davidv1992/Trans1/(list of files, drawings)

Other design files:
logic_sim/processor.circ
