davidv1992/Trans1/designs/adder/sel/sel.kicad_pcb

## KiCad design designs/adder/sel/sel.kicad_pcb (2025-08-03)

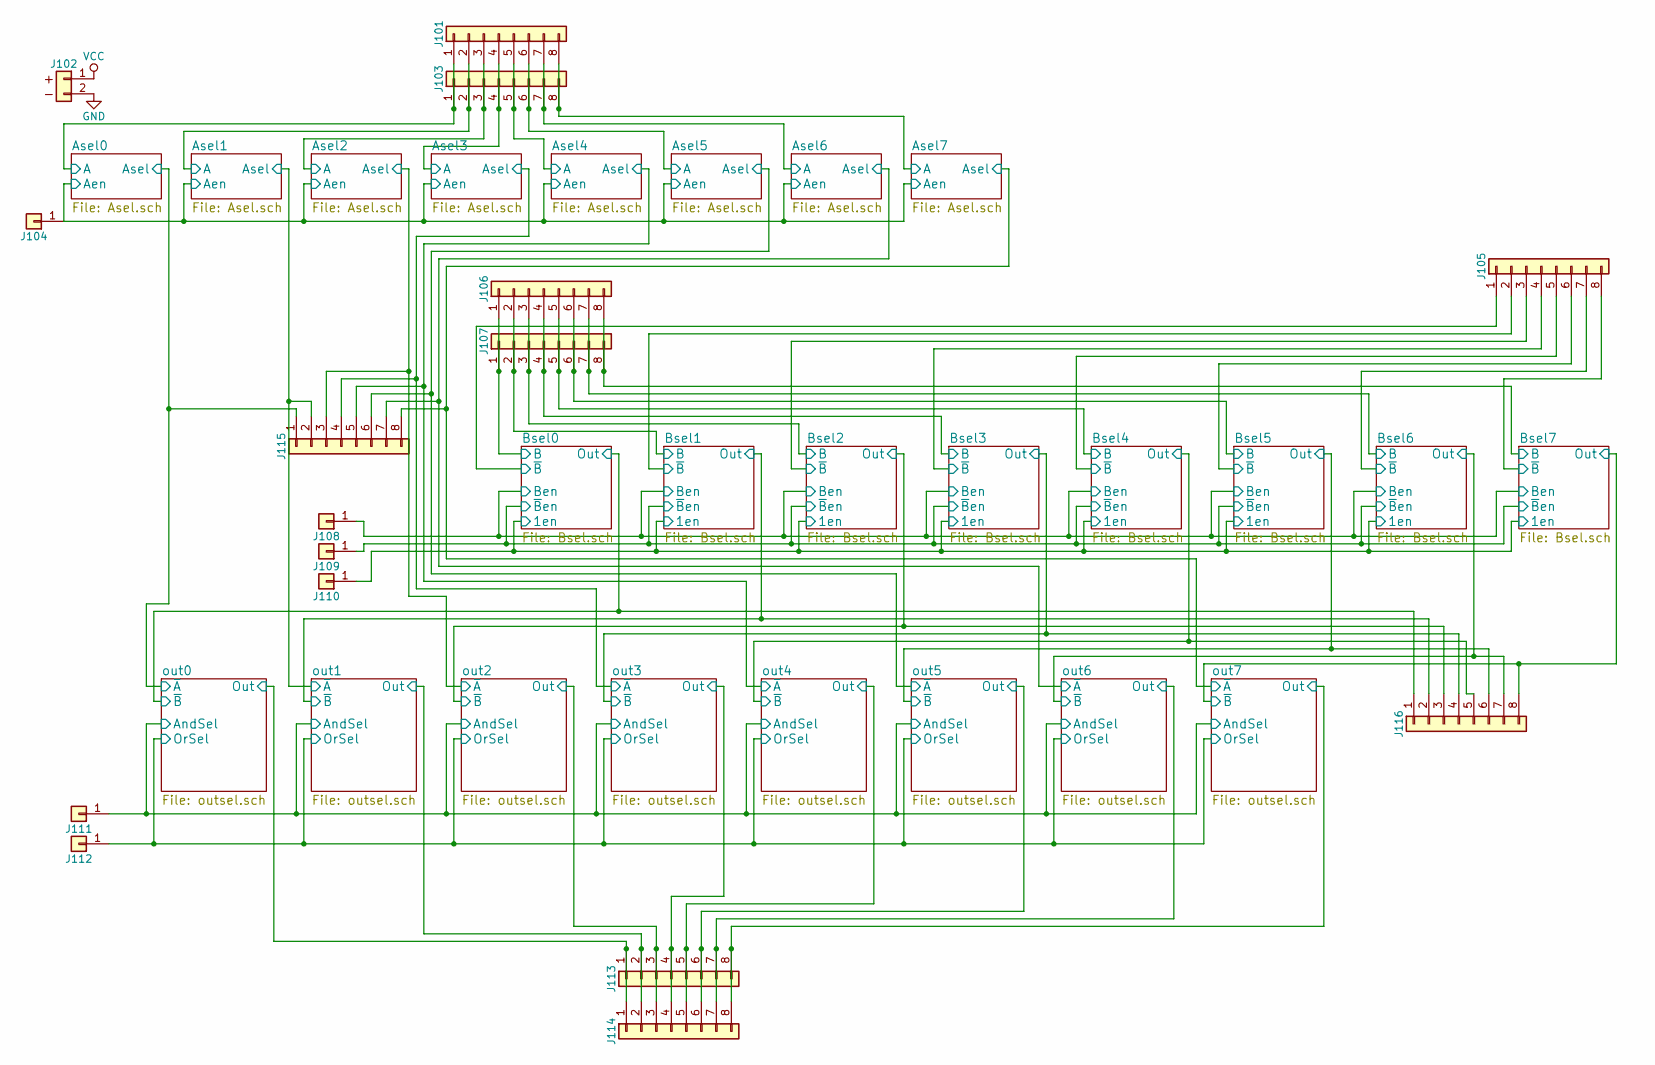
[picture p10: schematic sel.sch]

Parts:
J101, J103, J105, J106, J107, J113, J114, J115, J116: Conn_01x08; PH_1x8
J102: Conn_01x02_Power; PH_1x2
J104, J108, J109, J110, J111, J112: Conn_01x01; PH_1x1

Connections:
/Asel0/A: J101.1, J103.1; also elsewhere on the board
/Asel0/Aen: J104.1; also elsewhere on the board
/Asel0/Asel: J115.1; also elsewhere on the board
/Asel1/A: J101.2, J103.2; also elsewhere on the board
/Asel1/Asel: J115.2; also elsewhere on the board
/Asel2/A: J101.3, J103.3; also elsewhere on the board
/Asel2/Asel: J115.3; also elsewhere on the board
/Asel3/A: J101.4, J103.4; also elsewhere on the board
/Asel3/Asel: J115.4; also elsewhere on the board
/Asel4/A: J101.5, J103.5; also elsewhere on the board
/Asel4/Asel: J115.5; also elsewhere on the board
/Asel5/A: J101.6, J103.6; also elsewhere on the board
/Asel5/Asel: J115.6; also elsewhere on the board
/Asel6/A: J101.7, J103.7; also elsewhere on the board
/Asel6/Asel: J115.7; also elsewhere on the board
/Asel7/A: J101.8, J103.8; also elsewhere on the board
/Asel7/Asel: J115.8; also elsewhere on the board
/Bsel0/1en: J110.1; also elsewhere on the board
/Bsel0/B: J106.1, J107.1; also elsewhere on the board
/Bsel0/Ben: J108.1; also elsewhere on the board
/Bsel0/Out: J116.1; also elsewhere on the board
/Bsel0/~B~: J105.1; also elsewhere on the board
/Bsel0/~B~en: J109.1; also elsewhere on the board
/Bsel1/B: J106.2, J107.2; also elsewhere on the board
/Bsel1/Out: J116.2; also elsewhere on the board
/Bsel1/~B~: J105.2; also elsewhere on the board
/Bsel2/B: J106.3, J107.3; also elsewhere on the board
/Bsel2/Out: J116.3; also elsewhere on the board
/Bsel2/~B~: J105.3; also elsewhere on the board
/Bsel3/B: J106.4, J107.4; also elsewhere on the board
/Bsel3/Out: J116.4; also elsewhere on the board
/Bsel3/~B~: J105.4; also elsewhere on the board
/Bsel4/B: J106.5, J107.5; also elsewhere on the board
/Bsel4/Out: J116.5; also elsewhere on the board
/Bsel4/~B~: J105.5; also elsewhere on the board
/Bsel5/B: J106.6, J107.6; also elsewhere on the board
/Bsel5/Out: J116.6; also elsewhere on the board
/Bsel5/~B~: J105.6; also elsewhere on the board
/Bsel6/B: J106.7, J107.7; also elsewhere on the board
/Bsel6/Out: J116.7; also elsewhere on the board
/Bsel6/~B~: J105.7; also elsewhere on the board
/Bsel7/B: J106.8, J107.8; also elsewhere on the board
/Bsel7/Out: J116.8; also elsewhere on the board
/Bsel7/~B~: J105.8; also elsewhere on the board
/out0/AndSel: J111.1; also elsewhere on the board
/out0/OrSel: J112.1; also elsewhere on the board
/out0/Out: J113.1, J114.1; also elsewhere on the board
/out1/Out: J113.2, J114.2; also elsewhere on the board
/out2/Out: J113.3, J114.3; also elsewhere on the board
/out3/Out: J113.4, J114.4; also elsewhere on the board
/out4/Out: J113.5, J114.5; also elsewhere on the board
/out5/Out: J113.6, J114.6; also elsewhere on the board
/out6/Out: J113.7, J114.7; also elsewhere on the board
/out7/Out: J113.8, J114.8; also elsewhere on the board
GND: J102.2; also elsewhere on the board
VCC: J102.1; also elsewhere on the board

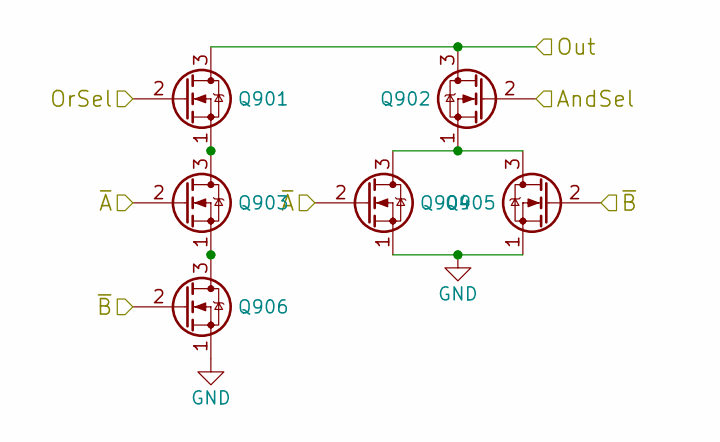
[picture p11: schematic outsel.sch]

Parts:
Q201, Q202, Q203, Q204, Q205, Q206: 2N7000; TO-92-FET

Connections:
/Asel0/Asel: Q203.2 (G), Q204.2 (G); also elsewhere on the board
/Bsel0/Out: Q205.2 (G), Q206.2 (G); also elsewhere on the board
/out0/AndSel: Q202.2 (G); also elsewhere on the board
/out0/OrSel: Q201.2 (G); also elsewhere on the board
/out0/Out: Q201.3 (D), Q202.3 (D); also elsewhere on the board
GND: Q204.1 (S), Q205.1 (S), Q206.1 (S); also elsewhere on the board
unnamed: Q201.1 (S), Q203.3 (D)
unnamed: Q202.1 (S), Q204.3 (D), Q205.3 (D)
unnamed: Q203.1 (S), Q206.3 (D)

Parts of its further copies:
Q301, Q302, Q303, Q304, Q305, Q306, Q401, Q402, Q403, Q404, Q405, Q406, Q501, Q502, Q503, Q504, Q505, Q506, Q601, Q602, Q603, Q604, Q605, Q606, Q701, Q702, Q703, Q704, Q705, Q706, Q801, Q802, Q803, Q804, Q805, Q806, Q901, Q902, Q903, Q904, Q905, Q906: 2N7000; TO-92-FET

Connections of its further copies:
/Asel1/Asel: Q903.2 (G), Q904.2 (G); also elsewhere on the board
/Asel2/Asel: Q303.2 (G), Q304.2 (G); also elsewhere on the board
/Asel3/Asel: Q403.2 (G), Q404.2 (G); also elsewhere on the board
/Asel4/Asel: Q503.2 (G), Q504.2 (G); also elsewhere on the board
/Asel5/Asel: Q603.2 (G), Q604.2 (G); also elsewhere on the board
/Asel6/Asel: Q703.2 (G), Q704.2 (G); also elsewhere on the board
/Asel7/Asel: Q803.2 (G), Q804.2 (G); also elsewhere on the board
/Bsel1/Out: Q905.2 (G), Q906.2 (G); also elsewhere on the board
/Bsel2/Out: Q305.2 (G), Q306.2 (G); also elsewhere on the board
/Bsel3/Out: Q405.2 (G), Q406.2 (G); also elsewhere on the board
/Bsel4/Out: Q505.2 (G), Q506.2 (G); also elsewhere on the board
/Bsel5/Out: Q605.2 (G), Q606.2 (G); also elsewhere on the board
/Bsel6/Out: Q705.2 (G), Q706.2 (G); also elsewhere on the board
/Bsel7/Out: Q805.2 (G), Q806.2 (G); also elsewhere on the board
/out0/AndSel: Q302.2 (G), Q402.2 (G), Q502.2 (G), Q602.2 (G), Q702.2 (G), Q802.2 (G), Q902.2 (G); also elsewhere on the board
/out0/OrSel: Q301.2 (G), Q401.2 (G), Q501.2 (G), Q601.2 (G), Q701.2 (G), Q801.2 (G), Q901.2 (G); also elsewhere on the board
/out1/Out: Q901.3 (D), Q902.3 (D); also elsewhere on the board
/out2/Out: Q301.3 (D), Q302.3 (D); also elsewhere on the board
/out3/Out: Q401.3 (D), Q402.3 (D); also elsewhere on the board
/out4/Out: Q501.3 (D), Q502.3 (D); also elsewhere on the board
/out5/Out: Q601.3 (D), Q602.3 (D); also elsewhere on the board
/out6/Out: Q701.3 (D), Q702.3 (D); also elsewhere on the board
/out7/Out: Q801.3 (D), Q802.3 (D); also elsewhere on the board
GND: Q304.1 (S), Q305.1 (S), Q306.1 (S), Q404.1 (S), Q405.1 (S), Q406.1 (S), Q504.1 (S), Q505.1 (S), Q506.1 (S), Q604.1 (S), Q605.1 (S), Q606.1 (S), Q704.1 (S), Q705.1 (S), Q706.1 (S), Q804.1 (S), Q805.1 (S), Q806.1 (S), Q904.1 (S), Q905.1 (S), Q906.1 (S); also elsewhere on the board
unnamed: Q301.1 (S), Q303.3 (D)
unnamed: Q302.1 (S), Q304.3 (D), Q305.3 (D)
unnamed: Q303.1 (S), Q306.3 (D)
unnamed: Q401.1 (S), Q403.3 (D)
unnamed: Q402.1 (S), Q404.3 (D), Q405.3 (D)
unnamed: Q403.1 (S), Q406.3 (D)
unnamed: Q501.1 (S), Q503.3 (D)
unnamed: Q502.1 (S), Q504.3 (D), Q505.3 (D)
unnamed: Q503.1 (S), Q506.3 (D)
unnamed: Q601.1 (S), Q603.3 (D)
unnamed: Q602.1 (S), Q604.3 (D), Q605.3 (D)
unnamed: Q603.1 (S), Q606.3 (D)
unnamed: Q701.1 (S), Q703.3 (D)
unnamed: Q702.1 (S), Q704.3 (D), Q705.3 (D)
unnamed: Q703.1 (S), Q706.3 (D)
unnamed: Q801.1 (S), Q803.3 (D)
unnamed: Q802.1 (S), Q804.3 (D), Q805.3 (D)
unnamed: Q803.1 (S), Q806.3 (D)
unnamed: Q901.1 (S), Q903.3 (D)
unnamed: Q902.1 (S), Q904.3 (D), Q905.3 (D)
unnamed: Q903.1 (S), Q906.3 (D)

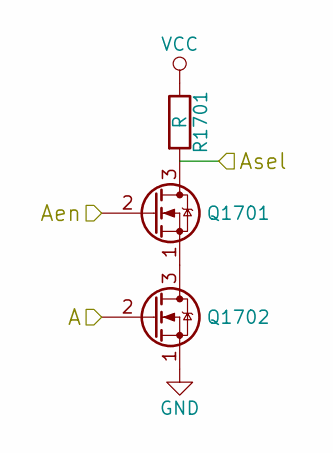
[picture p12: schematic Asel.sch]

Parts:
Q1001, Q1002: 2N7000; TO-92-FET
R1001: R; R_small

Connections:
/Asel0/A: Q1002.2 (G); also elsewhere on the board
/Asel0/Aen: Q1001.2 (G); also elsewhere on the board
/Asel0/Asel: Q1001.3 (D), R1001.2; also elsewhere on the board
GND: Q1002.1 (S); also elsewhere on the board
unnamed: Q1001.1 (S), Q1002.3 (D)
VCC: R1001.1; also elsewhere on the board

Parts of its further copies:
Q1101, Q1102, Q1201, Q1202, Q1301, Q1302, Q1401, Q1402, Q1501, Q1502, Q1601, Q1602, Q1701, Q1702: 2N7000; TO-92-FET
R1101, R1201, R1301, R1401, R1501, R1601, R1701: R; R_small

Connections of its further copies:
/Asel0/Aen: Q1101.2 (G), Q1201.2 (G), Q1301.2 (G), Q1401.2 (G), Q1501.2 (G), Q1601.2 (G), Q1701.2 (G); also elsewhere on the board
/Asel1/A: Q1102.2 (G); also elsewhere on the board
/Asel1/Asel: Q1101.3 (D), R1101.2; also elsewhere on the board
/Asel2/A: Q1202.2 (G); also elsewhere on the board
/Asel2/Asel: Q1201.3 (D), R1201.2; also elsewhere on the board
/Asel3/A: Q1302.2 (G); also elsewhere on the board
/Asel3/Asel: Q1301.3 (D), R1301.2; also elsewhere on the board
/Asel4/A: Q1402.2 (G); also elsewhere on the board
/Asel4/Asel: Q1401.3 (D), R1401.2; also elsewhere on the board
/Asel5/A: Q1502.2 (G); also elsewhere on the board
/Asel5/Asel: Q1501.3 (D), R1501.2; also elsewhere on the board
/Asel6/A: Q1602.2 (G); also elsewhere on the board
/Asel6/Asel: Q1601.3 (D), R1601.2; also elsewhere on the board
/Asel7/A: Q1702.2 (G); also elsewhere on the board
/Asel7/Asel: Q1701.3 (D), R1701.2; also elsewhere on the board
GND: Q1102.1 (S), Q1202.1 (S), Q1302.1 (S), Q1402.1 (S), Q1502.1 (S), Q1602.1 (S), Q1702.1 (S); also elsewhere on the board
unnamed: Q1101.1 (S), Q1102.3 (D)
unnamed: Q1201.1 (S), Q1202.3 (D)
unnamed: Q1301.1 (S), Q1302.3 (D)
unnamed: Q1401.1 (S), Q1402.3 (D)
unnamed: Q1501.1 (S), Q1502.3 (D)
unnamed: Q1601.1 (S), Q1602.3 (D)
unnamed: Q1701.1 (S), Q1702.3 (D)
VCC: R1101.1, R1201.1, R1301.1, R1401.1, R1501.1, R1601.1, R1701.1; also elsewhere on the board

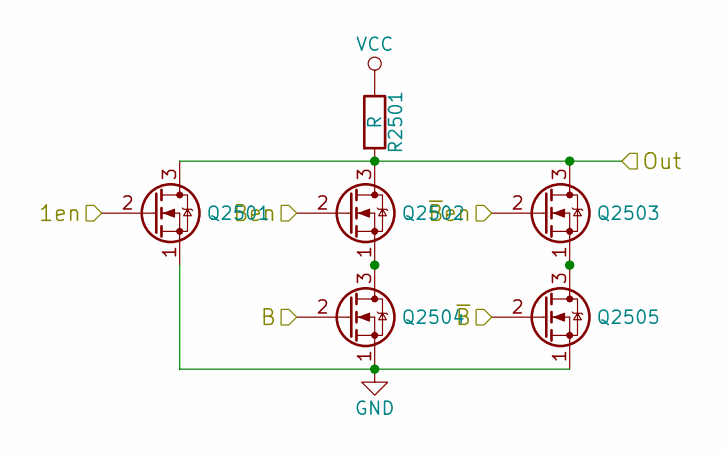
[picture p13: schematic Bsel.sch]

Parts:
Q1801, Q1802, Q1803, Q1804, Q1805: 2N7000; TO-92-FET
R1801: R; R_small

Connections:
/Bsel0/1en: Q1801.2 (G); also elsewhere on the board
/Bsel0/B: Q1804.2 (G); also elsewhere on the board
/Bsel0/Ben: Q1802.2 (G); also elsewhere on the board
/Bsel0/Out: Q1801.3 (D), Q1802.3 (D), Q1803.3 (D), R1801.2; also elsewhere on the board
/Bsel0/~B~: Q1805.2 (G); also elsewhere on the board
/Bsel0/~B~en: Q1803.2 (G); also elsewhere on the board
GND: Q1801.1 (S), Q1804.1 (S), Q1805.1 (S); also elsewhere on the board
unnamed: Q1802.1 (S), Q1804.3 (D)
unnamed: Q1803.1 (S), Q1805.3 (D)
VCC: R1801.1; also elsewhere on the board

Parts of its further copies:
Q1901, Q1902, Q1903, Q1904, Q1905, Q2001, Q2002, Q2003, Q2004, Q2005, Q2101, Q2102, Q2103, Q2104, Q2105, Q2201, Q2202, Q2203, Q2204, Q2205, Q2301, Q2302, Q2303, Q2304, Q2305, Q2401, Q2402, Q2403, Q2404, Q2405, Q2501, Q2502, Q2503, Q2504, Q2505: 2N7000; TO-92-FET
R1901, R2001, R2101, R2201, R2301, R2401, R2501: R; R_small

Connections of its further copies:
/Bsel0/1en: Q1901.2 (G), Q2001.2 (G), Q2101.2 (G), Q2201.2 (G), Q2301.2 (G), Q2401.2 (G), Q2501.2 (G); also elsewhere on the board
/Bsel0/Ben: Q1902.2 (G), Q2002.2 (G), Q2102.2 (G), Q2202.2 (G), Q2302.2 (G), Q2402.2 (G), Q2502.2 (G); also elsewhere on the board
/Bsel0/~B~en: Q1903.2 (G), Q2003.2 (G), Q2103.2 (G), Q2203.2 (G), Q2303.2 (G), Q2403.2 (G), Q2503.2 (G); also elsewhere on the board
/Bsel1/B: Q1904.2 (G); also elsewhere on the board
/Bsel1/Out: Q1901.3 (D), Q1902.3 (D), Q1903.3 (D), R1901.2; also elsewhere on the board
/Bsel1/~B~: Q1905.2 (G); also elsewhere on the board
/Bsel2/B: Q2004.2 (G); also elsewhere on the board
/Bsel2/Out: Q2001.3 (D), Q2002.3 (D), Q2003.3 (D), R2001.2; also elsewhere on the board
/Bsel2/~B~: Q2005.2 (G); also elsewhere on the board
/Bsel3/B: Q2104.2 (G); also elsewhere on the board
/Bsel3/Out: Q2101.3 (D), Q2102.3 (D), Q2103.3 (D), R2101.2; also elsewhere on the board
/Bsel3/~B~: Q2105.2 (G); also elsewhere on the board
/Bsel4/B: Q2204.2 (G); also elsewhere on the board
/Bsel4/Out: Q2201.3 (D), Q2202.3 (D), Q2203.3 (D), R2201.2; also elsewhere on the board
/Bsel4/~B~: Q2205.2 (G); also elsewhere on the board
/Bsel5/B: Q2304.2 (G); also elsewhere on the board
/Bsel5/Out: Q2301.3 (D), Q2302.3 (D), Q2303.3 (D), R2301.2; also elsewhere on the board
/Bsel5/~B~: Q2305.2 (G); also elsewhere on the board
/Bsel6/B: Q2404.2 (G); also elsewhere on the board
/Bsel6/Out: Q2401.3 (D), Q2402.3 (D), Q2403.3 (D), R2401.2; also elsewhere on the board
/Bsel6/~B~: Q2405.2 (G); also elsewhere on the board
/Bsel7/B: Q2504.2 (G); also elsewhere on the board
/Bsel7/Out: Q2501.3 (D), Q2502.3 (D), Q2503.3 (D), R2501.2; also elsewhere on the board
/Bsel7/~B~: Q2505.2 (G); also elsewhere on the board
GND: Q1901.1 (S), Q1904.1 (S), Q1905.1 (S), Q2001.1 (S), Q2004.1 (S), Q2005.1 (S), Q2101.1 (S), Q2104.1 (S), Q2105.1 (S), Q2201.1 (S), Q2204.1 (S), Q2205.1 (S), Q2301.1 (S), Q2304.1 (S), Q2305.1 (S), Q2401.1 (S), Q2404.1 (S), Q2405.1 (S), Q2501.1 (S), Q2504.1 (S), Q2505.1 (S); also elsewhere on the board
unnamed: Q1902.1 (S), Q1904.3 (D)
unnamed: Q1903.1 (S), Q1905.3 (D)
unnamed: Q2002.1 (S), Q2004.3 (D)
unnamed: Q2003.1 (S), Q2005.3 (D)
unnamed: Q2102.1 (S), Q2104.3 (D)
unnamed: Q2103.1 (S), Q2105.3 (D)
unnamed: Q2202.1 (S), Q2204.3 (D)
unnamed: Q2203.1 (S), Q2205.3 (D)
unnamed: Q2302.1 (S), Q2304.3 (D)
unnamed: Q2303.1 (S), Q2305.3 (D)
unnamed: Q2402.1 (S), Q2404.3 (D)
unnamed: Q2403.1 (S), Q2405.3 (D)
unnamed: Q2502.1 (S), Q2504.3 (D)
unnamed: Q2503.1 (S), Q2505.3 (D)
VCC: R1901.1, R2001.1, R2101.1, R2201.1, R2301.1, R2401.1, R2501.1; also elsewhere on the board

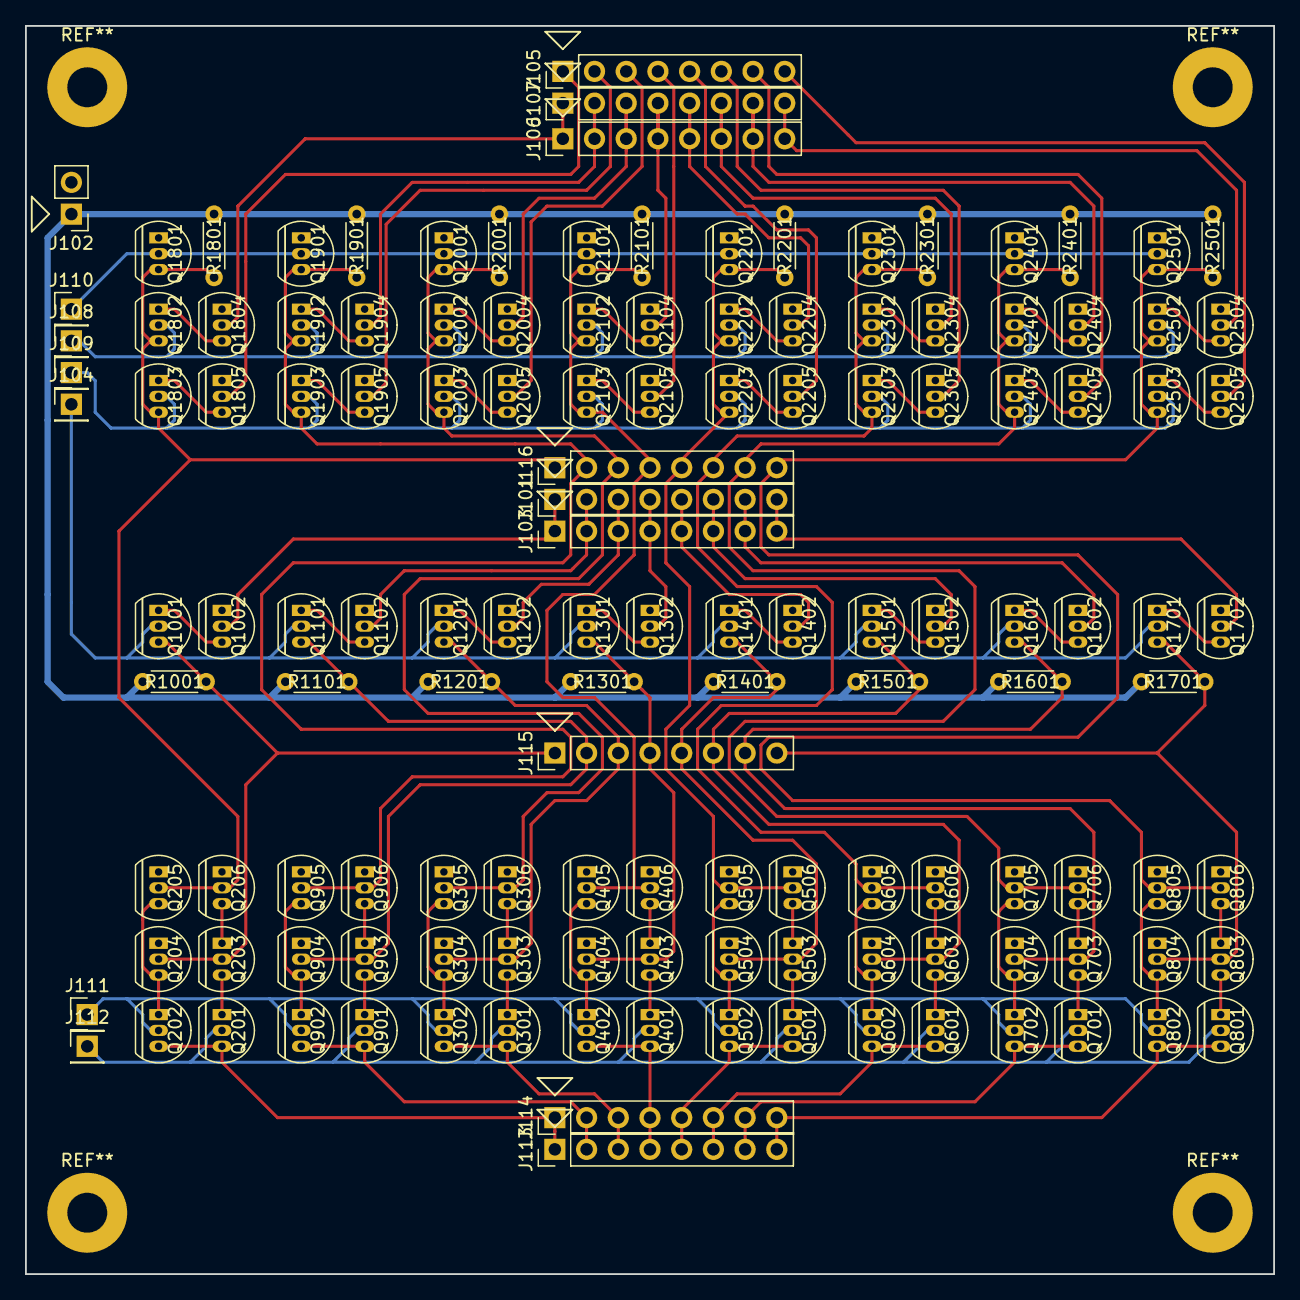
[picture p14: board sel.kicad_pcb from above]

Board: 2 copper layers, 100.0 x 100.0 mm, 136 parts (0 on the bottom side), 104 nets.
