davidv1992/Trans1/designs/memory/membase/membase.kicad_pcb

## KiCad design designs/memory/membase/membase.kicad_pcb (2025-08-03)

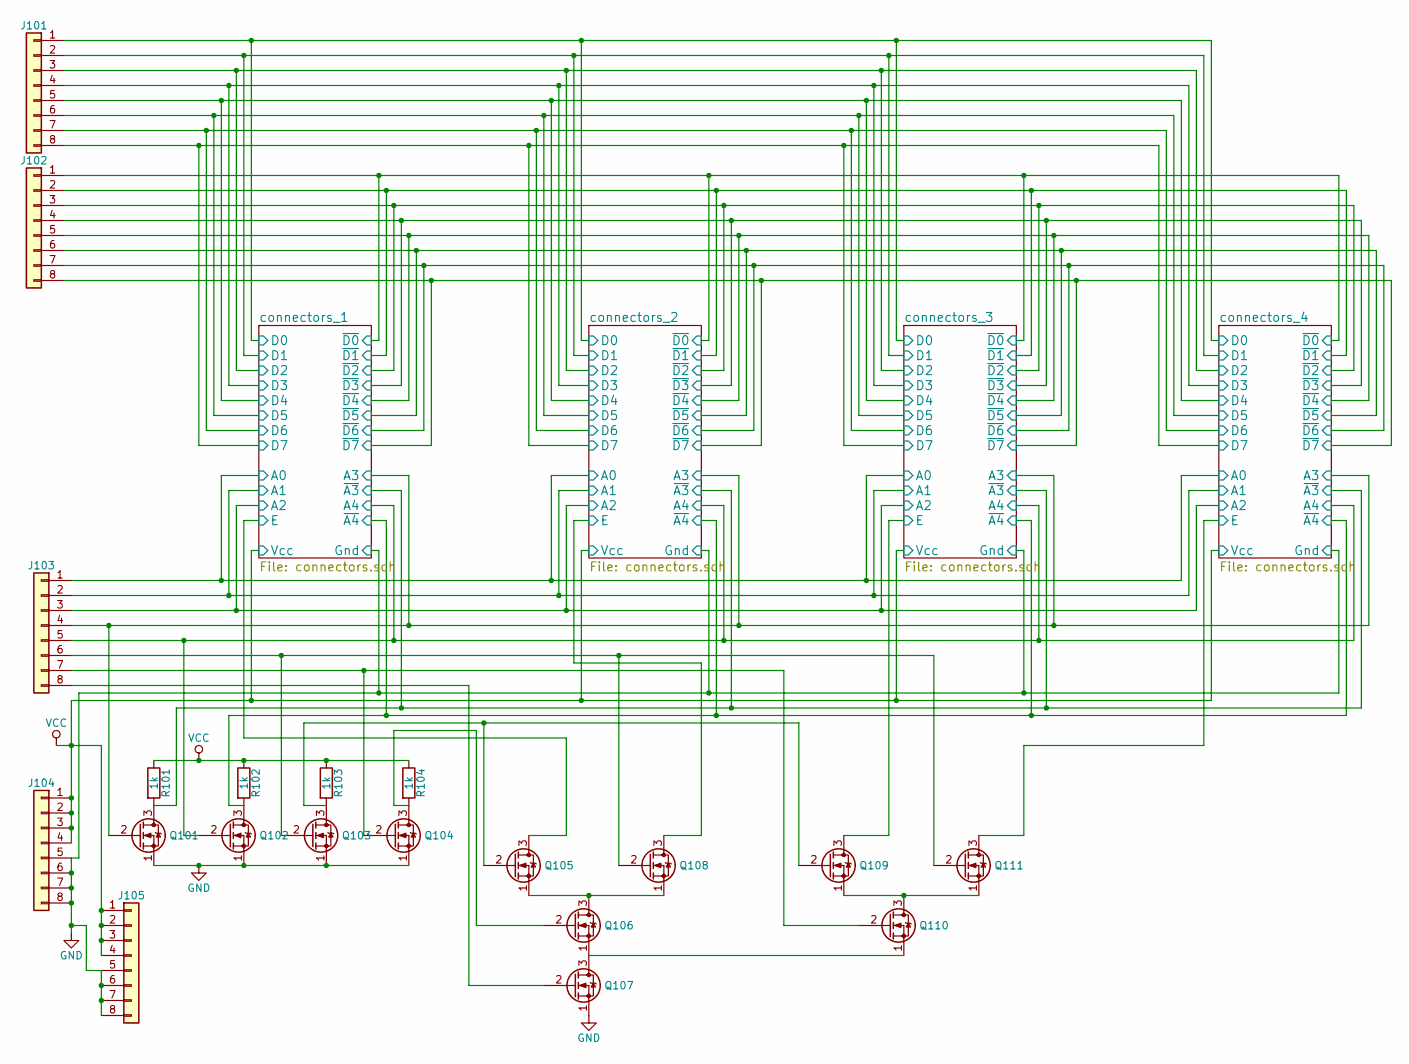
[picture p15: schematic membase.sch]

Parts:
J101, J102, J103, J104, J105: Conn_01x08; PH_1x8
Q101, Q102, Q103, Q104, Q105, Q106, Q107, Q108, Q109, Q110, Q111: 2N7000; TO-92-FET
R101, R102, R103, R104: 1k; R_small

Connections:
/connectors_1/A0: J103.1; also elsewhere on the board
/connectors_1/A1: J103.2; also elsewhere on the board
/connectors_1/A2: J103.3; also elsewhere on the board
/connectors_1/A3: J103.4, Q101.2 (G); also elsewhere on the board
/connectors_1/A4: J103.5, Q102.2 (G); also elsewhere on the board
/connectors_1/D0: J101.1; also elsewhere on the board
/connectors_1/D1: J101.2; also elsewhere on the board
/connectors_1/D2: J101.3; also elsewhere on the board
/connectors_1/D3: J101.4; also elsewhere on the board
/connectors_1/D4: J101.5; also elsewhere on the board
/connectors_1/D5: J101.6; also elsewhere on the board
/connectors_1/D6: J101.7; also elsewhere on the board
/connectors_1/D7: J101.8; also elsewhere on the board
/connectors_1/E: Q105.3 (D); also elsewhere on the board
/connectors_1/~A3: Q101.3 (D), R101.2; also elsewhere on the board
/connectors_1/~A4: Q102.3 (D), R102.2; also elsewhere on the board
/connectors_1/~D0: J102.1; also elsewhere on the board
/connectors_1/~D1: J102.2; also elsewhere on the board
/connectors_1/~D2: J102.3; also elsewhere on the board
/connectors_1/~D3: J102.4; also elsewhere on the board
/connectors_1/~D4: J102.5; also elsewhere on the board
/connectors_1/~D5: J102.6; also elsewhere on the board
/connectors_1/~D6: J102.7; also elsewhere on the board
/connectors_1/~D7: J102.8; also elsewhere on the board
/connectors_2/E: Q108.3 (D); also elsewhere on the board
/connectors_3/E: Q109.3 (D); also elsewhere on the board
/connectors_4/E: Q111.3 (D); also elsewhere on the board
GND: J104.5, J104.6, J104.7, J104.8, J105.5, J105.6, J105.7, J105.8, Q101.1 (S), Q102.1 (S), Q103.1 (S), Q104.1 (S), Q107.1 (S); also elsewhere on the board
unnamed: J103.6, Q103.2 (G), Q108.2 (G), Q111.2 (G)
unnamed: J103.7, Q104.2 (G), Q110.2 (G)
unnamed: J103.8, Q107.2 (G)
unnamed: Q103.3 (D), Q105.2 (G), Q109.2 (G), R103.2
unnamed: Q104.3 (D), Q106.2 (G), R104.2
unnamed: Q105.1 (S), Q106.3 (D), Q108.1 (S)
unnamed: Q106.1 (S), Q107.3 (D), Q110.1 (S)
unnamed: Q109.1 (S), Q110.3 (D), Q111.1 (S)
VCC: J104.1, J104.2, J104.3, J104.4, J105.1, J105.2, J105.3, J105.4, R101.1, R102.1, R103.1, R104.1; also elsewhere on the board

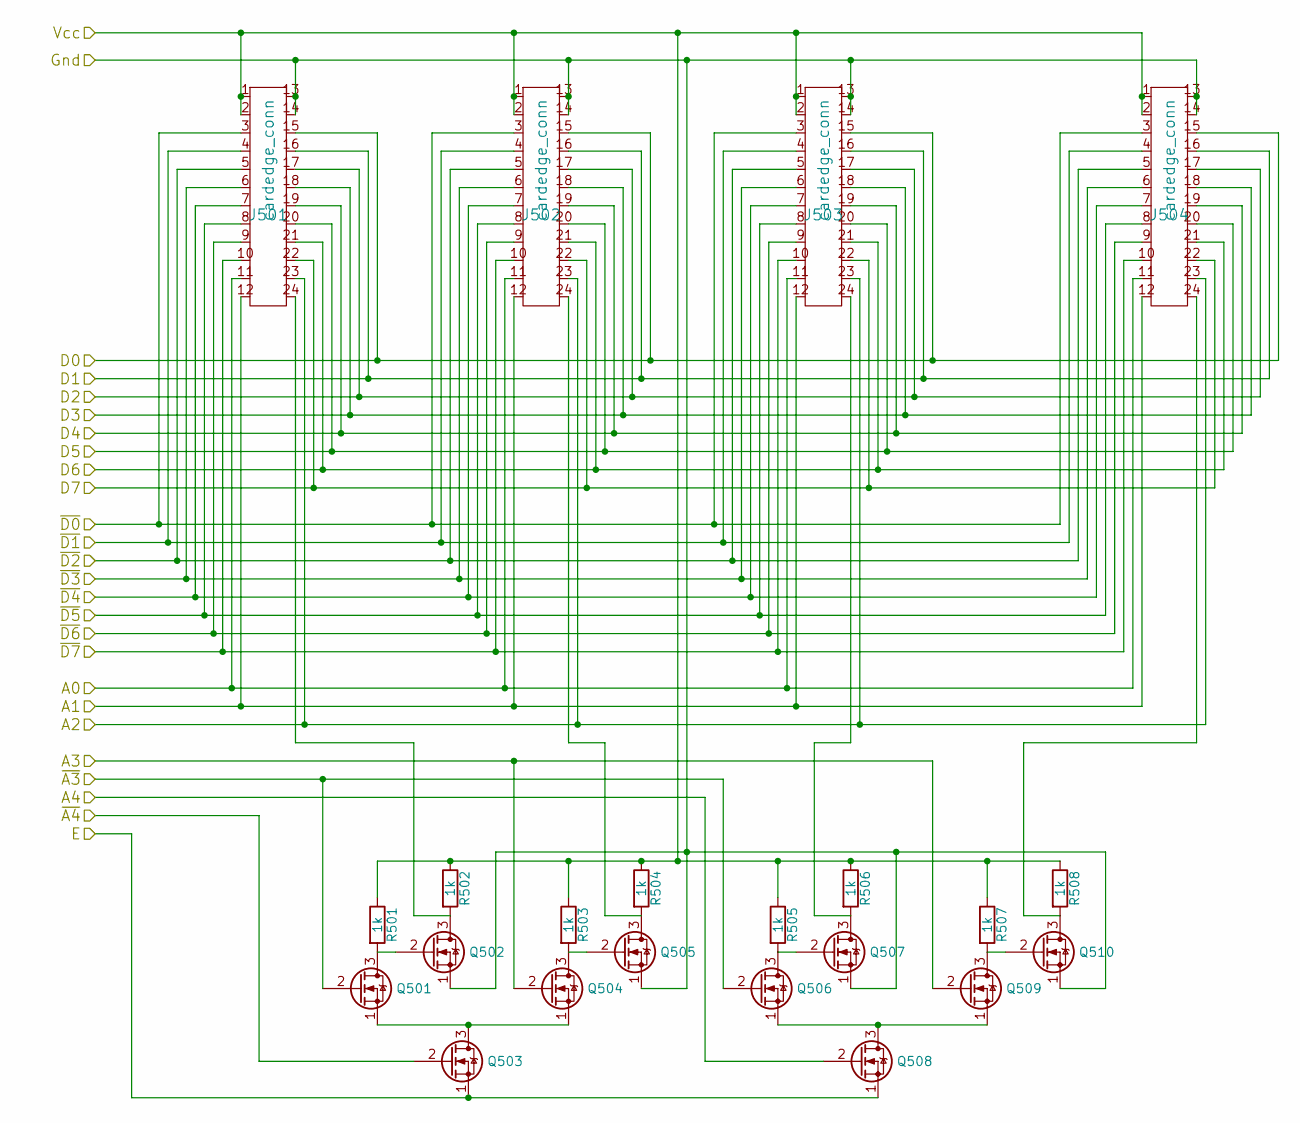
[picture p16: schematic connectors.sch]

Parts:
J201, J202, J203, J204: cardedge_conn; cardedge_conn_12p
Q201, Q202, Q203, Q204, Q205, Q206, Q207, Q208, Q209, Q210: 2N7000; TO-92-FET
R201, R202, R203, R204, R205, R206, R207, R208: 1k; R_small

Connections:
/connectors_1/A0: J201.11, J202.11, J203.11, J204.11; also elsewhere on the board
/connectors_1/A1: J201.12, J202.12, J203.12, J204.12; also elsewhere on the board
/connectors_1/A2: J201.23, J202.23, J203.23, J204.23; also elsewhere on the board
/connectors_1/A3: Q204.2 (G), Q209.2 (G); also elsewhere on the board
/connectors_1/A4: Q208.2 (G); also elsewhere on the board
/connectors_1/D0: J201.15, J202.15, J203.15, J204.15; also elsewhere on the board
/connectors_1/D1: J201.16, J202.16, J203.16, J204.16; also elsewhere on the board
/connectors_1/D2: J201.17, J202.17, J203.17, J204.17; also elsewhere on the board
/connectors_1/D3: J201.18, J202.18, J203.18, J204.18; also elsewhere on the board
/connectors_1/D4: J201.19, J202.19, J203.19, J204.19; also elsewhere on the board
/connectors_1/D5: J201.20, J202.20, J203.20, J204.20; also elsewhere on the board
/connectors_1/D6: J201.21, J202.21, J203.21, J204.21; also elsewhere on the board
/connectors_1/D7: J201.22, J202.22, J203.22, J204.22; also elsewhere on the board
/connectors_1/E: Q203.1 (S), Q208.1 (S); also elsewhere on the board
/connectors_1/~A3: Q201.2 (G), Q206.2 (G); also elsewhere on the board
/connectors_1/~A4: Q203.2 (G); also elsewhere on the board
/connectors_1/~D0: J201.3, J202.3, J203.3, J204.3; also elsewhere on the board
/connectors_1/~D1: J201.4, J202.4, J203.4, J204.4; also elsewhere on the board
/connectors_1/~D2: J201.5, J202.5, J203.5, J204.5; also elsewhere on the board
/connectors_1/~D3: J201.6, J202.6, J203.6, J204.6; also elsewhere on the board
/connectors_1/~D4: J201.7, J202.7, J203.7, J204.7; also elsewhere on the board
/connectors_1/~D5: J201.8, J202.8, J203.8, J204.8; also elsewhere on the board
/connectors_1/~D6: J201.9, J202.9, J203.9, J204.9; also elsewhere on the board
/connectors_1/~D7: J201.10, J202.10, J203.10, J204.10; also elsewhere on the board
GND: J201.13, J201.14, J202.13, J202.14, J203.13, J203.14, J204.13, J204.14, Q202.1 (S), Q205.1 (S), Q207.1 (S), Q210.1 (S); also elsewhere on the board
unnamed: J201.24, Q202.3 (D), R202.2
unnamed: J202.24, Q205.3 (D), R204.2
unnamed: J203.24, Q207.3 (D), R206.2
unnamed: J204.24, Q210.3 (D), R208.2
unnamed: Q201.1 (S), Q203.3 (D), Q204.1 (S)
unnamed: Q201.3 (D), Q202.2 (G), R201.2
unnamed: Q204.3 (D), Q205.2 (G), R203.2
unnamed: Q206.1 (S), Q208.3 (D), Q209.1 (S)
unnamed: Q206.3 (D), Q207.2 (G), R205.2
unnamed: Q209.3 (D), Q210.2 (G), R207.2
VCC: J201.1, J201.2, J202.1, J202.2, J203.1, J203.2, J204.1, J204.2, R201.1, R202.1, R203.1, R204.1, R205.1, R206.1, R207.1, R208.1; also elsewhere on the board

Parts of its further copies:
J301, J302, J303, J304, J401, J402, J403, J404, J501, J502, J503, J504: cardedge_conn; cardedge_conn_12p
Q301, Q302, Q303, Q304, Q305, Q306, Q307, Q308, Q309, Q310, Q401, Q402, Q403, Q404, Q405, Q406, Q407, Q408, Q409, Q410, Q501, Q502, Q503, Q504, Q505, Q506, Q507, Q508, Q509, Q510: 2N7000; TO-92-FET
R301, R302, R303, R304, R305, R306, R307, R308, R401, R402, R403, R404, R405, R406, R407, R408, R501, R502, R503, R504, R505, R506, R507, R508: 1k; R_small

Connections of its further copies:
/connectors_1/A0: J301.11, J302.11, J303.11, J304.11, J401.11, J402.11, J403.11, J404.11, J501.11, J502.11, J503.11, J504.11; also elsewhere on the board
/connectors_1/A1: J301.12, J302.12, J303.12, J304.12, J401.12, J402.12, J403.12, J404.12, J501.12, J502.12, J503.12, J504.12; also elsewhere on the board
/connectors_1/A2: J301.23, J302.23, J303.23, J304.23, J401.23, J402.23, J403.23, J404.23, J501.23, J502.23, J503.23, J504.23; also elsewhere on the board
/connectors_1/A3: Q304.2 (G), Q309.2 (G), Q404.2 (G), Q409.2 (G), Q504.2 (G), Q509.2 (G); also elsewhere on the board
/connectors_1/A4: Q308.2 (G), Q408.2 (G), Q508.2 (G); also elsewhere on the board
/connectors_1/D0: J301.15, J302.15, J303.15, J304.15, J401.15, J402.15, J403.15, J404.15, J501.15, J502.15, J503.15, J504.15; also elsewhere on the board
/connectors_1/D1: J301.16, J302.16, J303.16, J304.16, J401.16, J402.16, J403.16, J404.16, J501.16, J502.16, J503.16, J504.16; also elsewhere on the board
/connectors_1/D2: J301.17, J302.17, J303.17, J304.17, J401.17, J402.17, J403.17, J404.17, J501.17, J502.17, J503.17, J504.17; also elsewhere on the board
/connectors_1/D3: J301.18, J302.18, J303.18, J304.18, J401.18, J402.18, J403.18, J404.18, J501.18, J502.18, J503.18, J504.18; also elsewhere on the board
/connectors_1/D4: J301.19, J302.19, J303.19, J304.19, J401.19, J402.19, J403.19, J404.19, J501.19, J502.19, J503.19, J504.19; also elsewhere on the board
/connectors_1/D5: J301.20, J302.20, J303.20, J304.20, J401.20, J402.20, J403.20, J404.20, J501.20, J502.20, J503.20, J504.20; also elsewhere on the board
/connectors_1/D6: J301.21, J302.21, J303.21, J304.21, J401.21, J402.21, J403.21, J404.21, J501.21, J502.21, J503.21, J504.21; also elsewhere on the board
/connectors_1/D7: J301.22, J302.22, J303.22, J304.22, J401.22, J402.22, J403.22, J404.22, J501.22, J502.22, J503.22, J504.22; also elsewhere on the board
/connectors_1/~A3: Q301.2 (G), Q306.2 (G), Q401.2 (G), Q406.2 (G), Q501.2 (G), Q506.2 (G); also elsewhere on the board
/connectors_1/~A4: Q303.2 (G), Q403.2 (G), Q503.2 (G); also elsewhere on the board
/connectors_1/~D0: J301.3, J302.3, J303.3, J304.3, J401.3, J402.3, J403.3, J404.3, J501.3, J502.3, J503.3, J504.3; also elsewhere on the board
/connectors_1/~D1: J301.4, J302.4, J303.4, J304.4, J401.4, J402.4, J403.4, J404.4, J501.4, J502.4, J503.4, J504.4; also elsewhere on the board
/connectors_1/~D2: J301.5, J302.5, J303.5, J304.5, J401.5, J402.5, J403.5, J404.5, J501.5, J502.5, J503.5, J504.5; also elsewhere on the board
/connectors_1/~D3: J301.6, J302.6, J303.6, J304.6, J401.6, J402.6, J403.6, J404.6, J501.6, J502.6, J503.6, J504.6; also elsewhere on the board
/connectors_1/~D4: J301.7, J302.7, J303.7, J304.7, J401.7, J402.7, J403.7, J404.7, J501.7, J502.7, J503.7, J504.7; also elsewhere on the board
/connectors_1/~D5: J301.8, J302.8, J303.8, J304.8, J401.8, J402.8, J403.8, J404.8, J501.8, J502.8, J503.8, J504.8; also elsewhere on the board
/connectors_1/~D6: J301.9, J302.9, J303.9, J304.9, J401.9, J402.9, J403.9, J404.9, J501.9, J502.9, J503.9, J504.9; also elsewhere on the board
/connectors_1/~D7: J301.10, J302.10, J303.10, J304.10, J401.10, J402.10, J403.10, J404.10, J501.10, J502.10, J503.10, J504.10; also elsewhere on the board
/connectors_2/E: Q303.1 (S), Q308.1 (S); also elsewhere on the board
/connectors_3/E: Q403.1 (S), Q408.1 (S); also elsewhere on the board
/connectors_4/E: Q503.1 (S), Q508.1 (S); also elsewhere on the board
GND: J301.13, J301.14, J302.13, J302.14, J303.13, J303.14, J304.13, J304.14, J401.13, J401.14, J402.13, J402.14, J403.13, J403.14, J404.13, J404.14, J501.13, J501.14, J502.13, J502.14, J503.13, J503.14, J504.13, J504.14, Q302.1 (S), Q305.1 (S), Q307.1 (S), Q310.1 (S), Q402.1 (S), Q405.1 (S), Q407.1 (S), Q410.1 (S), Q502.1 (S), Q505.1 (S), Q507.1 (S), Q510.1 (S); also elsewhere on the board
unnamed: J301.24, Q302.3 (D), R302.2
unnamed: J302.24, Q305.3 (D), R304.2
unnamed: J303.24, Q307.3 (D), R306.2
unnamed: J304.24, Q310.3 (D), R308.2
unnamed: J401.24, Q402.3 (D), R402.2
unnamed: J402.24, Q405.3 (D), R404.2
unnamed: J403.24, Q407.3 (D), R406.2
unnamed: J404.24, Q410.3 (D), R408.2
unnamed: J501.24, Q502.3 (D), R502.2
unnamed: J502.24, Q505.3 (D), R504.2
unnamed: J503.24, Q507.3 (D), R506.2
unnamed: J504.24, Q510.3 (D), R508.2
unnamed: Q301.1 (S), Q303.3 (D), Q304.1 (S)
unnamed: Q301.3 (D), Q302.2 (G), R301.2
unnamed: Q304.3 (D), Q305.2 (G), R303.2
unnamed: Q306.1 (S), Q308.3 (D), Q309.1 (S)
unnamed: Q306.3 (D), Q307.2 (G), R305.2
unnamed: Q309.3 (D), Q310.2 (G), R307.2
unnamed: Q401.1 (S), Q403.3 (D), Q404.1 (S)
unnamed: Q401.3 (D), Q402.2 (G), R401.2
unnamed: Q404.3 (D), Q405.2 (G), R403.2
unnamed: Q406.1 (S), Q408.3 (D), Q409.1 (S)
unnamed: Q406.3 (D), Q407.2 (G), R405.2
unnamed: Q409.3 (D), Q410.2 (G), R407.2
unnamed: Q501.1 (S), Q503.3 (D), Q504.1 (S)
unnamed: Q501.3 (D), Q502.2 (G), R501.2
unnamed: Q504.3 (D), Q505.2 (G), R503.2
unnamed: Q506.1 (S), Q508.3 (D), Q509.1 (S)
unnamed: Q506.3 (D), Q507.2 (G), R505.2
unnamed: Q509.3 (D), Q510.2 (G), R507.2
VCC: J301.1, J301.2, J302.1, J302.2, J303.1, J303.2, J304.1, J304.2, J401.1, J401.2, J402.1, J402.2, J403.1, J403.2, J404.1, J404.2, J501.1, J501.2, J502.1, J502.2, J503.1, J503.2, J504.1, J504.2, R301.1, R302.1, R303.1, R304.1, R305.1, R306.1, R307.1, R308.1, R401.1, R402.1, R403.1, R404.1, R405.1, R406.1, R407.1, R408.1, R501.1, R502.1, R503.1, R504.1, R505.1, R506.1, R507.1, R508.1; also elsewhere on the board
