davidv1992/Trans1/designs/memory/membase/membase.kicad_pcb

## KiCad design designs/memory/membase/membase.kicad_pcb (continued)

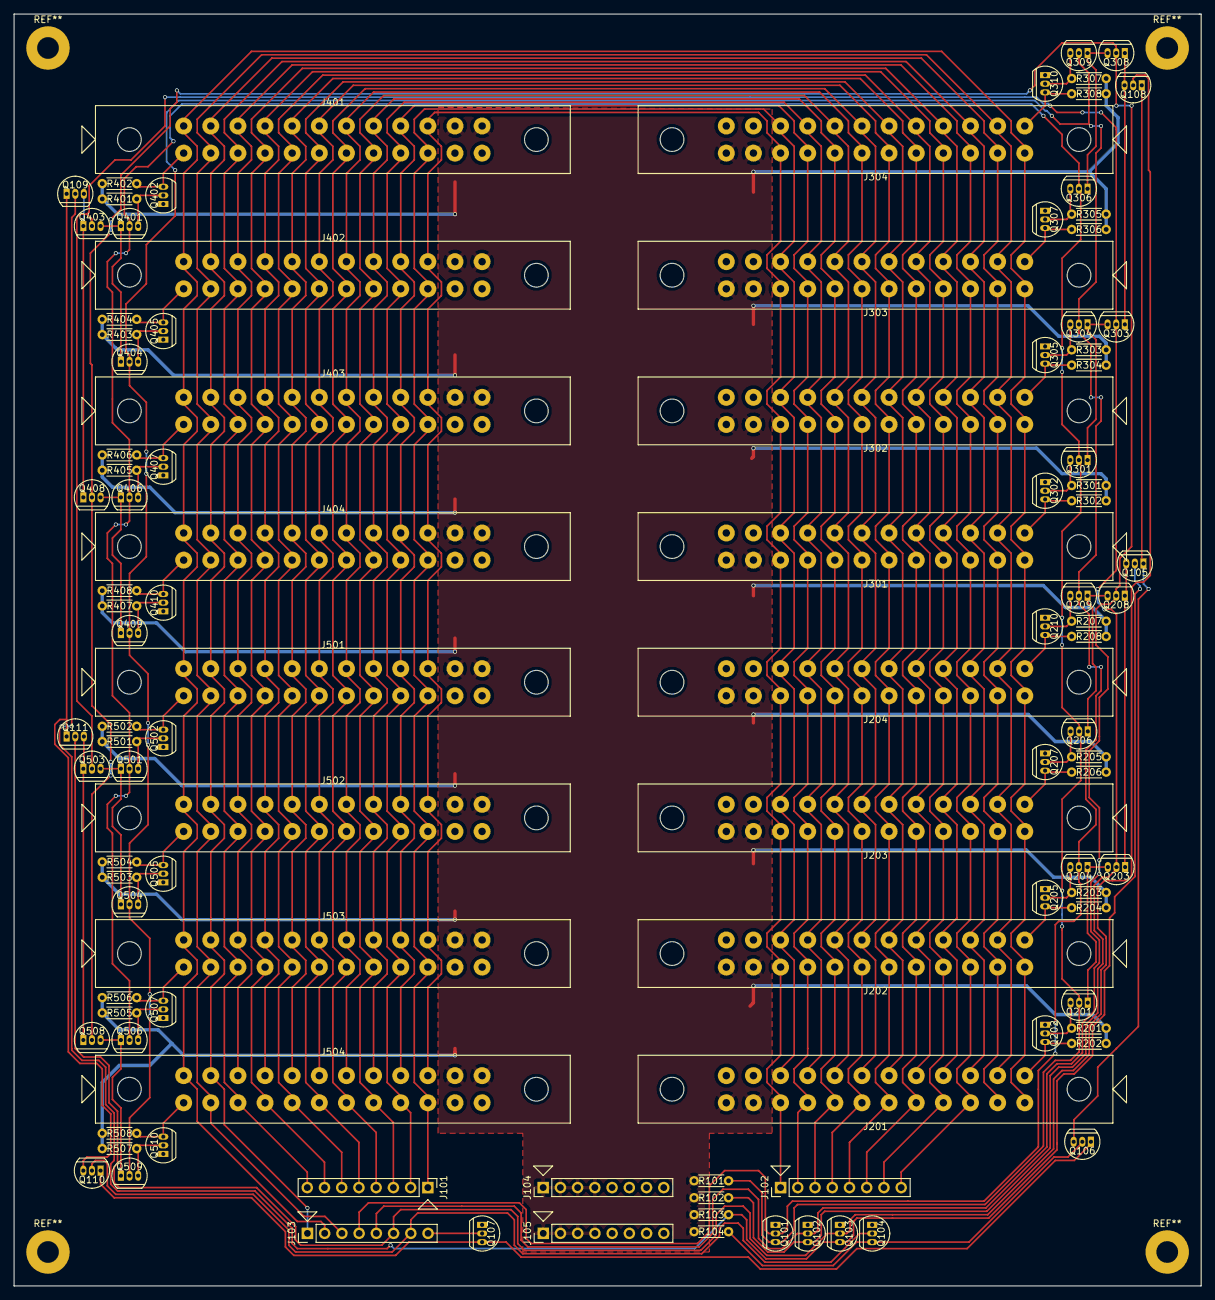
[picture p17: board membase.kicad_pcb from above]

Board: 2 copper layers, 175.0 x 187.5 mm, 108 parts (0 on the bottom side), 77 nets.
