davidv1992/Trans1/designs/control/core/core.kicad_pcb

## KiCad design designs/control/core/core.kicad_pcb (2025-08-03)

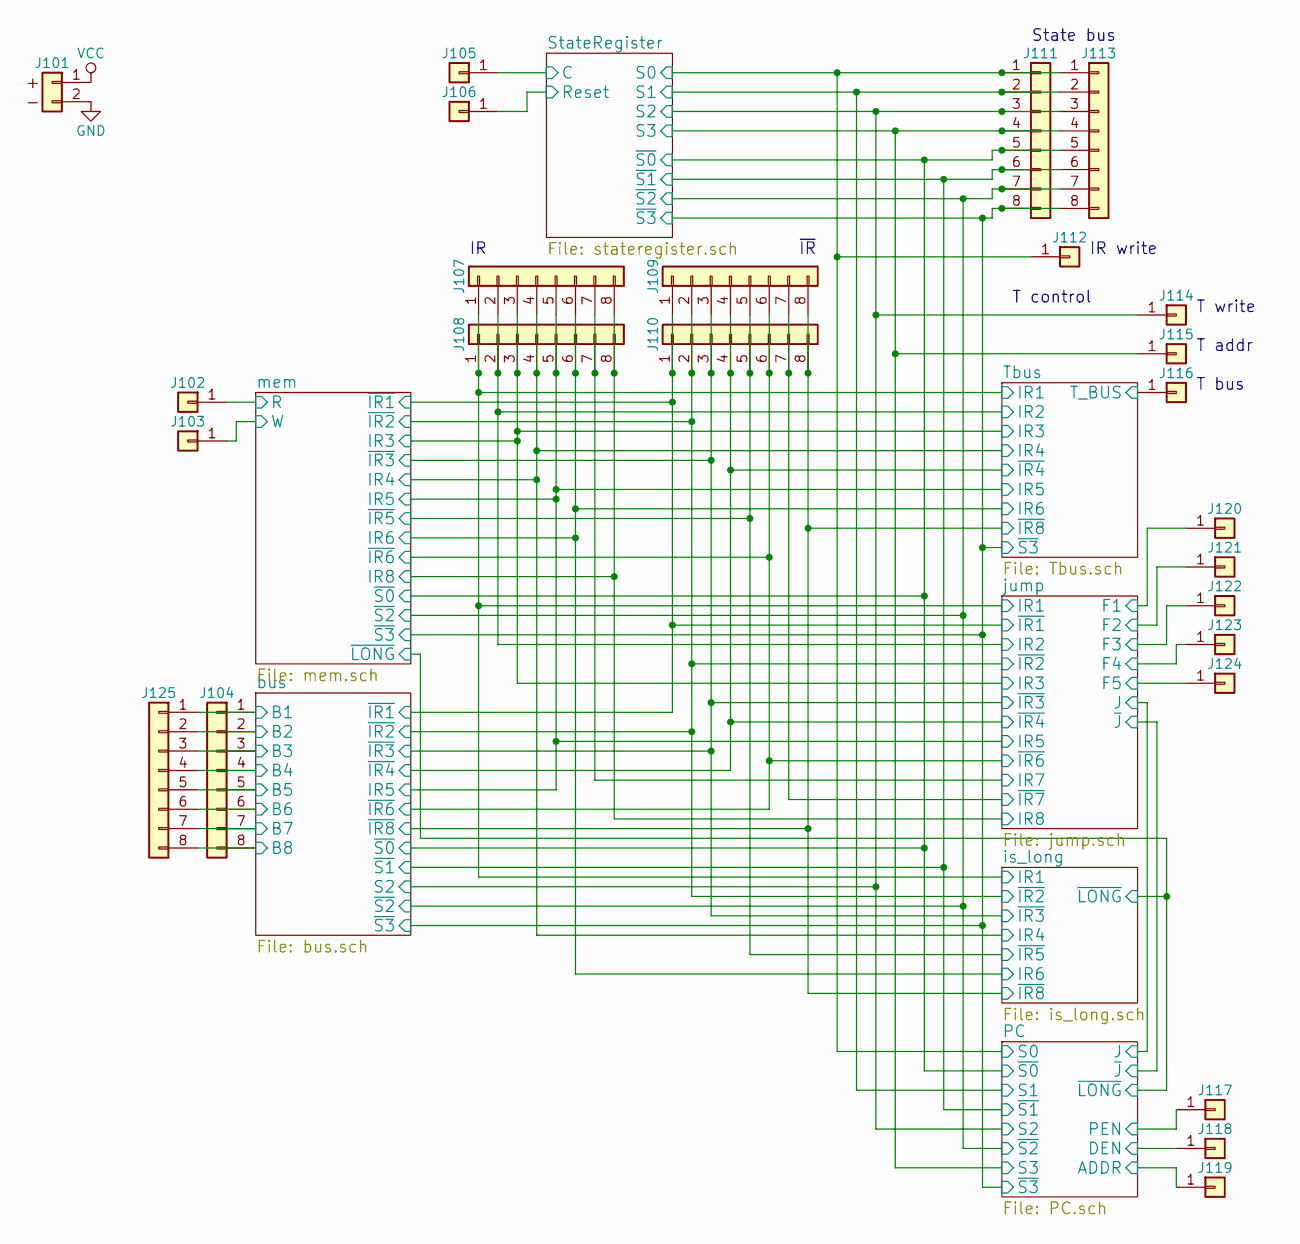
[picture p18: schematic core.sch]

Parts:
J101: Conn_01x02_Power; PH_1x2
J102, J103, J105, J106, J112, J114, J115, J116, J117, J118, J119, J120, J121, J122, J123, J124: Conn_01x01; PH_1x1
J104, J107, J108, J109, J110, J111, J113, J125: Conn_01x08; PH_1x8

Connections:
/PC/ADDR: J119.1; also elsewhere on the board
/PC/DEN: J118.1; also elsewhere on the board
/PC/PEN: J117.1; also elsewhere on the board
/PC/S0: J111.1, J112.1, J113.1; also elsewhere on the board
/PC/S1: J111.2, J113.2; also elsewhere on the board
/PC/S2: J111.3, J113.3, J114.1; also elsewhere on the board
/PC/S3: J111.4, J113.4, J115.1; also elsewhere on the board
/PC/~S0: J111.5, J113.5; also elsewhere on the board
/PC/~S1: J111.6, J113.6; also elsewhere on the board
/PC/~S2: J111.7, J113.7; also elsewhere on the board
/PC/~S3: J111.8, J113.8; also elsewhere on the board
/StateRegister/C: J105.1; also elsewhere on the board
/StateRegister/Reset: J106.1; also elsewhere on the board
/Tbus/IR1: J107.1, J108.1; also elsewhere on the board
/Tbus/IR2: J107.2, J108.2; also elsewhere on the board
/Tbus/IR3: J107.3, J108.3; also elsewhere on the board
/Tbus/IR4: J107.4, J108.4; also elsewhere on the board
/Tbus/IR5: J107.5, J108.5; also elsewhere on the board
/Tbus/IR6: J107.6, J108.6; also elsewhere on the board
/Tbus/T_BUS: J116.1; also elsewhere on the board
/Tbus/~IR4: J109.4, J110.4; also elsewhere on the board
/Tbus/~IR8: J109.8, J110.8; also elsewhere on the board
/bus/B1: J104.1, J125.1; also elsewhere on the board
/bus/B2: J104.2, J125.2; also elsewhere on the board
/bus/B3: J104.3, J125.3; also elsewhere on the board
/bus/B4: J104.4, J125.4; also elsewhere on the board
/bus/B5: J104.5, J125.5; also elsewhere on the board
/bus/B6: J104.6, J125.6; also elsewhere on the board
/bus/B7: J104.7, J125.7; also elsewhere on the board
/bus/B8: J104.8, J125.8; also elsewhere on the board
/bus/~IR1: J109.1, J110.1; also elsewhere on the board
/bus/~IR2: J109.2, J110.2; also elsewhere on the board
/bus/~IR3: J109.3, J110.3; also elsewhere on the board
/bus/~IR6: J109.6, J110.6; also elsewhere on the board
/is_long/~IR5: J109.5, J110.5; also elsewhere on the board
/jump/F1: J120.1; also elsewhere on the board
/jump/F2: J121.1; also elsewhere on the board
/jump/F3: J122.1; also elsewhere on the board
/jump/F4: J123.1; also elsewhere on the board
/jump/F5: J124.1; also elsewhere on the board
/jump/IR7: J107.7, J108.7; also elsewhere on the board
/jump/IR8: J107.8, J108.8; also elsewhere on the board
/jump/~IR7: J109.7, J110.7; also elsewhere on the board
/mem/R: J102.1; also elsewhere on the board
/mem/W: J103.1; also elsewhere on the board
GND: J101.2; also elsewhere on the board
VCC: J101.1; also elsewhere on the board

Notes on the sheet:
State bus
T control
T write
T addr
T bus
~IR
IR write

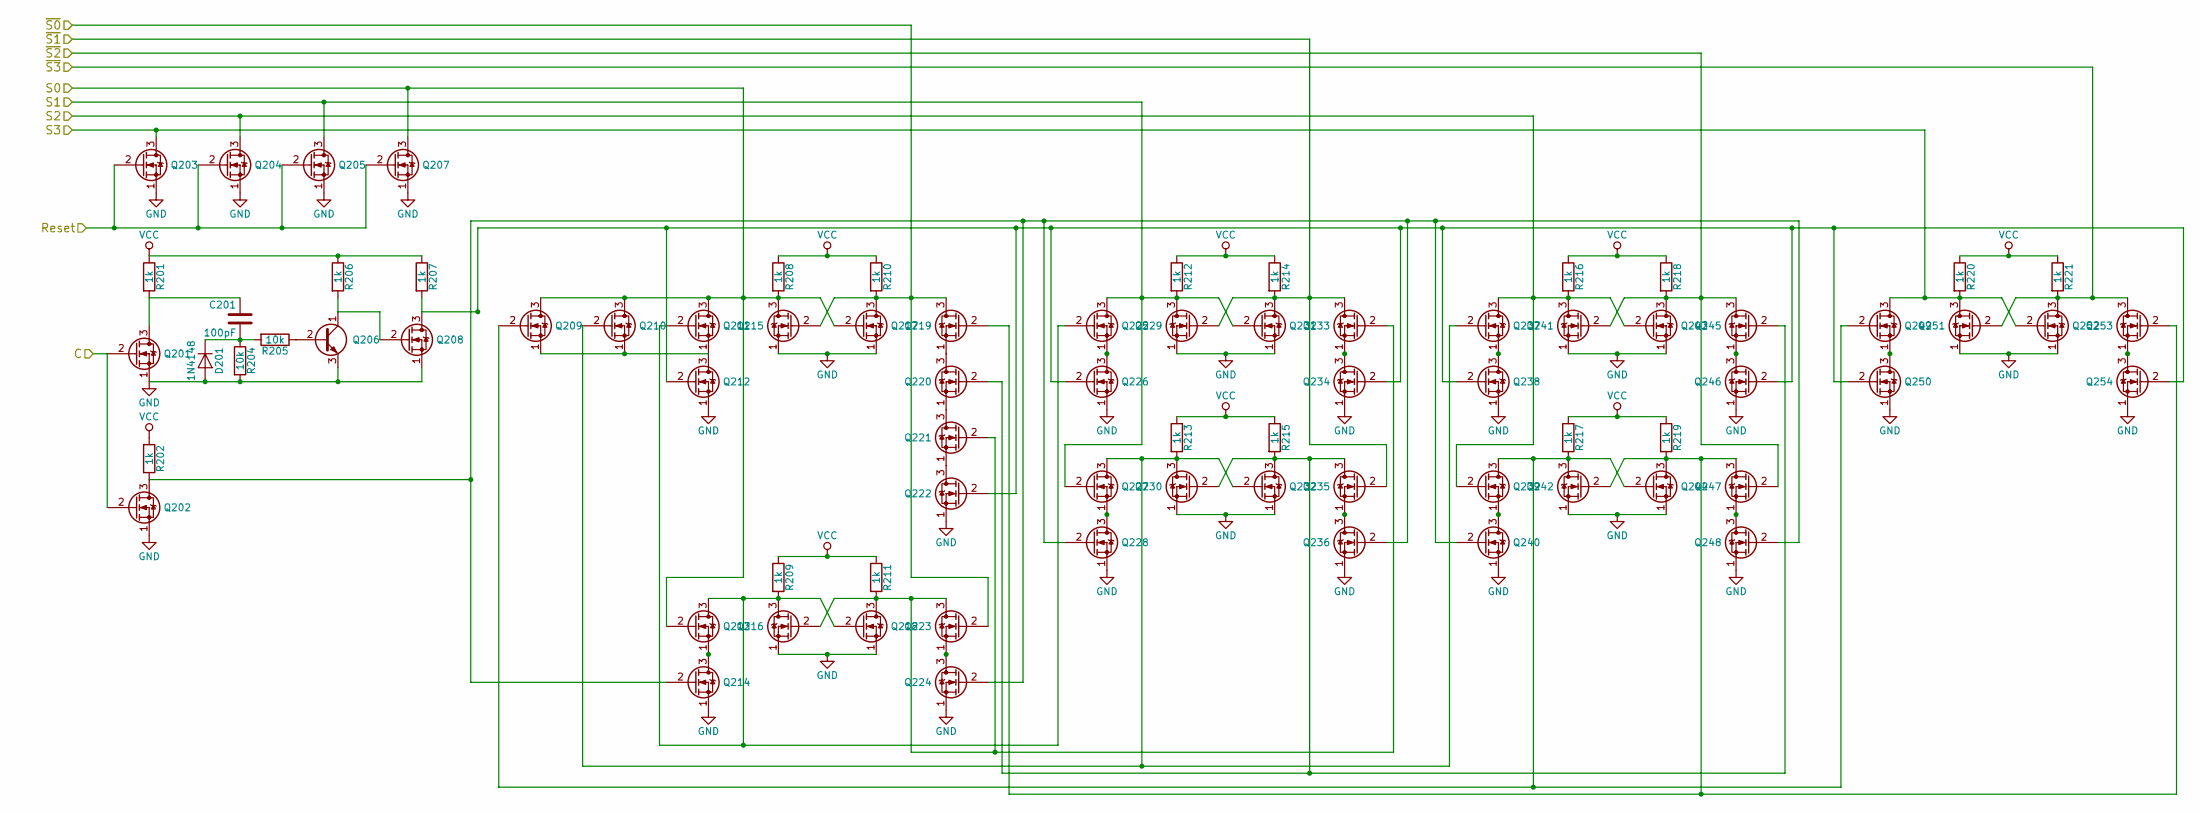
[picture p19: schematic stateregister.sch]

Parts:
C201: 100pF; C_default
D201: 1N4148; D_default
Q201, Q202, Q203, Q204, Q205, Q207, Q208, Q209, Q210, Q211, Q212, Q213, Q214, Q215, Q216, Q217, Q218, Q219, Q220, Q221, Q222, Q223, Q224, Q225, Q226, Q227, Q228, Q229, Q230, Q231, Q232, Q233, Q234, Q235, Q236, Q237, Q238, Q239, Q240, Q241, Q242, Q243, Q244, Q245, Q246, Q247, Q248, Q249, Q250, Q251, Q252, Q253, Q254: 2N7000; TO-92-FET
Q206: BC547; TO-92-BJT
R201, R202, R206, R207, R208, R209, R210, R211, R212, R213, R214, R215, R216, R217, R218, R219, R220, R221: 1k; R_small
R204, R205: 10k; R_small

Connections:
/PC/S0: Q207.3 (D), Q209.3 (D), Q210.3 (D), Q211.3 (D), Q213.2 (G), Q215.3 (D), Q217.2 (G), R208.2; also elsewhere on the board
/PC/S1: Q205.3 (D), Q225.3 (D), Q227.2 (G), Q229.3 (D), Q231.2 (G), R212.2; also elsewhere on the board
/PC/S2: Q204.3 (D), Q237.3 (D), Q239.2 (G), Q241.3 (D), Q243.2 (G), R216.2; also elsewhere on the board
/PC/S3: Q203.3 (D), Q249.3 (D), Q251.3 (D), Q252.2 (G), R220.2; also elsewhere on the board
/PC/~S0: Q215.2 (G), Q217.3 (D), Q219.3 (D), Q223.2 (G), R210.2; also elsewhere on the board
/PC/~S1: Q229.2 (G), Q231.3 (D), Q233.3 (D), Q235.2 (G), R214.2; also elsewhere on the board
/PC/~S2: Q241.2 (G), Q243.3 (D), Q245.3 (D), Q247.2 (G), R218.2; also elsewhere on the board
/PC/~S3: Q251.2 (G), Q252.3 (D), Q253.3 (D), R221.2; also elsewhere on the board
/StateRegister/C: Q201.2 (G), Q202.2 (G); also elsewhere on the board
/StateRegister/Reset: Q203.2 (G), Q204.2 (G), Q205.2 (G), Q207.2 (G); also elsewhere on the board
GND: D201.2 (A), Q201.1 (S), Q202.1 (S), Q203.1 (S), Q204.1 (S), Q205.1 (S), Q206.3 (E), Q207.1 (S), Q208.1 (S), Q212.1 (S), Q214.1 (S), Q215.1 (S), Q216.1 (S), Q217.1 (S), Q218.1 (S), Q222.1 (S), Q224.1 (S), Q226.1 (S), Q228.1 (S), Q229.1 (S), Q230.1 (S), Q231.1 (S), Q232.1 (S), Q234.1 (S), Q236.1 (S), Q238.1 (S), Q240.1 (S), Q241.1 (S), Q242.1 (S), Q243.1 (S), Q244.1 (S), Q246.1 (S), Q248.1 (S), Q250.1 (S), Q251.1 (S), Q252.1 (S), Q254.1 (S), R204.2; also elsewhere on the board
unnamed: C201.1, Q201.3 (D), R201.2
unnamed: C201.2, D201.1 (K), R204.1, R205.2
unnamed: Q202.3 (D), Q214.2 (G), Q224.2 (G), Q228.2 (G), Q236.2 (G), Q240.2 (G), Q248.2 (G), R202.2
unnamed: Q206.1 (C), Q208.2 (G), R206.2
unnamed: Q206.2 (B), R205.1
unnamed: Q208.3 (D), Q212.2 (G), Q222.2 (G), Q226.2 (G), Q234.2 (G), Q238.2 (G), Q246.2 (G), Q250.2 (G), Q254.2 (G), R207.2
unnamed: Q209.1 (S), Q210.1 (S), Q211.1 (S), Q212.3 (D)
unnamed: Q209.2 (G), Q239.3 (D), Q242.3 (D), Q244.2 (G), Q249.2 (G), R217.2
unnamed: Q210.2 (G), Q227.3 (D), Q230.3 (D), Q232.2 (G), Q237.2 (G), R213.2
unnamed: Q211.2 (G), Q213.3 (D), Q216.3 (D), Q218.2 (G), Q225.2 (G), R209.2
unnamed: Q213.1 (S), Q214.3 (D)
unnamed: Q216.2 (G), Q218.3 (D), Q221.2 (G), Q223.3 (D), Q233.2 (G), R211.2
unnamed: Q219.1 (S), Q220.3 (D)
unnamed: Q219.2 (G), Q242.2 (G), Q244.3 (D), Q247.3 (D), Q253.2 (G), R219.2
unnamed: Q220.1 (S), Q221.3 (D)
unnamed: Q220.2 (G), Q230.2 (G), Q232.3 (D), Q235.3 (D), Q245.2 (G), R215.2
unnamed: Q221.1 (S), Q222.3 (D)
unnamed: Q223.1 (S), Q224.3 (D)
unnamed: Q225.1 (S), Q226.3 (D)
unnamed: Q227.1 (S), Q228.3 (D)
unnamed: Q233.1 (S), Q234.3 (D)
unnamed: Q235.1 (S), Q236.3 (D)
unnamed: Q237.1 (S), Q238.3 (D)
unnamed: Q239.1 (S), Q240.3 (D)
unnamed: Q245.1 (S), Q246.3 (D)
unnamed: Q247.1 (S), Q248.3 (D)
unnamed: Q249.1 (S), Q250.3 (D)
unnamed: Q253.1 (S), Q254.3 (D)
VCC: R201.1, R202.1, R206.1, R207.1, R208.1, R209.1, R210.1, R211.1, R212.1, R213.1, R214.1, R215.1, R216.1, R217.1, R218.1, R219.1, R220.1, R221.1; also elsewhere on the board

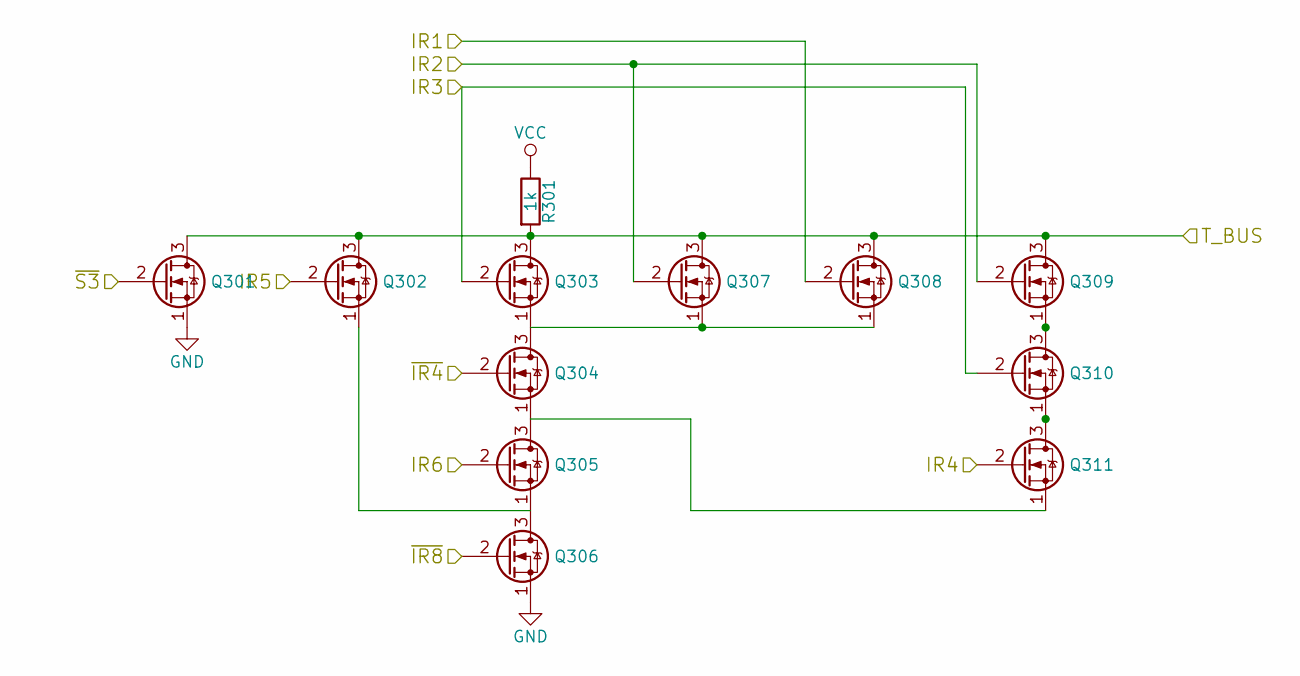
[picture p20: schematic Tbus.sch]

Parts:
Q301, Q302, Q303, Q304, Q305, Q306, Q307, Q308, Q309, Q310, Q311: 2N7000; TO-92-FET
R301: 1k; R_small

Connections:
/PC/~S3: Q301.2 (G); also elsewhere on the board
/Tbus/IR1: Q308.2 (G); also elsewhere on the board
/Tbus/IR2: Q307.2 (G), Q309.2 (G); also elsewhere on the board
/Tbus/IR3: Q303.2 (G), Q310.2 (G); also elsewhere on the board
/Tbus/IR4: Q311.2 (G); also elsewhere on the board
/Tbus/IR5: Q302.2 (G); also elsewhere on the board
/Tbus/IR6: Q305.2 (G); also elsewhere on the board
/Tbus/T_BUS: Q301.3 (D), Q302.3 (D), Q303.3 (D), Q307.3 (D), Q308.3 (D), Q309.3 (D), R301.2; also elsewhere on the board
/Tbus/~IR4: Q304.2 (G); also elsewhere on the board
/Tbus/~IR8: Q306.2 (G); also elsewhere on the board
GND: Q301.1 (S), Q306.1 (S); also elsewhere on the board
unnamed: Q302.1 (S), Q305.1 (S), Q306.3 (D)
unnamed: Q303.1 (S), Q304.3 (D), Q307.1 (S), Q308.1 (S)
unnamed: Q304.1 (S), Q305.3 (D), Q311.1 (S)
unnamed: Q309.1 (S), Q310.3 (D)
unnamed: Q310.1 (S), Q311.3 (D)
VCC: R301.1; also elsewhere on the board

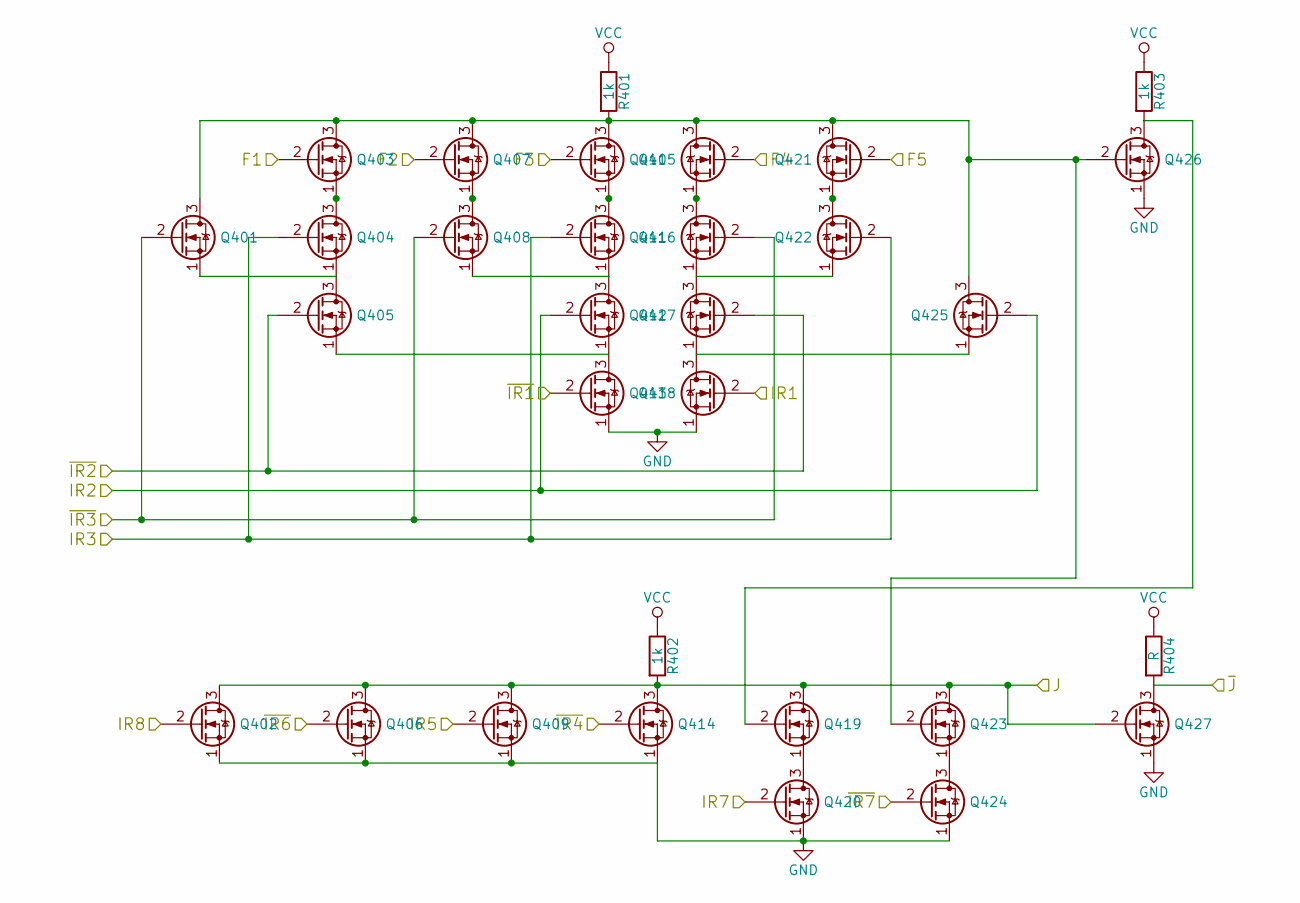
[picture p21: schematic jump.sch]

Parts:
Q401, Q402, Q403, Q404, Q405, Q406, Q407, Q408, Q409, Q410, Q411, Q412, Q413, Q414, Q415, Q416, Q417, Q418, Q419, Q420, Q421, Q422, Q423, Q424, Q425, Q426, Q427: 2N7000; TO-92-FET
R401, R402, R403: 1k; R_small
R404: R; R_small

Connections:
/PC/J: Q402.3 (D), Q406.3 (D), Q409.3 (D), Q414.3 (D), Q419.3 (D), Q423.3 (D), Q427.2 (G), R402.2; also elsewhere on the board
/PC/~J: Q427.3 (D), R404.2; also elsewhere on the board
/Tbus/IR1: Q418.2 (G); also elsewhere on the board
/Tbus/IR2: Q412.2 (G), Q425.2 (G); also elsewhere on the board
/Tbus/IR3: Q404.2 (G), Q411.2 (G), Q422.2 (G); also elsewhere on the board
/Tbus/IR5: Q409.2 (G); also elsewhere on the board
/Tbus/~IR4: Q414.2 (G); also elsewhere on the board
/bus/~IR1: Q413.2 (G); also elsewhere on the board
/bus/~IR2: Q405.2 (G), Q417.2 (G); also elsewhere on the board
/bus/~IR3: Q401.2 (G), Q408.2 (G), Q416.2 (G); also elsewhere on the board
/bus/~IR6: Q406.2 (G); also elsewhere on the board
/jump/F1: Q403.2 (G); also elsewhere on the board
/jump/F2: Q407.2 (G); also elsewhere on the board
/jump/F3: Q410.2 (G); also elsewhere on the board
/jump/F4: Q415.2 (G); also elsewhere on the board
/jump/F5: Q421.2 (G); also elsewhere on the board
/jump/IR7: Q420.2 (G); also elsewhere on the board
/jump/IR8: Q402.2 (G); also elsewhere on the board
/jump/~IR7: Q424.2 (G); also elsewhere on the board
GND: Q402.1 (S), Q406.1 (S), Q409.1 (S), Q413.1 (S), Q414.1 (S), Q418.1 (S), Q420.1 (S), Q424.1 (S), Q426.1 (S), Q427.1 (S); also elsewhere on the board
unnamed: Q401.1 (S), Q404.1 (S), Q405.3 (D)
unnamed: Q401.3 (D), Q403.3 (D), Q407.3 (D), Q410.3 (D), Q415.3 (D), Q421.3 (D), Q423.2 (G), Q425.3 (D), Q426.2 (G), R401.2
unnamed: Q403.1 (S), Q404.3 (D)
unnamed: Q405.1 (S), Q412.1 (S), Q413.3 (D)
unnamed: Q407.1 (S), Q408.3 (D)
unnamed: Q408.1 (S), Q411.1 (S), Q412.3 (D)
unnamed: Q410.1 (S), Q411.3 (D)
unnamed: Q415.1 (S), Q416.3 (D)
unnamed: Q416.1 (S), Q417.3 (D), Q422.1 (S)
unnamed: Q417.1 (S), Q418.3 (D), Q425.1 (S)
unnamed: Q419.1 (S), Q420.3 (D)
unnamed: Q419.2 (G), Q426.3 (D), R403.2
unnamed: Q421.1 (S), Q422.3 (D)
unnamed: Q423.1 (S), Q424.3 (D)
VCC: R401.1, R402.1, R403.1, R404.1; also elsewhere on the board

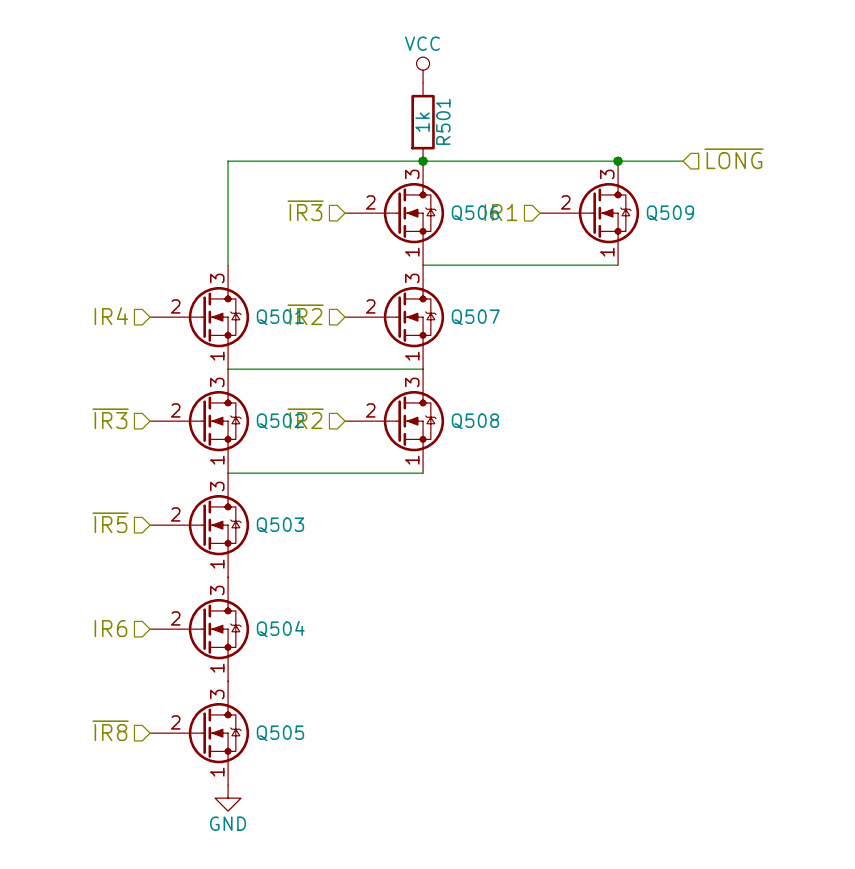
[picture p22: schematic is_long.sch]

Parts:
Q501, Q502, Q503, Q504, Q505, Q506, Q507, Q508, Q509: 2N7000; TO-92-FET
R501: 1k; R_small

Connections:
/PC/~LONG: Q501.3 (D), Q506.3 (D), Q509.3 (D), R501.2; also elsewhere on the board
/Tbus/IR1: Q509.2 (G); also elsewhere on the board
/Tbus/IR4: Q501.2 (G); also elsewhere on the board
/Tbus/IR6: Q504.2 (G); also elsewhere on the board
/Tbus/~IR8: Q505.2 (G); also elsewhere on the board
/bus/~IR2: Q507.2 (G), Q508.2 (G); also elsewhere on the board
/bus/~IR3: Q502.2 (G), Q506.2 (G); also elsewhere on the board
/is_long/~IR5: Q503.2 (G); also elsewhere on the board
GND: Q505.1 (S); also elsewhere on the board
unnamed: Q501.1 (S), Q502.3 (D), Q507.1 (S), Q508.3 (D)
unnamed: Q502.1 (S), Q503.3 (D), Q508.1 (S)
unnamed: Q503.1 (S), Q504.3 (D)
unnamed: Q504.1 (S), Q505.3 (D)
unnamed: Q506.1 (S), Q507.3 (D), Q509.1 (S)
VCC: R501.1; also elsewhere on the board

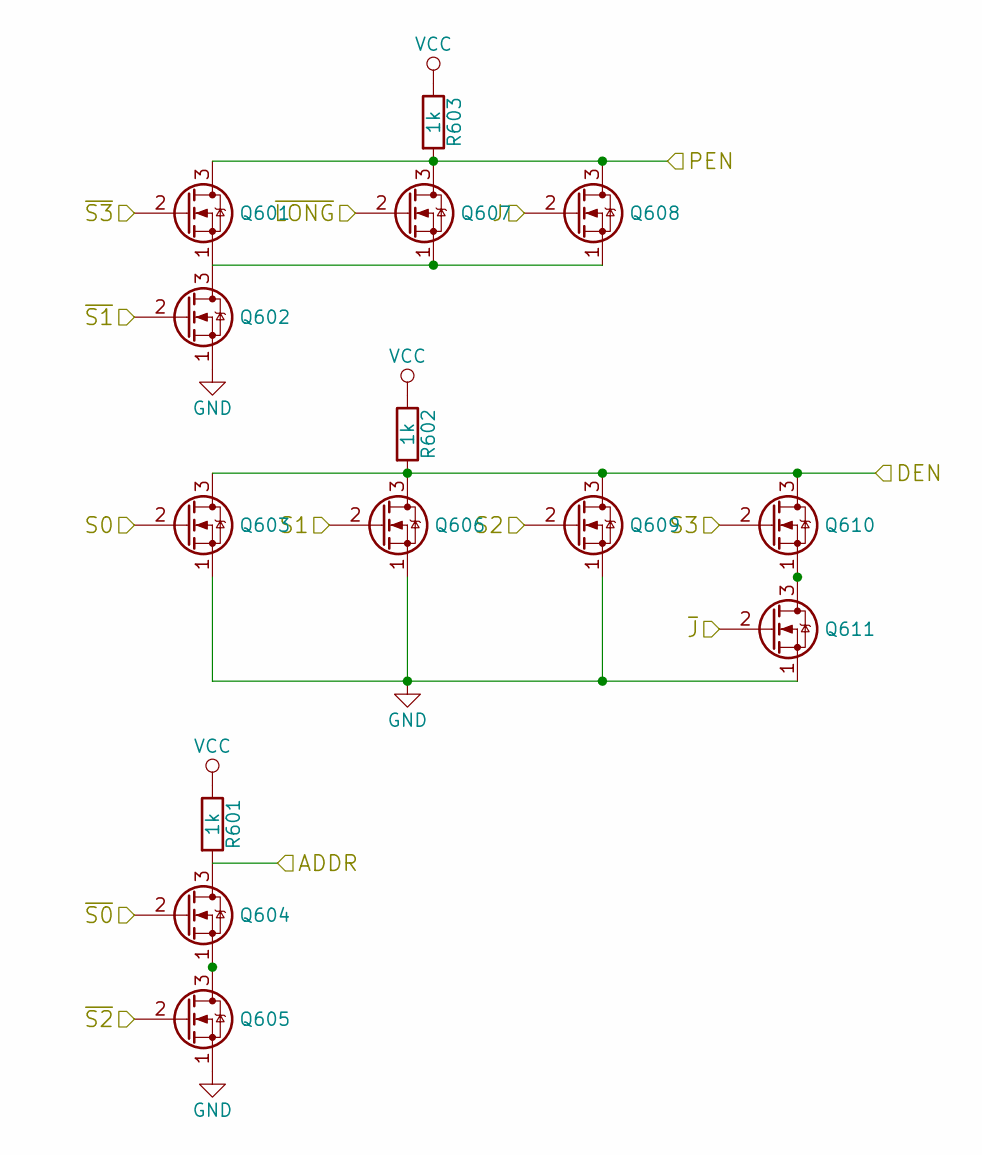
[picture p23: schematic PC.sch]

Parts:
Q601, Q602, Q603, Q604, Q605, Q606, Q607, Q608, Q609, Q610, Q611: 2N7000; TO-92-FET
R601, R602, R603: 1k; R_small

Connections:
/PC/ADDR: Q604.3 (D), R601.2; also elsewhere on the board
/PC/DEN: Q603.3 (D), Q606.3 (D), Q609.3 (D), Q610.3 (D), R602.2; also elsewhere on the board
/PC/J: Q608.2 (G); also elsewhere on the board
/PC/PEN: Q601.3 (D), Q607.3 (D), Q608.3 (D), R603.2; also elsewhere on the board
/PC/S0: Q603.2 (G); also elsewhere on the board
/PC/S1: Q606.2 (G); also elsewhere on the board
/PC/S2: Q609.2 (G); also elsewhere on the board
/PC/S3: Q610.2 (G); also elsewhere on the board
/PC/~J: Q611.2 (G); also elsewhere on the board
/PC/~LONG: Q607.2 (G); also elsewhere on the board
/PC/~S0: Q604.2 (G); also elsewhere on the board
/PC/~S1: Q602.2 (G); also elsewhere on the board
/PC/~S2: Q605.2 (G); also elsewhere on the board
/PC/~S3: Q601.2 (G); also elsewhere on the board
GND: Q602.1 (S), Q603.1 (S), Q605.1 (S), Q606.1 (S), Q609.1 (S), Q611.1 (S); also elsewhere on the board
unnamed: Q601.1 (S), Q602.3 (D), Q607.1 (S), Q608.1 (S)
unnamed: Q604.1 (S), Q605.3 (D)
unnamed: Q610.1 (S), Q611.3 (D)
VCC: R601.1, R602.1, R603.1; also elsewhere on the board

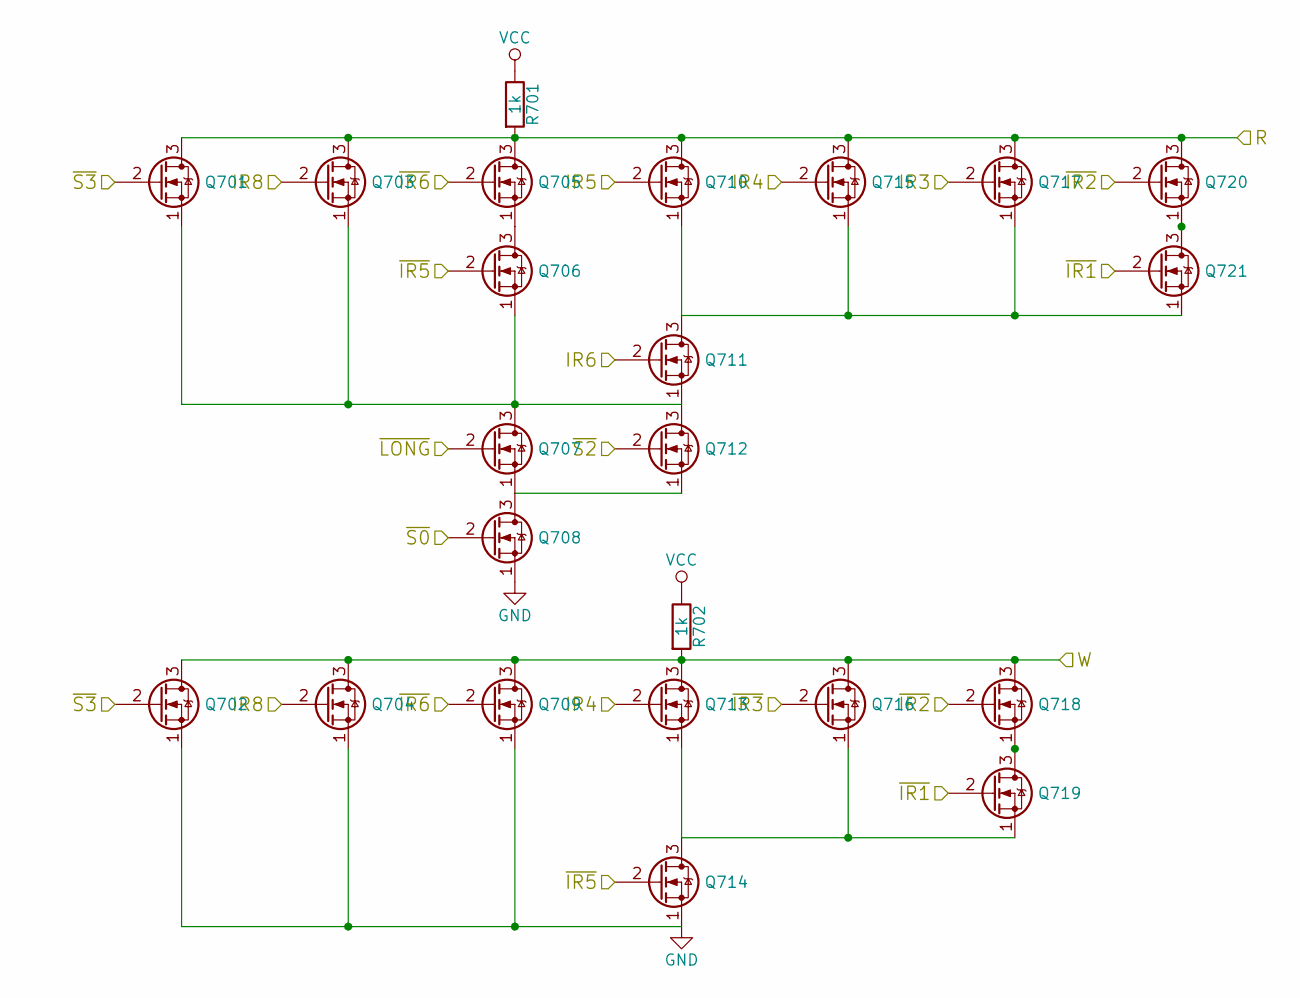
[picture p24: schematic mem.sch]

Parts:
Q701, Q702, Q703, Q704, Q705, Q706, Q707, Q708, Q709, Q710, Q711, Q712, Q713, Q714, Q715, Q716, Q717, Q718, Q719, Q720, Q721: 2N7000; TO-92-FET
R701, R702: 1k; R_small

Connections:
/PC/~LONG: Q707.2 (G); also elsewhere on the board
/PC/~S0: Q708.2 (G); also elsewhere on the board
/PC/~S2: Q712.2 (G); also elsewhere on the board
/PC/~S3: Q701.2 (G), Q702.2 (G); also elsewhere on the board
/Tbus/IR3: Q717.2 (G); also elsewhere on the board
/Tbus/IR4: Q713.2 (G), Q715.2 (G); also elsewhere on the board
/Tbus/IR5: Q710.2 (G); also elsewhere on the board
/Tbus/IR6: Q711.2 (G); also elsewhere on the board
/bus/~IR1: Q719.2 (G), Q721.2 (G); also elsewhere on the board
/bus/~IR2: Q718.2 (G), Q720.2 (G); also elsewhere on the board
/bus/~IR3: Q716.2 (G); also elsewhere on the board
/bus/~IR6: Q705.2 (G), Q709.2 (G); also elsewhere on the board
/is_long/~IR5: Q706.2 (G), Q714.2 (G); also elsewhere on the board
/jump/IR8: Q703.2 (G), Q704.2 (G); also elsewhere on the board
/mem/R: Q701.3 (D), Q703.3 (D), Q705.3 (D), Q710.3 (D), Q715.3 (D), Q717.3 (D), Q720.3 (D), R701.2; also elsewhere on the board
/mem/W: Q702.3 (D), Q704.3 (D), Q709.3 (D), Q713.3 (D), Q716.3 (D), Q718.3 (D), R702.2; also elsewhere on the board
GND: Q702.1 (S), Q704.1 (S), Q708.1 (S), Q709.1 (S), Q714.1 (S); also elsewhere on the board
unnamed: Q701.1 (S), Q703.1 (S), Q706.1 (S), Q707.3 (D), Q711.1 (S), Q712.3 (D)
unnamed: Q705.1 (S), Q706.3 (D)
unnamed: Q707.1 (S), Q708.3 (D), Q712.1 (S)
unnamed: Q710.1 (S), Q711.3 (D), Q715.1 (S), Q717.1 (S), Q721.1 (S)
unnamed: Q713.1 (S), Q714.3 (D), Q716.1 (S), Q719.1 (S)
unnamed: Q718.1 (S), Q719.3 (D)
unnamed: Q720.1 (S), Q721.3 (D)
VCC: R701.1, R702.1; also elsewhere on the board

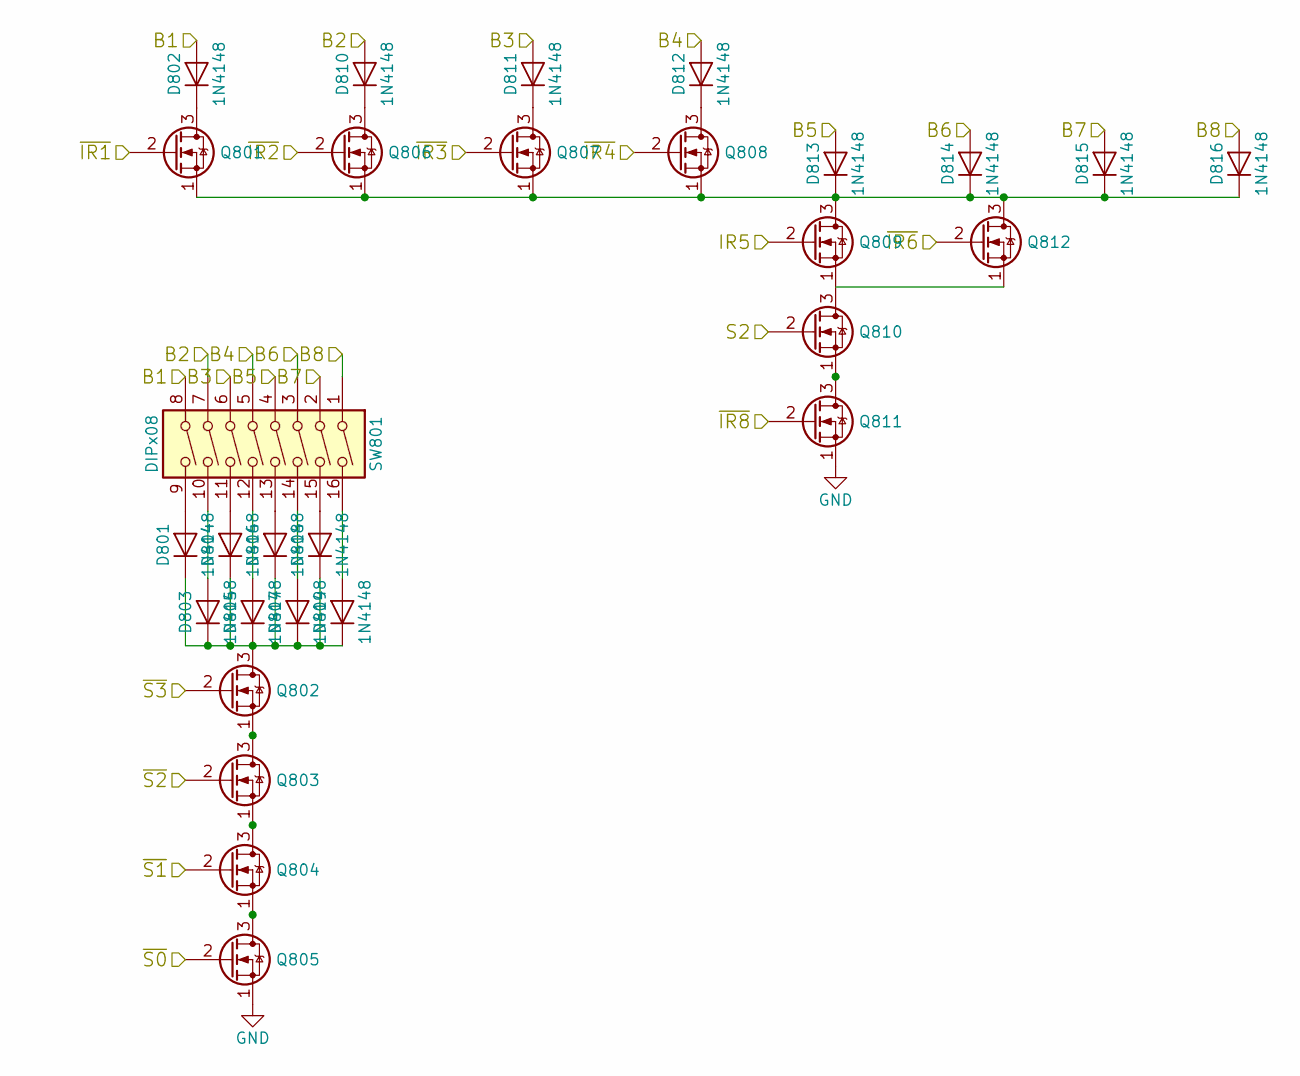
[picture p25: schematic bus.sch]

Parts:
D801, D802, D803, D804, D805, D806, D807, D808, D809, D810, D811, D812, D813, D814, D815, D816: 1N4148; D_default
Q801, Q802, Q803, Q804, Q805, Q806, Q807, Q808, Q809, Q810, Q811, Q812: 2N7000; TO-92-FET
SW801: DIPx08; DIPx8

Connections:
/PC/S2: Q810.2 (G); also elsewhere on the board
/PC/~S0: Q805.2 (G); also elsewhere on the board
/PC/~S1: Q804.2 (G); also elsewhere on the board
/PC/~S2: Q803.2 (G); also elsewhere on the board
/PC/~S3: Q802.2 (G); also elsewhere on the board
/Tbus/IR5: Q809.2 (G); also elsewhere on the board
/Tbus/~IR4: Q808.2 (G); also elsewhere on the board
/Tbus/~IR8: Q811.2 (G); also elsewhere on the board
/bus/B1: D802.2 (A), SW801.8; also elsewhere on the board
/bus/B2: D810.2 (A), SW801.7; also elsewhere on the board
/bus/B3: D811.2 (A), SW801.6; also elsewhere on the board
/bus/B4: D812.2 (A), SW801.5; also elsewhere on the board
/bus/B5: D813.2 (A), SW801.4; also elsewhere on the board
/bus/B6: D814.2 (A), SW801.3; also elsewhere on the board
/bus/B7: D815.2 (A), SW801.2; also elsewhere on the board
/bus/B8: D816.2 (A), SW801.1; also elsewhere on the board
/bus/~IR1: Q801.2 (G); also elsewhere on the board
/bus/~IR2: Q806.2 (G); also elsewhere on the board
/bus/~IR3: Q807.2 (G); also elsewhere on the board
/bus/~IR6: Q812.2 (G); also elsewhere on the board
GND: Q805.1 (S), Q811.1 (S); also elsewhere on the board
unnamed: D801.1 (K), D803.1 (K), D804.1 (K), D805.1 (K), D806.1 (K), D807.1 (K), D808.1 (K), D809.1 (K), Q802.3 (D)
unnamed: D801.2 (A), SW801.9
unnamed: D802.1 (K), Q801.3 (D)
unnamed: D803.2 (A), SW801.10
unnamed: D804.2 (A), SW801.11
unnamed: D805.2 (A), SW801.12
unnamed: D806.2 (A), SW801.13
unnamed: D807.2 (A), SW801.14
unnamed: D808.2 (A), SW801.15
unnamed: D809.2 (A), SW801.16
unnamed: D810.1 (K), Q806.3 (D)
unnamed: D811.1 (K), Q807.3 (D)
unnamed: D812.1 (K), Q808.3 (D)
unnamed: D813.1 (K), D814.1 (K), D815.1 (K), D816.1 (K), Q801.1 (S), Q806.1 (S), Q807.1 (S), Q808.1 (S), Q809.3 (D), Q812.3 (D)
unnamed: Q802.1 (S), Q803.3 (D)
unnamed: Q803.1 (S), Q804.3 (D)
unnamed: Q804.1 (S), Q805.3 (D)
unnamed: Q809.1 (S), Q810.3 (D), Q812.1 (S)
unnamed: Q810.1 (S), Q811.3 (D)
