davidv1992/Trans1/designs/control/core/core.kicad_pcb

## KiCad design designs/control/core/core.kicad_pcb (continued)

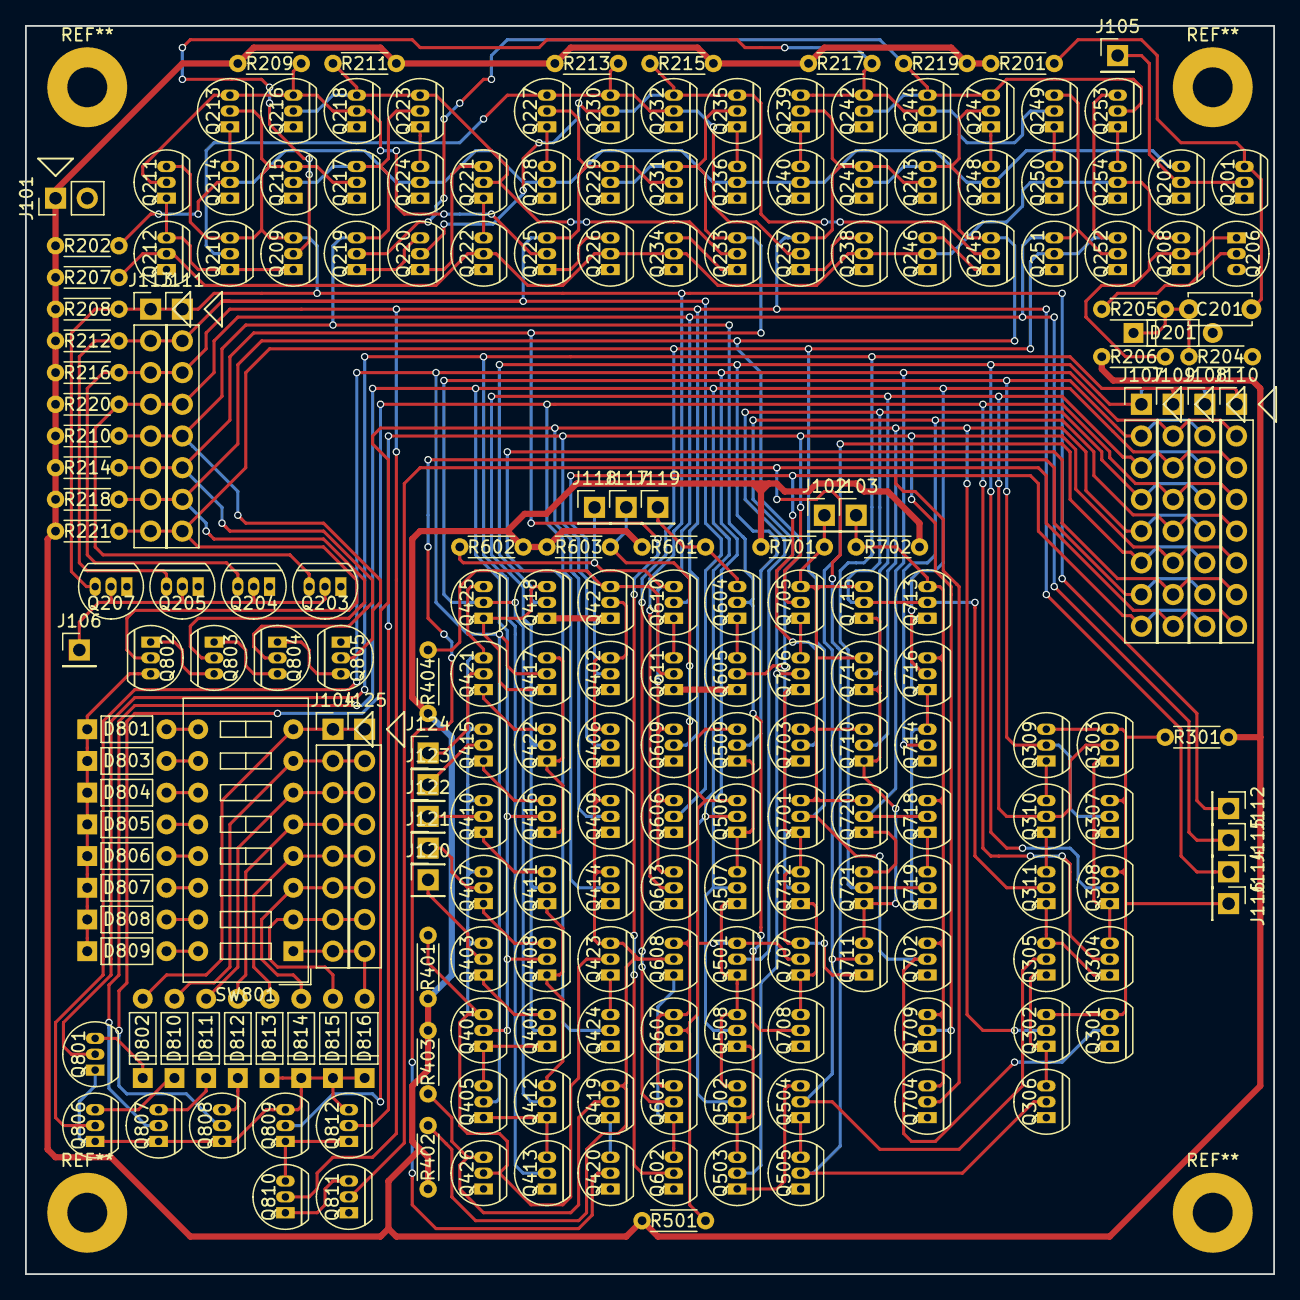
[picture p26: board designs/control/core/core.kicad_pcb from above]

Board: 2 copper layers, 100.0 x 100.0 mm, 220 parts (0 on the bottom side), 131 nets.
