davidv1992/Trans1/designs/adder/control/control.kicad_pcb

## KiCad design designs/adder/control/control.kicad_pcb (2025-08-03)

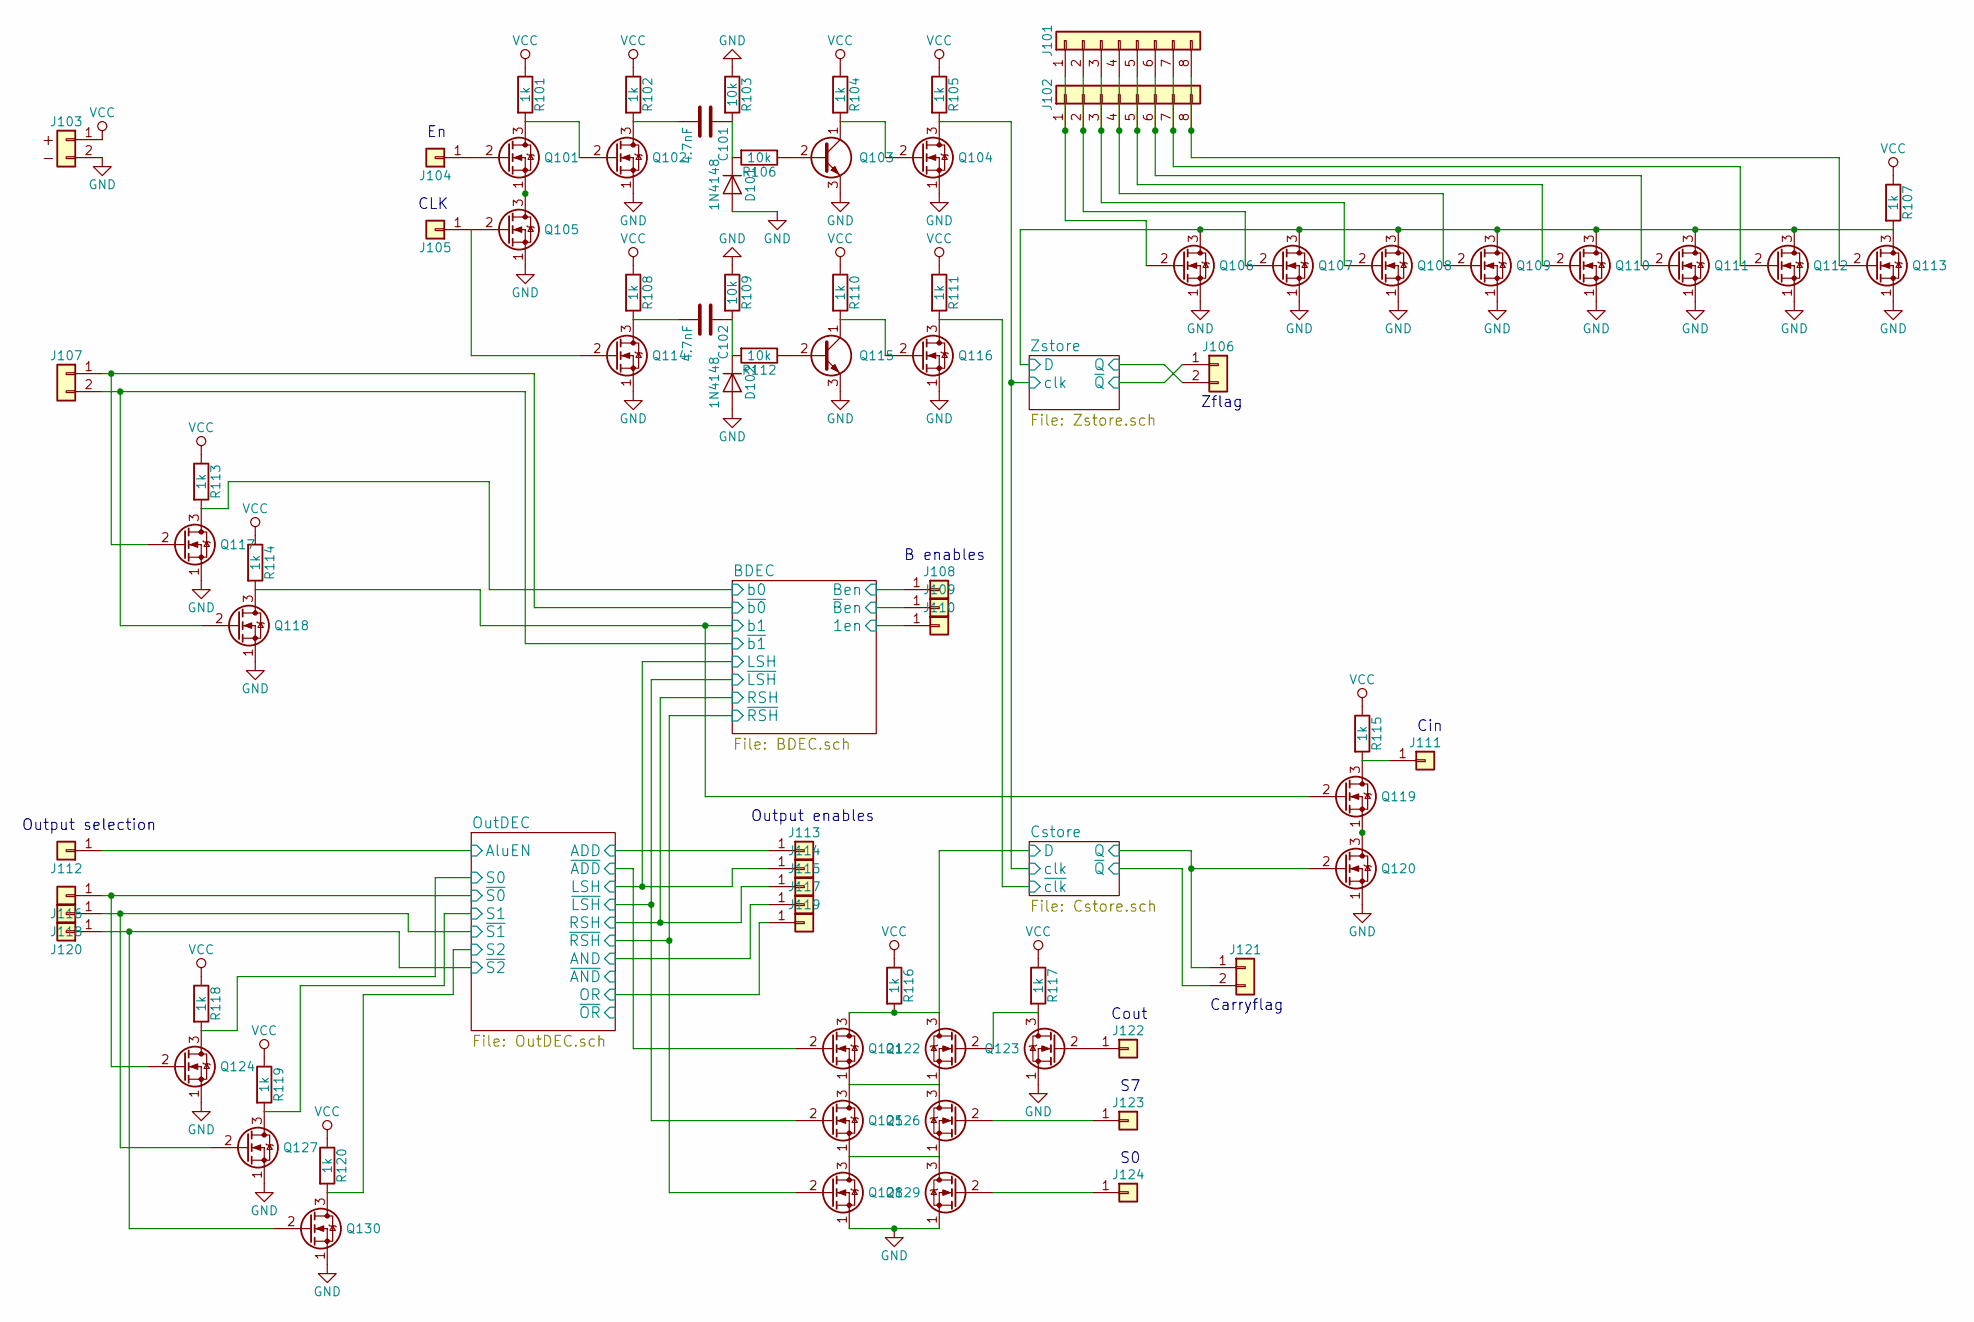
[picture p27: schematic control.sch]

Parts:
C101, C102: 4.7nF; C_default
D101, D102: 1N4148; D_default
J101, J102: Conn_01x08; PH_1x8
J103: Conn_01x02_Power; PH_1x2
J104, J105, J108, J109, J110, J111, J112, J113, J114, J115, J116, J117, J118, J119, J120, J122, J123, J124: Conn_01x01; PH_1x1
J106, J107, J121: Conn_01x02; PH_1x2
Q101, Q102, Q104, Q105, Q106, Q107, Q108, Q109, Q110, Q111, Q112, Q113, Q114, Q116, Q117, Q118, Q119, Q120, Q121, Q122, Q123, Q124, Q125, Q126, Q127, Q128, Q129, Q130: 2N7000; TO-92-FET
Q103, Q115: BC547; TO-92-BJT
R101, R102, R104, R105, R107, R108, R110, R111, R113, R114, R115, R116, R117, R118, R119, R120: 1k; R_small
R103, R106, R109, R112: 10k; R_small

Connections:
/BDEC/1en: J110.1; also elsewhere on the board
/BDEC/Ben: J108.1; also elsewhere on the board
/BDEC/LSH: J114.1; also elsewhere on the board
/BDEC/RSH: J115.1; also elsewhere on the board
/BDEC/b0: Q117.3 (D), R113.2; also elsewhere on the board
/BDEC/b1: Q118.3 (D), Q119.2 (G), R114.2; also elsewhere on the board
/BDEC/~B~en: J109.1; also elsewhere on the board
/BDEC/~LSH: Q125.2 (G); also elsewhere on the board
/BDEC/~RSH: Q128.2 (G); also elsewhere on the board
/BDEC/~b0: J107.1, Q117.2 (G); also elsewhere on the board
/BDEC/~b1: J107.2, Q118.2 (G); also elsewhere on the board
/Cstore/D: Q121.3 (D), Q122.3 (D), R116.2; also elsewhere on the board
/Cstore/Q: J121.1, Q120.2 (G); also elsewhere on the board
/Cstore/clk: Q104.3 (D), R105.2; also elsewhere on the board
/Cstore/~Q: J121.2; also elsewhere on the board
/Cstore/~clk: Q116.3 (D), R111.2; also elsewhere on the board
/OutDEC/ADD: J113.1; also elsewhere on the board
/OutDEC/AND: J117.1; also elsewhere on the board
/OutDEC/AluEN: J112.1; also elsewhere on the board
/OutDEC/OR: J119.1; also elsewhere on the board
/OutDEC/S0: Q124.3 (D), R118.2; also elsewhere on the board
/OutDEC/S1: Q127.3 (D), R119.2; also elsewhere on the board
/OutDEC/S2: Q130.3 (D), R120.2; also elsewhere on the board
/OutDEC/~ADD: Q121.2 (G); also elsewhere on the board
/OutDEC/~S0: J116.1, Q124.2 (G); also elsewhere on the board
/OutDEC/~S1: J118.1, Q127.2 (G); also elsewhere on the board
/OutDEC/~S2: J120.1, Q130.2 (G); also elsewhere on the board
/Zstore/D: Q106.3 (D), Q107.3 (D), Q108.3 (D), Q109.3 (D), Q110.3 (D), Q111.3 (D), Q112.3 (D), Q113.3 (D), R107.2; also elsewhere on the board
/Zstore/Q: J106.2; also elsewhere on the board
/Zstore/~Q: J106.1; also elsewhere on the board
GND: D101.2 (A), D102.2 (A), J103.2, Q102.1 (S), Q103.3 (E), Q104.1 (S), Q105.1 (S), Q106.1 (S), Q107.1 (S), Q108.1 (S), Q109.1 (S), Q110.1 (S), Q111.1 (S), Q112.1 (S), Q113.1 (S), Q114.1 (S), Q115.3 (E), Q116.1 (S), Q117.1 (S), Q118.1 (S), Q120.1 (S), Q123.1 (S), Q124.1 (S), Q127.1 (S), Q128.1 (S), Q129.1 (S), Q130.1 (S), R103.1, R109.1; also elsewhere on the board
unnamed: C101.1, D101.1 (K), R103.2, R106.2
unnamed: C101.2, Q102.3 (D), R102.2
unnamed: C102.1, D102.1 (K), R109.2, R112.2
unnamed: C102.2, Q114.3 (D), R108.2
unnamed: J101.1, J102.1, Q106.2 (G)
unnamed: J101.2, J102.2, Q107.2 (G)
unnamed: J101.3, J102.3, Q108.2 (G)
unnamed: J101.4, J102.4, Q109.2 (G)
unnamed: J101.5, J102.5, Q110.2 (G)
unnamed: J101.6, J102.6, Q111.2 (G)
unnamed: J101.7, J102.7, Q112.2 (G)
unnamed: J101.8, J102.8, Q113.2 (G)
unnamed: J104.1, Q101.2 (G)
unnamed: J105.1, Q105.2 (G), Q114.2 (G)
unnamed: J111.1, Q119.3 (D), R115.2
unnamed: J122.1, Q123.2 (G)
unnamed: J123.1, Q126.2 (G)
unnamed: J124.1, Q129.2 (G)
unnamed: Q101.1 (S), Q105.3 (D)
unnamed: Q101.3 (D), Q102.2 (G), R101.2
unnamed: Q103.1 (C), Q104.2 (G), R104.2
unnamed: Q103.2 (B), R106.1
unnamed: Q115.1 (C), Q116.2 (G), R110.2
unnamed: Q115.2 (B), R112.1
unnamed: Q119.1 (S), Q120.3 (D)
unnamed: Q121.1 (S), Q122.1 (S), Q125.3 (D), Q126.3 (D)
unnamed: Q122.2 (G), Q123.3 (D), R117.2
unnamed: Q125.1 (S), Q126.1 (S), Q128.3 (D), Q129.3 (D)
VCC: J103.1, R101.1, R102.1, R104.1, R105.1, R107.1, R108.1, R110.1, R111.1, R113.1, R114.1, R115.1, R116.1, R117.1, R118.1, R119.1, R120.1; also elsewhere on the board

Notes on the sheet:
Output enables
Cout
Carryflag
CLK
Zflag
B enables
Cin
Output selection

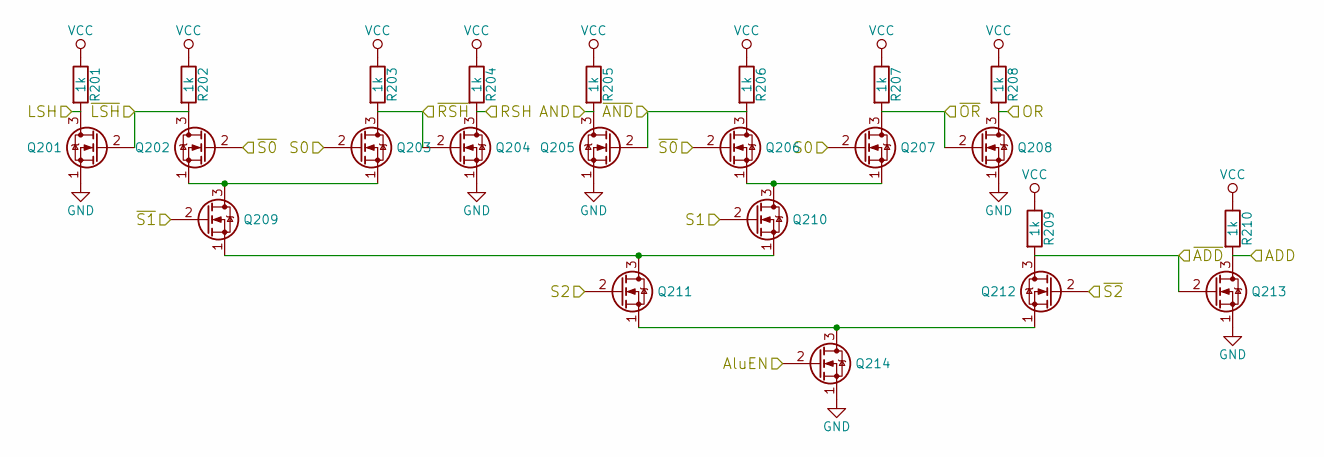
[picture p28: schematic OutDEC.sch]

Parts:
Q201, Q202, Q203, Q204, Q205, Q206, Q207, Q208, Q209, Q210, Q211, Q212, Q213, Q214: 2N7000; TO-92-FET
R201, R202, R203, R204, R205, R206, R207, R208, R209, R210: 1k; R_small

Connections:
/BDEC/LSH: Q201.3 (D), R201.2; also elsewhere on the board
/BDEC/RSH: Q204.3 (D), R204.2; also elsewhere on the board
/BDEC/~LSH: Q201.2 (G), Q202.3 (D), R202.2; also elsewhere on the board
/BDEC/~RSH: Q203.3 (D), Q204.2 (G), R203.2; also elsewhere on the board
/OutDEC/ADD: Q213.3 (D), R210.2; also elsewhere on the board
/OutDEC/AND: Q205.3 (D), R205.2; also elsewhere on the board
/OutDEC/AluEN: Q214.2 (G); also elsewhere on the board
/OutDEC/OR: Q208.3 (D), R208.2; also elsewhere on the board
/OutDEC/S0: Q203.2 (G), Q207.2 (G); also elsewhere on the board
/OutDEC/S1: Q210.2 (G); also elsewhere on the board
/OutDEC/S2: Q211.2 (G); also elsewhere on the board
/OutDEC/~ADD: Q212.3 (D), Q213.2 (G), R209.2; also elsewhere on the board
/OutDEC/~AND: Q205.2 (G), Q206.3 (D), R206.2
/OutDEC/~OR: Q207.3 (D), Q208.2 (G), R207.2
/OutDEC/~S0: Q202.2 (G), Q206.2 (G); also elsewhere on the board
/OutDEC/~S1: Q209.2 (G); also elsewhere on the board
/OutDEC/~S2: Q212.2 (G); also elsewhere on the board
GND: Q201.1 (S), Q204.1 (S), Q205.1 (S), Q208.1 (S), Q213.1 (S), Q214.1 (S); also elsewhere on the board
unnamed: Q202.1 (S), Q203.1 (S), Q209.3 (D)
unnamed: Q206.1 (S), Q207.1 (S), Q210.3 (D)
unnamed: Q209.1 (S), Q210.1 (S), Q211.3 (D)
unnamed: Q211.1 (S), Q212.1 (S), Q214.3 (D)
VCC: R201.1, R202.1, R203.1, R204.1, R205.1, R206.1, R207.1, R208.1, R209.1, R210.1; also elsewhere on the board

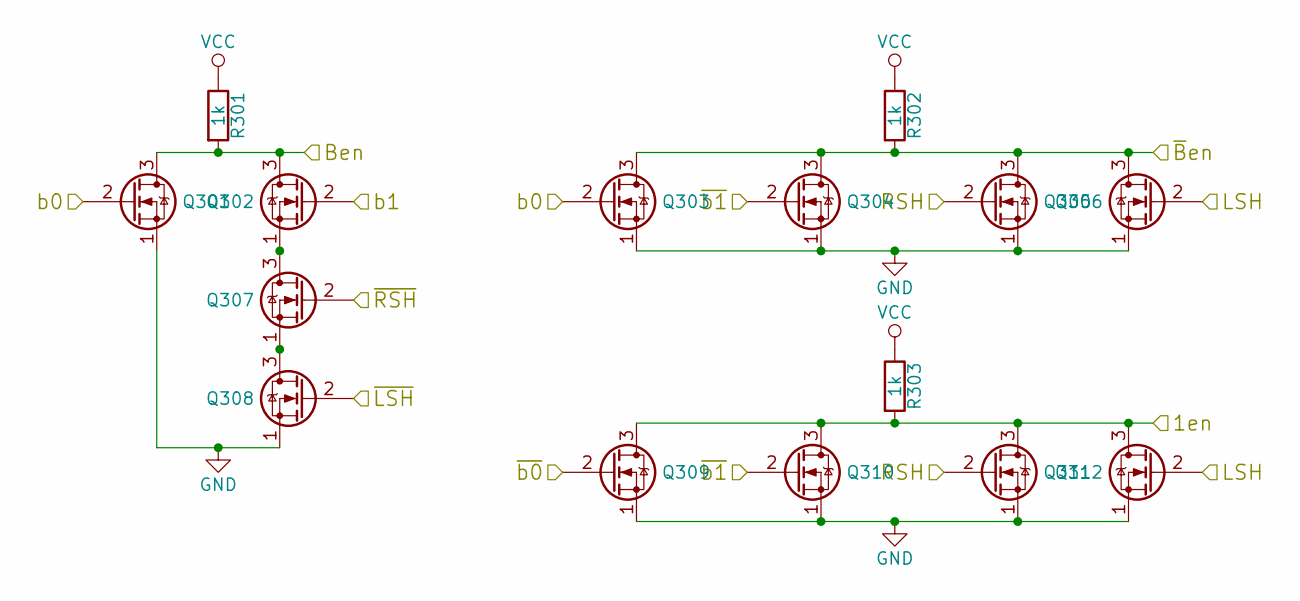
[picture p29: schematic BDEC.sch]

Parts:
Q301, Q302, Q303, Q304, Q305, Q306, Q307, Q308, Q309, Q310, Q311, Q312: 2N7000; TO-92-FET
R301, R302, R303: 1k; R_small

Connections:
/BDEC/1en: Q309.3 (D), Q310.3 (D), Q311.3 (D), Q312.3 (D), R303.2; also elsewhere on the board
/BDEC/Ben: Q301.3 (D), Q302.3 (D), R301.2; also elsewhere on the board
/BDEC/LSH: Q306.2 (G), Q312.2 (G); also elsewhere on the board
/BDEC/RSH: Q305.2 (G), Q311.2 (G); also elsewhere on the board
/BDEC/b0: Q301.2 (G), Q303.2 (G); also elsewhere on the board
/BDEC/b1: Q302.2 (G); also elsewhere on the board
/BDEC/~B~en: Q303.3 (D), Q304.3 (D), Q305.3 (D), Q306.3 (D), R302.2; also elsewhere on the board
/BDEC/~LSH: Q308.2 (G); also elsewhere on the board
/BDEC/~RSH: Q307.2 (G); also elsewhere on the board
/BDEC/~b0: Q309.2 (G); also elsewhere on the board
/BDEC/~b1: Q304.2 (G), Q310.2 (G); also elsewhere on the board
GND: Q301.1 (S), Q303.1 (S), Q304.1 (S), Q305.1 (S), Q306.1 (S), Q308.1 (S), Q309.1 (S), Q310.1 (S), Q311.1 (S), Q312.1 (S); also elsewhere on the board
unnamed: Q302.1 (S), Q307.3 (D)
unnamed: Q307.1 (S), Q308.3 (D)
VCC: R301.1, R302.1, R303.1; also elsewhere on the board

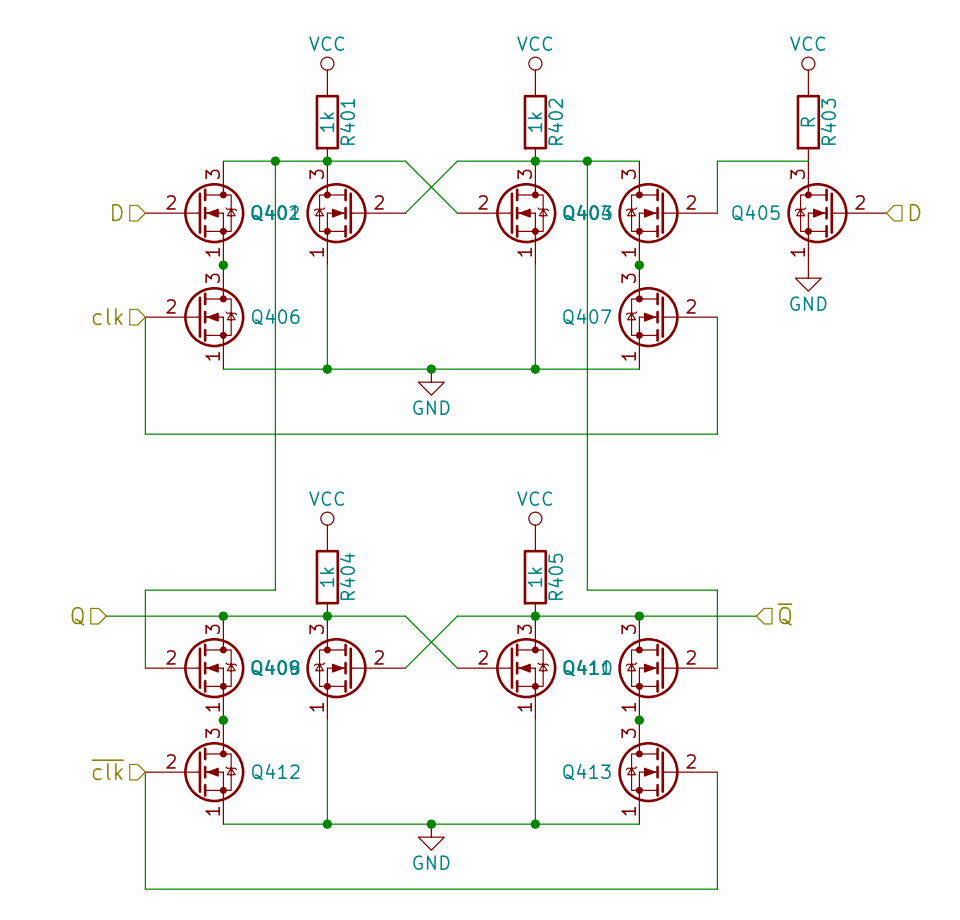
[picture p30: schematic Cstore.sch]

Parts:
Q401, Q402, Q403, Q404, Q405, Q406, Q407, Q408, Q409, Q410, Q411, Q412, Q413: 2N7000; TO-92-FET
R401, R402, R404, R405: 1k; R_small
R403: R; R_small

Connections:
/Cstore/D: Q401.2 (G), Q405.2 (G); also elsewhere on the board
/Cstore/Q: Q408.3 (D), Q409.3 (D), Q410.2 (G), R404.2; also elsewhere on the board
/Cstore/clk: Q406.2 (G), Q407.2 (G); also elsewhere on the board
/Cstore/~Q: Q409.2 (G), Q410.3 (D), Q411.3 (D), R405.2; also elsewhere on the board
/Cstore/~clk: Q412.2 (G), Q413.2 (G); also elsewhere on the board
GND: Q402.1 (S), Q403.1 (S), Q405.1 (S), Q406.1 (S), Q407.1 (S), Q409.1 (S), Q410.1 (S), Q412.1 (S), Q413.1 (S); also elsewhere on the board
unnamed: Q401.1 (S), Q406.3 (D)
unnamed: Q401.3 (D), Q402.3 (D), Q403.2 (G), Q408.2 (G), R401.2
unnamed: Q402.2 (G), Q403.3 (D), Q404.3 (D), Q411.2 (G), R402.2
unnamed: Q404.1 (S), Q407.3 (D)
unnamed: Q404.2 (G), Q405.3 (D), R403.2
unnamed: Q408.1 (S), Q412.3 (D)
unnamed: Q411.1 (S), Q413.3 (D)
VCC: R401.1, R402.1, R403.1, R404.1, R405.1; also elsewhere on the board

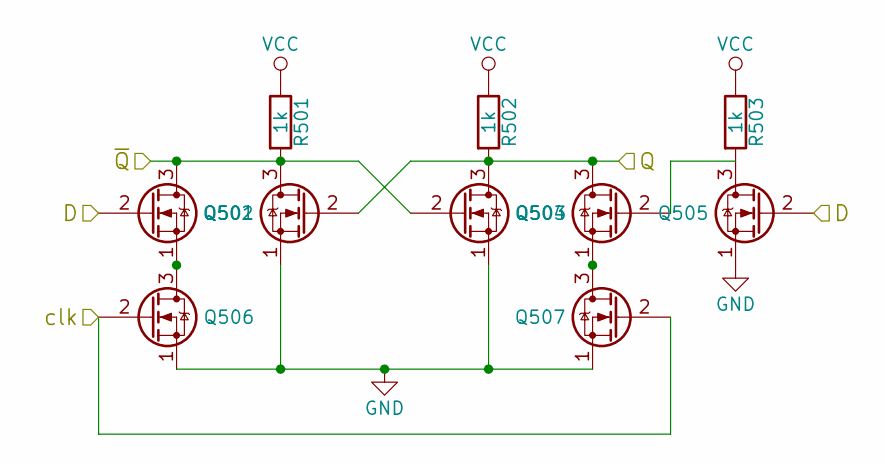
[picture p31: schematic Zstore.sch]

Parts:
Q501, Q502, Q503, Q504, Q505, Q506, Q507: 2N7000; TO-92-FET
R501, R502, R503: 1k; R_small

Connections:
/Cstore/clk: Q506.2 (G), Q507.2 (G); also elsewhere on the board
/Zstore/D: Q501.2 (G), Q505.2 (G); also elsewhere on the board
/Zstore/Q: Q502.2 (G), Q503.3 (D), Q504.3 (D), R502.2; also elsewhere on the board
/Zstore/~Q: Q501.3 (D), Q502.3 (D), Q503.2 (G), R501.2; also elsewhere on the board
GND: Q502.1 (S), Q503.1 (S), Q505.1 (S), Q506.1 (S), Q507.1 (S); also elsewhere on the board
unnamed: Q501.1 (S), Q506.3 (D)
unnamed: Q504.1 (S), Q507.3 (D)
unnamed: Q504.2 (G), Q505.3 (D), R503.2
VCC: R501.1, R502.1, R503.1; also elsewhere on the board

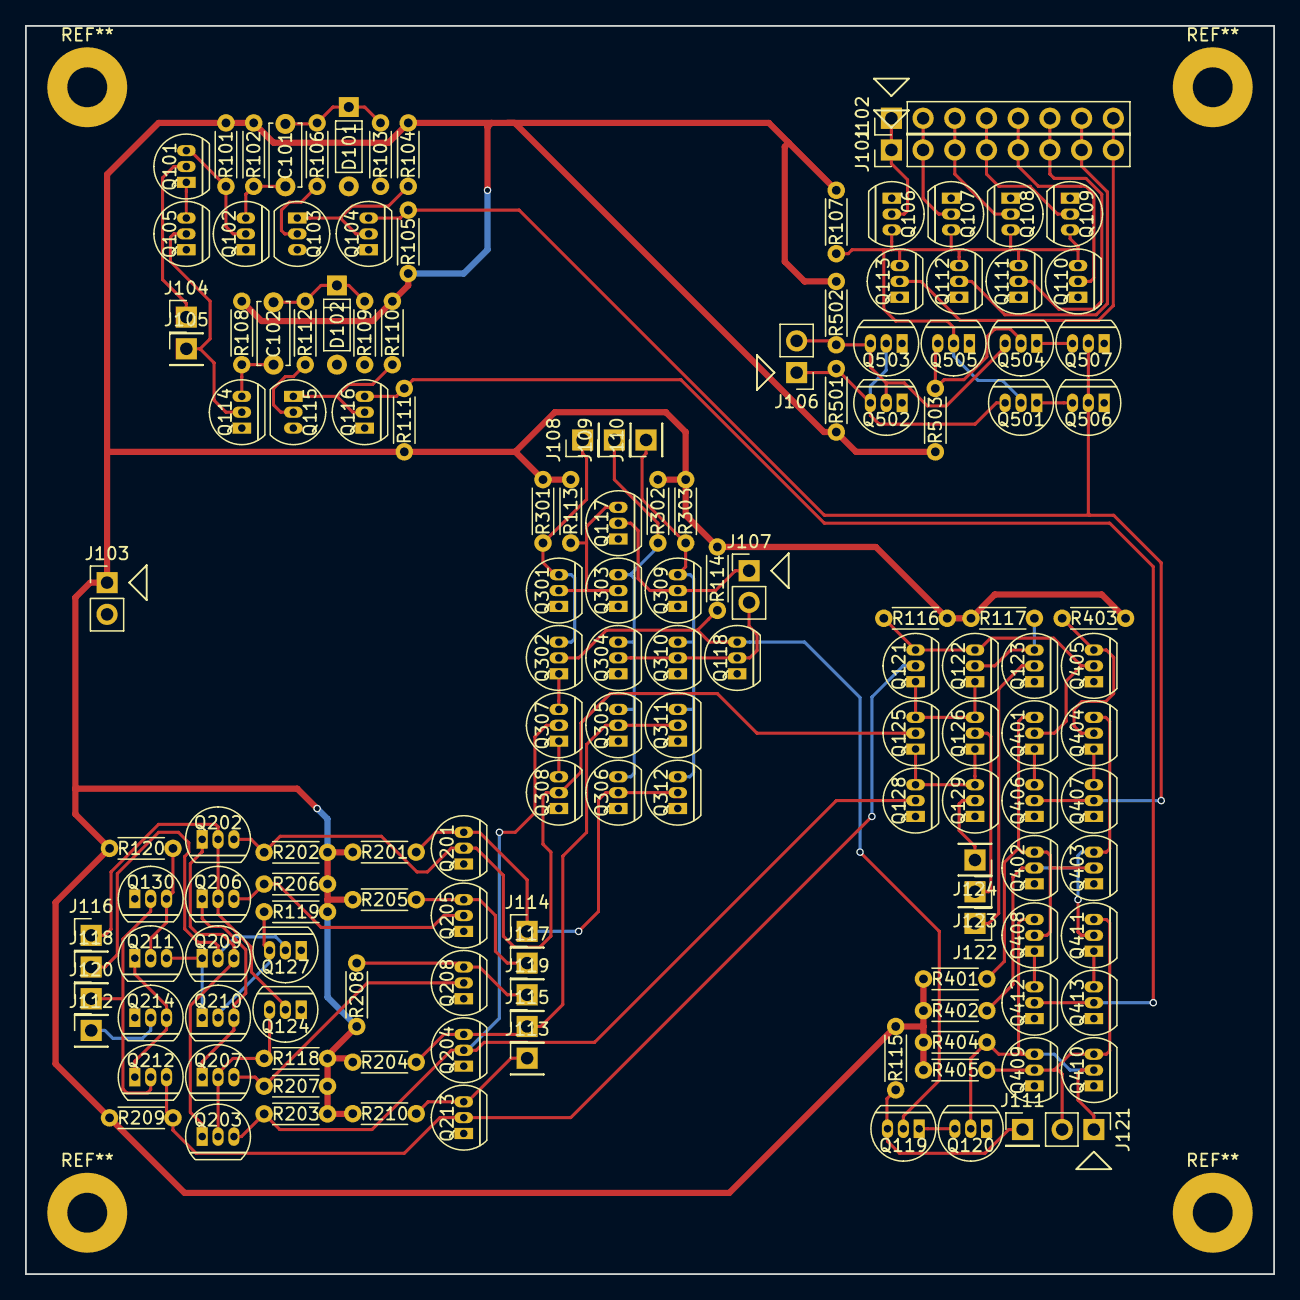
[picture p32: board control.kicad_pcb from above]

Board: 2 copper layers, 100.0 x 100.0 mm, 145 parts (0 on the bottom side), 78 nets.
