davidv1992/Trans1/designs/memory/ram/ram.kicad_pcb

## KiCad design designs/memory/ram/ram.kicad_pcb (2025-08-03)

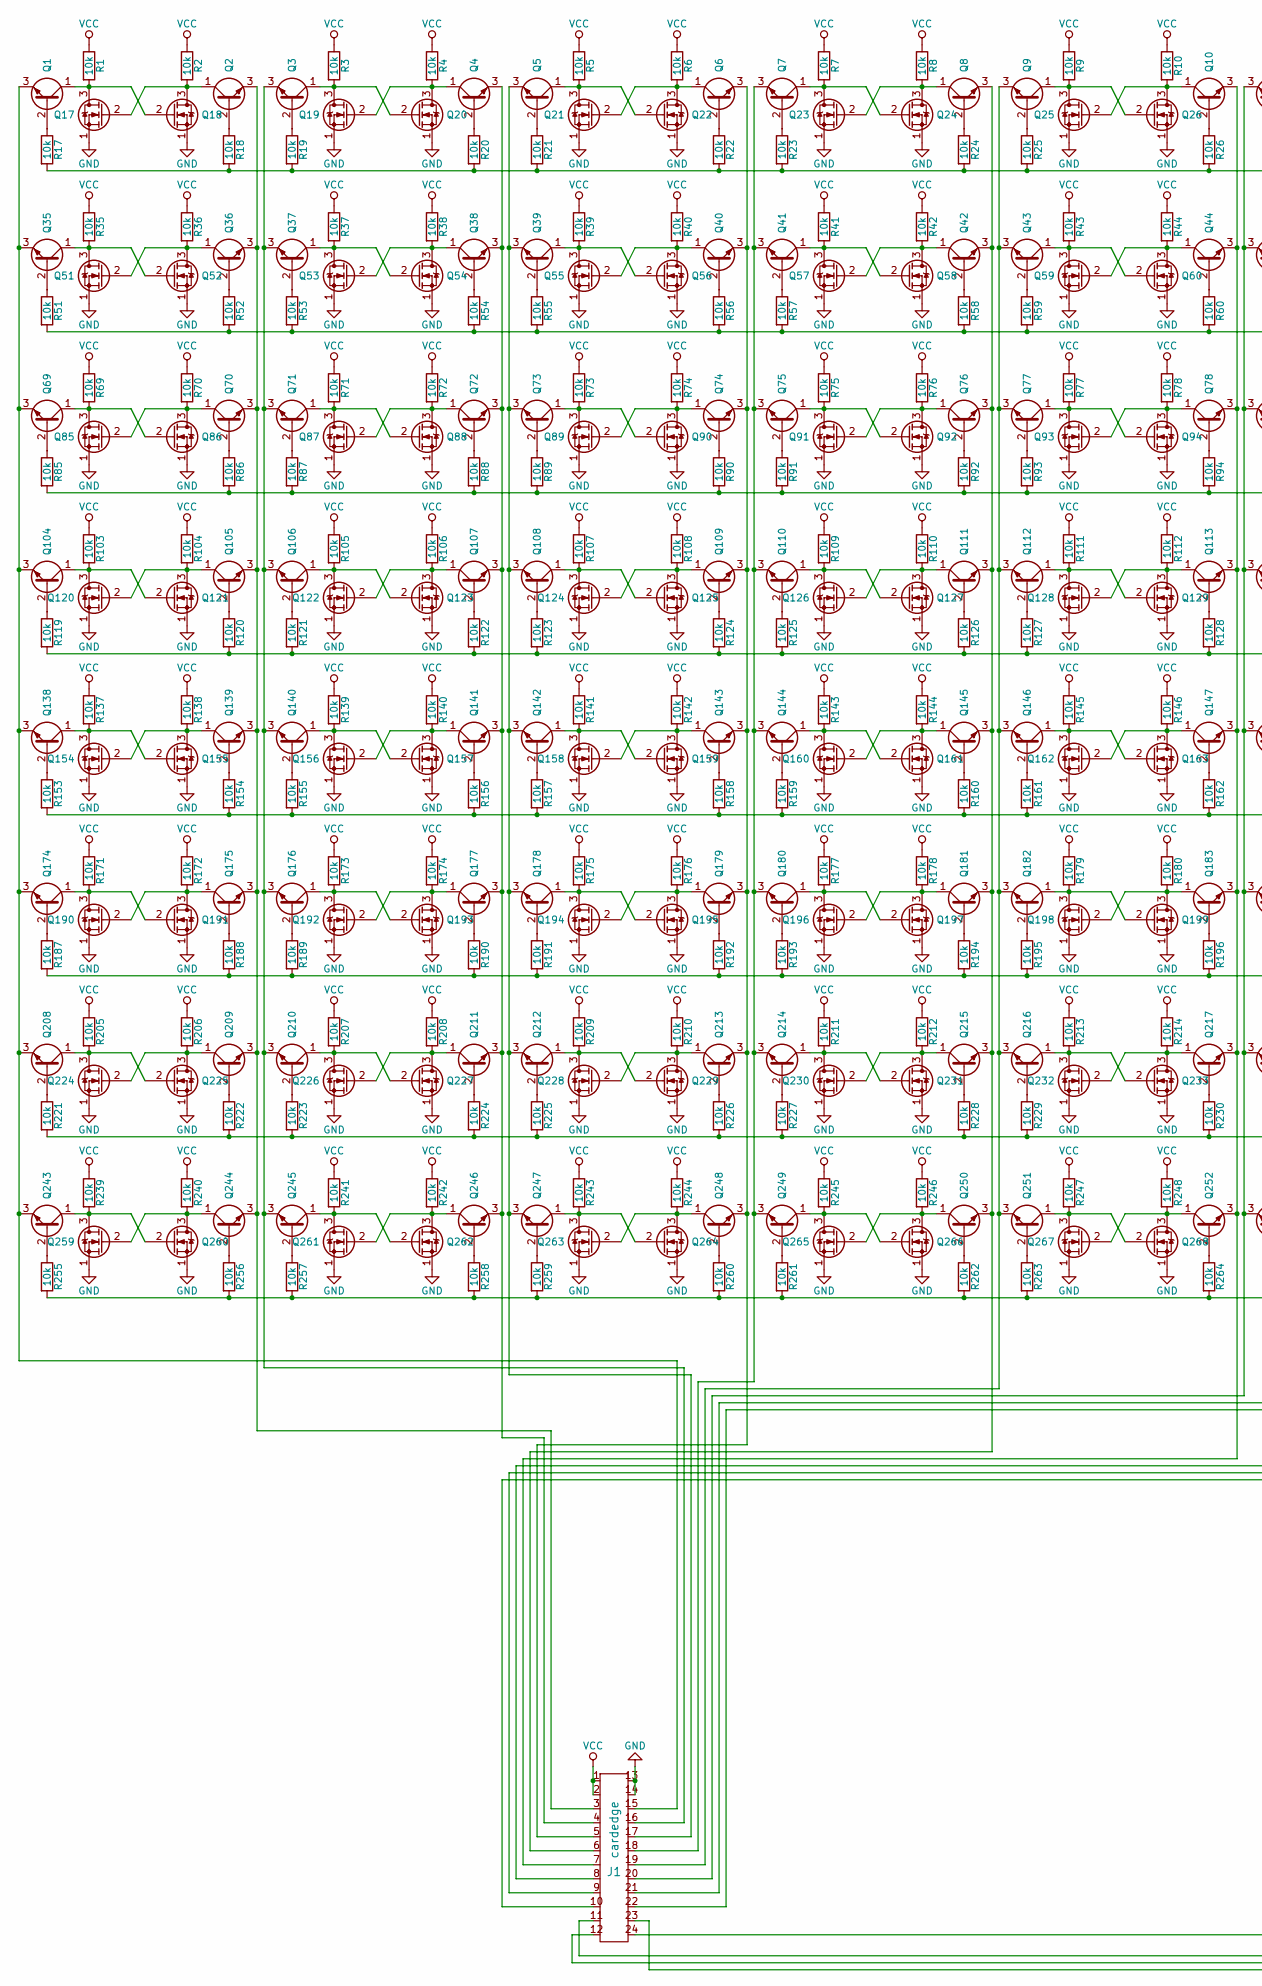
[picture p33: schematic ram.sch, part in row 1, column 1]

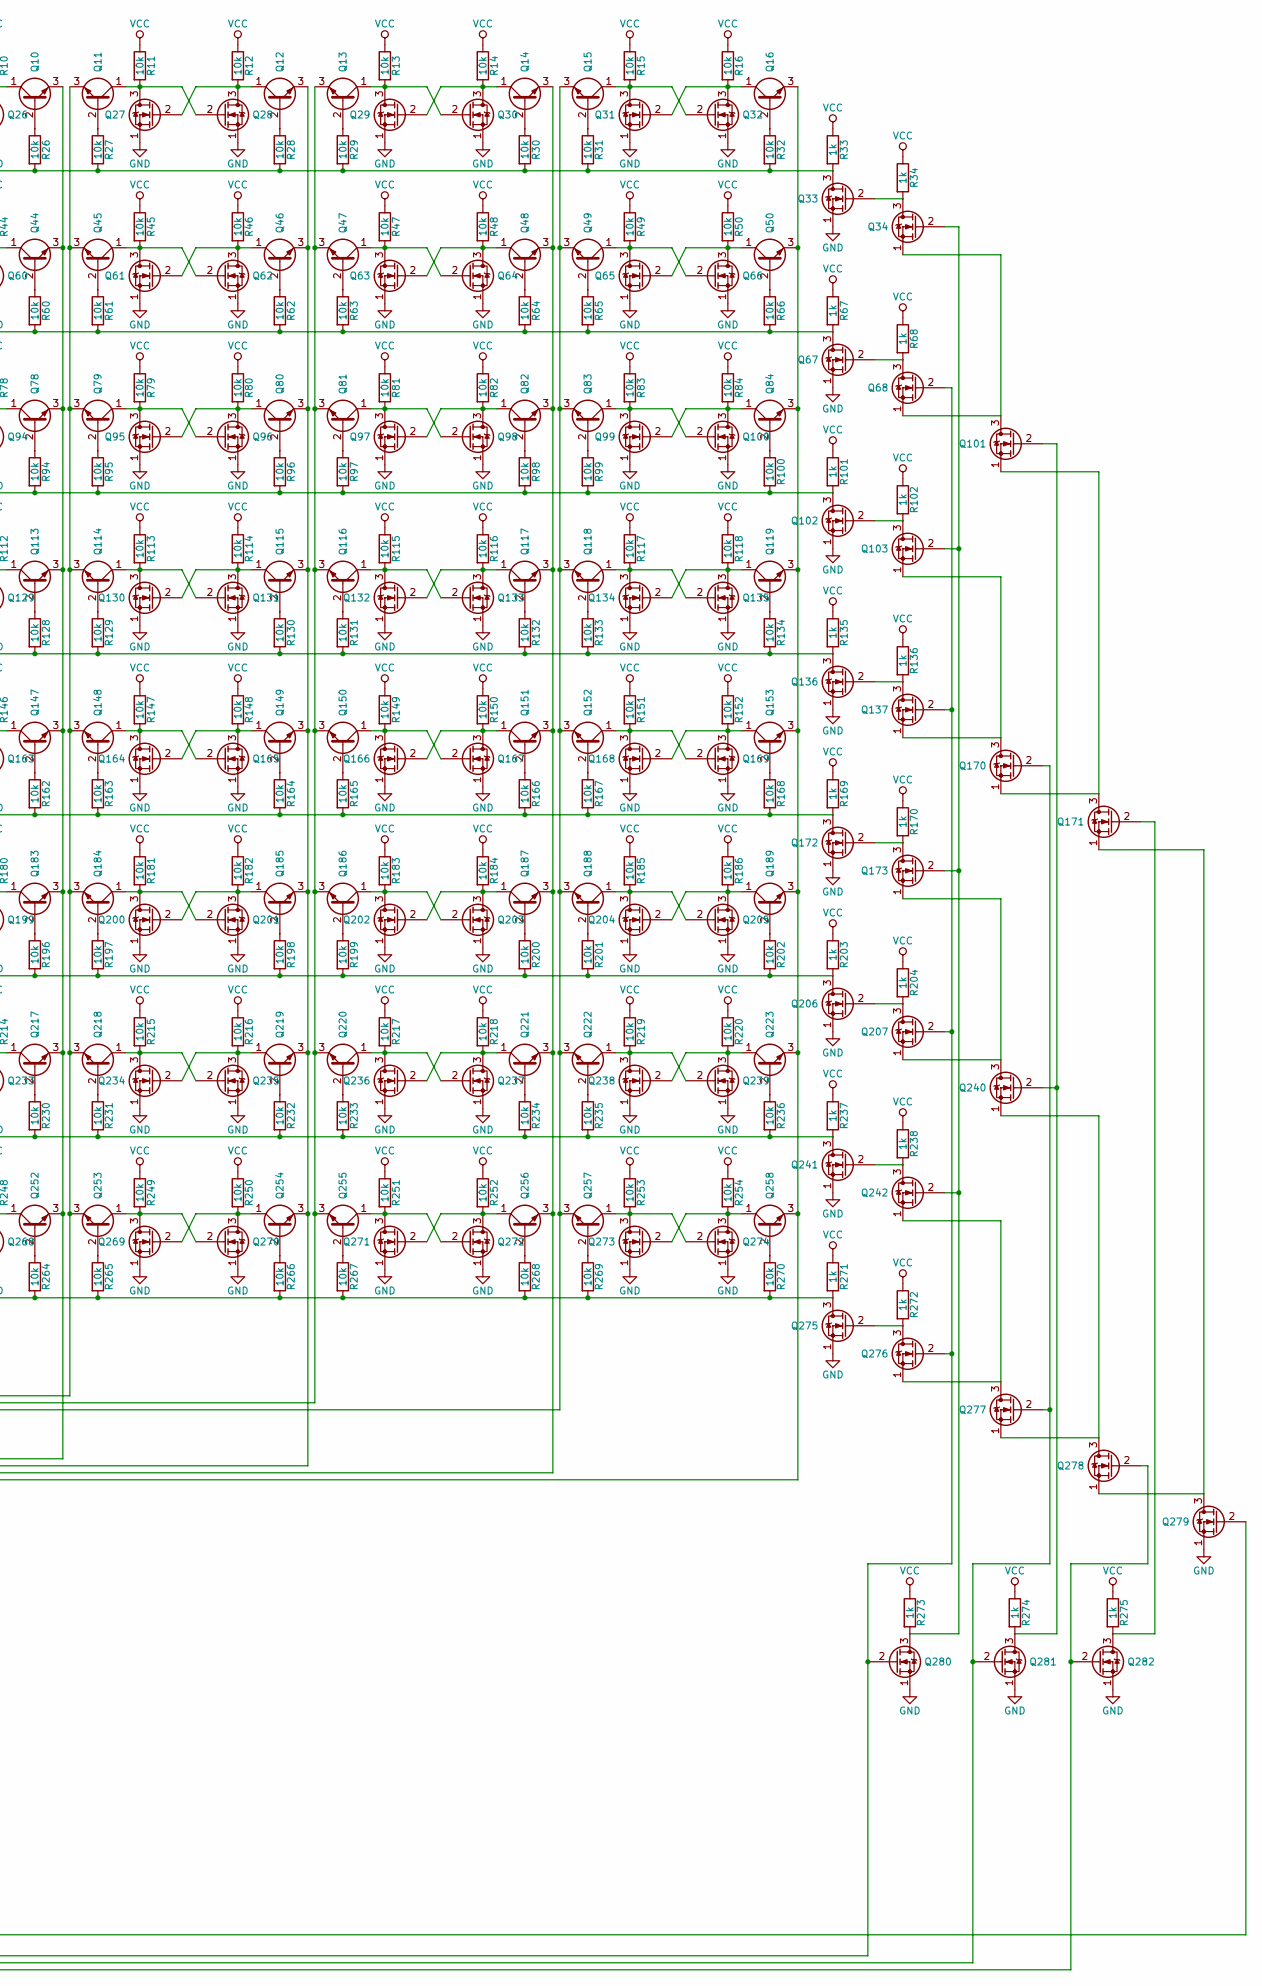
[picture p34: schematic ram.sch, part in row 1, column 2]

Parts:
J1: cardedge; cardedge_12p
Q1, Q2, Q3, Q4, Q5, Q6, Q7, Q8, Q9, Q10, Q11, Q12, Q13, Q14, Q15, Q16, Q35, Q36, Q37, Q38, Q39, Q40, Q41, Q42, Q43, Q44, Q45, Q46, Q47, Q48, Q49, Q50, Q69, Q70, Q71, Q72, Q73, Q74, Q75, Q76, Q77, Q78, Q79, Q80, Q81, Q82, Q83, Q84, Q104, Q105, Q106, Q107, Q108, Q109, Q110, Q111, Q112, Q113, Q114, Q115, Q116, Q117, Q118, Q119, Q138, Q139, Q140, Q141, Q142, Q143, Q144, Q145, Q146, Q147, Q148, Q149, Q150, Q151, Q152, Q153, Q174, Q175, Q176, Q177, Q178, Q179, Q180, Q181, Q182, Q183, Q184, Q185, Q186, Q187, Q188, Q189, Q208, Q209, Q210, Q211, Q212, Q213, Q214, Q215, Q216, Q217, Q218, Q219, Q220, Q221, Q222, Q223, Q243, Q244, Q245, Q246, Q247, Q248, Q249, Q250, Q251, Q252, Q253, Q254, Q255, Q256, Q257, Q258: BC547; TO-92-BJT
Q17, Q18, Q19, Q20, Q21, Q22, Q23, Q24, Q25, Q26, Q27, Q28, Q29, Q30, Q31, Q32, Q33, Q34, Q51, Q52, Q53, Q54, Q55, Q56, Q57, Q58, Q59, Q60, Q61, Q62, Q63, Q64, Q65, Q66, Q67, Q68, Q85, Q86, Q87, Q88, Q89, Q90, Q91, Q92, Q93, Q94, Q95, Q96, Q97, Q98, Q99, Q100, Q101, Q102, Q103, Q120, Q121, Q122, Q123, Q124, Q125, Q126, Q127, Q128, Q129, Q130, Q131, Q132, Q133, Q134, Q135, Q136, Q137, Q154, Q155, Q156, Q157, Q158, Q159, Q160, Q161, Q162, Q163, Q164, Q165, Q166, Q167, Q168, Q169, Q170, Q171, Q172, Q173, Q190, Q191, Q192, Q193, Q194, Q195, Q196, Q197, Q198, Q199, Q200, Q201, Q202, Q203, Q204, Q205, Q206, Q207, Q224, Q225, Q226, Q227, Q228, Q229, Q230, Q231, Q232, Q233, Q234, Q235, Q236, Q237, Q238, Q239, Q240, Q241, Q242, Q259, Q260, Q261, Q262, Q263, Q264, Q265, Q266, Q267, Q268, Q269, Q270, Q271, Q272, Q273, Q274, Q275, Q276, Q277, Q278, Q279, Q280, Q281, Q282: 2N7000; TO-92-FET
R1, R2, R3, R4, R5, R6, R7, R8, R9, R10, R11, R12, R13, R14, R15, R16, R17, R18, R19, R20, R21, R22, R23, R24, R25, R26, R27, R28, R29, R30, R31, R32, R35, R36, R37, R38, R39, R40, R41, R42, R43, R44, R45, R46, R47, R48, R49, R50, R51, R52, R53, R54, R55, R56, R57, R58, R59, R60, R61, R62, R63, R64, R65, R66, R69, R70, R71, R72, R73, R74, R75, R76, R77, R78, R79, R80, R81, R82, R83, R84, R85, R86, R87, R88, R89, R90, R91, R92, R93, R94, R95, R96, R97, R98, R99, R100, R103, R104, R105, R106, R107, R108, R109, R110, R111, R112, R113, R114, R115, R116, R117, R118, R119, R120, R121, R122, R123, R124, R125, R126, R127, R128, R129, R130, R131, R132, R133, R134, R137, R138, R139, R140, R141, R142, R143, R144, R145, R146, R147, R148, R149, R150, R151, R152, R153, R154, R155, R156, R157, R158, R159, R160, R161, R162, R163, R164, R165, R166, R167, R168, R171, R172, R173, R174, R175, R176, R177, R178, R179, R180, R181, R182, R183, R184, R185, R186, R187, R188, R189, R190, R191, R192, R193, R194, R195, R196, R197, R198, R199, R200, R201, R202, R205, R206, R207, R208, R209, R210, R211, R212, R213, R214, R215, R216, R217, R218, R219, R220, R221, R222, R223, R224, R225, R226, R227, R228, R229, R230, R231, R232, R233, R234, R235, R236, R239, R240, R241, R242, R243, R244, R245, R246, R247, R248, R249, R250, R251, R252, R253, R254, R255, R256, R257, R258, R259, R260, R261, R262, R263, R264, R265, R266, R267, R268, R269, R270: 10k; R_small
R33, R34, R67, R68, R101, R102, R135, R136, R169, R170, R203, R204, R237, R238, R271, R272, R273, R274, R275: 1k; R_small

Connections:
GND: J1.13, J1.14, Q17.1 (S), Q18.1 (S), Q19.1 (S), Q20.1 (S), Q21.1 (S), Q22.1 (S), Q23.1 (S), Q24.1 (S), Q25.1 (S), Q26.1 (S), Q27.1 (S), Q28.1 (S), Q29.1 (S), Q30.1 (S), Q31.1 (S), Q32.1 (S), Q33.1 (S), Q51.1 (S), Q52.1 (S), Q53.1 (S), Q54.1 (S), Q55.1 (S), Q56.1 (S), Q57.1 (S), Q58.1 (S), Q59.1 (S), Q60.1 (S), Q61.1 (S), Q62.1 (S), Q63.1 (S), Q64.1 (S), Q65.1 (S), Q66.1 (S), Q67.1 (S), Q85.1 (S), Q86.1 (S), Q87.1 (S), Q88.1 (S), Q89.1 (S), Q90.1 (S), Q91.1 (S), Q92.1 (S), Q93.1 (S), Q94.1 (S), Q95.1 (S), Q96.1 (S), Q97.1 (S), Q98.1 (S), Q99.1 (S), Q100.1 (S), Q102.1 (S), Q120.1 (S), Q121.1 (S), Q122.1 (S), Q123.1 (S), Q124.1 (S), Q125.1 (S), Q126.1 (S), Q127.1 (S), Q128.1 (S), Q129.1 (S), Q130.1 (S), Q131.1 (S), Q132.1 (S), Q133.1 (S), Q134.1 (S), Q135.1 (S), Q136.1 (S), Q154.1 (S), Q155.1 (S), Q156.1 (S), Q157.1 (S), Q158.1 (S), Q159.1 (S), Q160.1 (S), Q161.1 (S), Q162.1 (S), Q163.1 (S), Q164.1 (S), Q165.1 (S), Q166.1 (S), Q167.1 (S), Q168.1 (S), Q169.1 (S), Q172.1 (S), Q190.1 (S), Q191.1 (S), Q192.1 (S), Q193.1 (S), Q194.1 (S), Q195.1 (S), Q196.1 (S), Q197.1 (S), Q198.1 (S), Q199.1 (S), Q200.1 (S), Q201.1 (S), Q202.1 (S), Q203.1 (S), Q204.1 (S), Q205.1 (S), Q206.1 (S), Q224.1 (S), Q225.1 (S), Q226.1 (S), Q227.1 (S), Q228.1 (S), Q229.1 (S), Q230.1 (S), Q231.1 (S), Q232.1 (S), Q233.1 (S), Q234.1 (S), Q235.1 (S), Q236.1 (S), Q237.1 (S), Q238.1 (S), Q239.1 (S), Q241.1 (S), Q259.1 (S), Q260.1 (S), Q261.1 (S), Q262.1 (S), Q263.1 (S), Q264.1 (S), Q265.1 (S), Q266.1 (S), Q267.1 (S), Q268.1 (S), Q269.1 (S), Q270.1 (S), Q271.1 (S), Q272.1 (S), Q273.1 (S), Q274.1 (S), Q275.1 (S), Q279.1 (S), Q280.1 (S), Q281.1 (S), Q282.1 (S)
unnamed: J1.3, Q2.3 (E), Q36.3 (E), Q70.3 (E), Q105.3 (E), Q139.3 (E), Q175.3 (E), Q209.3 (E), Q244.3 (E)
unnamed: J1.4, Q4.3 (E), Q38.3 (E), Q72.3 (E), Q107.3 (E), Q141.3 (E), Q177.3 (E), Q211.3 (E), Q246.3 (E)
unnamed: J1.5, Q6.3 (E), Q40.3 (E), Q74.3 (E), Q109.3 (E), Q143.3 (E), Q179.3 (E), Q213.3 (E), Q248.3 (E)
unnamed: J1.6, Q8.3 (E), Q42.3 (E), Q76.3 (E), Q111.3 (E), Q145.3 (E), Q181.3 (E), Q215.3 (E), Q250.3 (E)
unnamed: J1.7, Q10.3 (E), Q44.3 (E), Q78.3 (E), Q113.3 (E), Q147.3 (E), Q183.3 (E), Q217.3 (E), Q252.3 (E)
unnamed: J1.8, Q12.3 (E), Q46.3 (E), Q80.3 (E), Q115.3 (E), Q149.3 (E), Q185.3 (E), Q219.3 (E), Q254.3 (E)
unnamed: J1.9, Q14.3 (E), Q48.3 (E), Q82.3 (E), Q117.3 (E), Q151.3 (E), Q187.3 (E), Q221.3 (E), Q256.3 (E)
unnamed: J1.10, Q16.3 (E), Q50.3 (E), Q84.3 (E), Q119.3 (E), Q153.3 (E), Q189.3 (E), Q223.3 (E), Q258.3 (E)
unnamed: J1.11, Q68.2 (G), Q137.2 (G), Q207.2 (G), Q276.2 (G), Q280.2 (G)
unnamed: J1.12, Q170.2 (G), Q277.2 (G), Q281.2 (G)
unnamed: J1.15, Q1.3 (E), Q35.3 (E), Q69.3 (E), Q104.3 (E), Q138.3 (E), Q174.3 (E), Q208.3 (E), Q243.3 (E)
unnamed: J1.16, Q3.3 (E), Q37.3 (E), Q71.3 (E), Q106.3 (E), Q140.3 (E), Q176.3 (E), Q210.3 (E), Q245.3 (E)
unnamed: J1.17, Q5.3 (E), Q39.3 (E), Q73.3 (E), Q108.3 (E), Q142.3 (E), Q178.3 (E), Q212.3 (E), Q247.3 (E)
unnamed: J1.18, Q7.3 (E), Q41.3 (E), Q75.3 (E), Q110.3 (E), Q144.3 (E), Q180.3 (E), Q214.3 (E), Q249.3 (E)
unnamed: J1.19, Q9.3 (E), Q43.3 (E), Q77.3 (E), Q112.3 (E), Q146.3 (E), Q182.3 (E), Q216.3 (E), Q251.3 (E)
unnamed: J1.20, Q11.3 (E), Q45.3 (E), Q79.3 (E), Q114.3 (E), Q148.3 (E), Q184.3 (E), Q218.3 (E), Q253.3 (E)
unnamed: J1.21, Q13.3 (E), Q47.3 (E), Q81.3 (E), Q116.3 (E), Q150.3 (E), Q186.3 (E), Q220.3 (E), Q255.3 (E)
unnamed: J1.22, Q15.3 (E), Q49.3 (E), Q83.3 (E), Q118.3 (E), Q152.3 (E), Q188.3 (E), Q222.3 (E), Q257.3 (E)
unnamed: J1.23, Q278.2 (G), Q282.2 (G)
unnamed: J1.24, Q279.2 (G)
unnamed: Q1.1 (C), Q17.3 (D), Q18.2 (G), R1.2
unnamed: Q1.2 (B), R17.1
unnamed: Q2.2 (B), R18.1
unnamed: Q3.2 (B), R19.1
unnamed: Q4.2 (B), R20.1
unnamed: Q5.2 (B), R21.1
unnamed: Q6.2 (B), R22.1
unnamed: Q7.2 (B), R23.1
unnamed: Q8.2 (B), R24.1
unnamed: Q9.2 (B), R25.1
unnamed: Q10.1 (C), Q25.2 (G), Q26.3 (D), R10.2
unnamed: Q10.2 (B), R26.1
unnamed: Q11.1 (C), Q27.3 (D), Q28.2 (G), R11.2
unnamed: Q11.2 (B), R27.1
unnamed: Q12.1 (C), Q27.2 (G), Q28.3 (D), R12.2
unnamed: Q12.2 (B), R28.1
unnamed: Q13.1 (C), Q29.3 (D), Q30.2 (G), R13.2
unnamed: Q13.2 (B), R29.1
unnamed: Q14.1 (C), Q29.2 (G), Q30.3 (D), R14.2
unnamed: Q14.2 (B), R30.1
unnamed: Q15.1 (C), Q31.3 (D), Q32.2 (G), R15.2
unnamed: Q15.2 (B), R31.1
unnamed: Q16.1 (C), Q31.2 (G), Q32.3 (D), R16.2
unnamed: Q16.2 (B), R32.1
unnamed: Q2.1 (C), Q17.2 (G), Q18.3 (D), R2.2
unnamed: Q4.1 (C), Q19.2 (G), Q20.3 (D), R4.2
unnamed: Q3.1 (C), Q19.3 (D), Q20.2 (G), R3.2
unnamed: Q6.1 (C), Q21.2 (G), Q22.3 (D), R6.2
unnamed: Q5.1 (C), Q21.3 (D), Q22.2 (G), R5.2
unnamed: Q8.1 (C), Q23.2 (G), Q24.3 (D), R8.2
unnamed: Q7.1 (C), Q23.3 (D), Q24.2 (G), R7.2
unnamed: Q9.1 (C), Q25.3 (D), Q26.2 (G), R9.2
unnamed: Q33.2 (G), Q34.3 (D), R34.2
unnamed: Q33.3 (D), R17.2, R18.2, R19.2, R20.2, R21.2, R22.2, R23.2, R24.2, R25.2, R26.2, R27.2, R28.2, R29.2, R30.2, R31.2, R32.2, R33.2
unnamed: Q35.1 (C), Q51.3 (D), Q52.2 (G), R35.2
unnamed: Q35.2 (B), R51.1
unnamed: Q36.1 (C), Q51.2 (G), Q52.3 (D), R36.2
unnamed: Q36.2 (B), R52.1
unnamed: Q37.1 (C), Q53.3 (D), Q54.2 (G), R37.2
unnamed: Q37.2 (B), R53.1
unnamed: Q38.1 (C), Q53.2 (G), Q54.3 (D), R38.2
unnamed: Q38.2 (B), R54.1
unnamed: Q39.1 (C), Q55.3 (D), Q56.2 (G), R39.2
unnamed: Q39.2 (B), R55.1
unnamed: Q40.1 (C), Q55.2 (G), Q56.3 (D), R40.2
unnamed: Q40.2 (B), R56.1
unnamed: Q41.1 (C), Q57.3 (D), Q58.2 (G), R41.2
unnamed: Q41.2 (B), R57.1
unnamed: Q42.1 (C), Q57.2 (G), Q58.3 (D), R42.2
unnamed: Q42.2 (B), R58.1
unnamed: Q43.1 (C), Q59.3 (D), Q60.2 (G), R43.2
unnamed: Q43.2 (B), R59.1
unnamed: Q44.1 (C), Q59.2 (G), Q60.3 (D), R44.2
unnamed: Q44.2 (B), R60.1
unnamed: Q45.1 (C), Q61.3 (D), Q62.2 (G), R45.2
unnamed: Q45.2 (B), R61.1
unnamed: Q46.1 (C), Q61.2 (G), Q62.3 (D), R46.2
unnamed: Q46.2 (B), R62.1
unnamed: Q47.1 (C), Q63.3 (D), Q64.2 (G), R47.2
unnamed: Q47.2 (B), R63.1
unnamed: Q48.1 (C), Q63.2 (G), Q64.3 (D), R48.2
unnamed: Q48.2 (B), R64.1
unnamed: Q49.1 (C), Q65.3 (D), Q66.2 (G), R49.2
unnamed: Q49.2 (B), R65.1
unnamed: Q50.1 (C), Q65.2 (G), Q66.3 (D), R50.2
unnamed: Q50.2 (B), R66.1
unnamed: Q67.2 (G), Q68.3 (D), R68.2
unnamed: Q67.3 (D), R51.2, R52.2, R53.2, R54.2, R55.2, R56.2, R57.2, R58.2, R59.2, R60.2, R61.2, R62.2, R63.2, R64.2, R65.2, R66.2, R67.2
unnamed: Q69.1 (C), Q85.3 (D), Q86.2 (G), R69.2
unnamed: Q69.2 (B), R85.1
unnamed: Q70.1 (C), Q85.2 (G), Q86.3 (D), R70.2
unnamed: Q70.2 (B), R86.1
unnamed: Q71.1 (C), Q87.3 (D), Q88.2 (G), R71.2
unnamed: Q71.2 (B), R87.1
unnamed: Q72.1 (C), Q87.2 (G), Q88.3 (D), R72.2
unnamed: Q72.2 (B), R88.1
unnamed: Q73.1 (C), Q89.3 (D), Q90.2 (G), R73.2
unnamed: Q73.2 (B), R89.1
unnamed: Q74.1 (C), Q89.2 (G), Q90.3 (D), R74.2
unnamed: Q74.2 (B), R90.1
unnamed: Q75.1 (C), Q91.3 (D), Q92.2 (G), R75.2
unnamed: Q75.2 (B), R91.1
unnamed: Q76.1 (C), Q91.2 (G), Q92.3 (D), R76.2
unnamed: Q76.2 (B), R92.1
unnamed: Q77.1 (C), Q93.3 (D), Q94.2 (G), R77.2
unnamed: Q77.2 (B), R93.1
unnamed: Q78.1 (C), Q93.2 (G), Q94.3 (D), R78.2
unnamed: Q78.2 (B), R94.1
unnamed: Q79.1 (C), Q95.3 (D), Q96.2 (G), R79.2
unnamed: Q79.2 (B), R95.1
unnamed: Q80.1 (C), Q95.2 (G), Q96.3 (D), R80.2
unnamed: Q80.2 (B), R96.1
unnamed: Q81.1 (C), Q97.3 (D), Q98.2 (G), R81.2
unnamed: Q81.2 (B), R97.1
unnamed: Q82.1 (C), Q97.2 (G), Q98.3 (D), R82.2
unnamed: Q82.2 (B), R98.1
unnamed: Q83.2 (B), R99.1
unnamed: Q84.2 (B), R100.1
unnamed: Q83.1 (C), Q99.3 (D), Q100.2 (G), R83.2
unnamed: Q84.1 (C), Q99.2 (G), Q100.3 (D), R84.2
unnamed: Q101.1 (S), Q170.1 (S), Q171.3 (D)
unnamed: Q101.2 (G), Q240.2 (G), Q281.3 (D), R274.2
unnamed: Q34.1 (S), Q68.1 (S), Q101.3 (D)
unnamed: Q102.2 (G), Q103.3 (D), R102.2
unnamed: Q102.3 (D), R85.2, R86.2, R87.2, R88.2, R89.2, R90.2, R91.2, R92.2, R93.2, R94.2, R95.2, R96.2, R97.2, R98.2, R99.2, R100.2, R101.2
unnamed: Q103.1 (S), Q137.1 (S), Q170.3 (D)
unnamed: Q34.2 (G), Q103.2 (G), Q173.2 (G), Q242.2 (G), Q280.3 (D), R273.2
unnamed: Q104.1 (C), Q120.3 (D), Q121.2 (G), R103.2
unnamed: Q104.2 (B), R119.1
unnamed: Q105.1 (C), Q120.2 (G), Q121.3 (D), R104.2
unnamed: Q105.2 (B), R120.1
unnamed: Q106.1 (C), Q122.3 (D), Q123.2 (G), R105.2
unnamed: Q106.2 (B), R121.1
unnamed: Q107.1 (C), Q122.2 (G), Q123.3 (D), R106.2
unnamed: Q107.2 (B), R122.1
unnamed: Q108.1 (C), Q124.3 (D), Q125.2 (G), R107.2
unnamed: Q108.2 (B), R123.1
unnamed: Q109.1 (C), Q124.2 (G), Q125.3 (D), R108.2
unnamed: Q109.2 (B), R124.1
unnamed: Q110.1 (C), Q126.3 (D), Q127.2 (G), R109.2
unnamed: Q110.2 (B), R125.1
unnamed: Q111.1 (C), Q126.2 (G), Q127.3 (D), R110.2
unnamed: Q111.2 (B), R126.1
unnamed: Q112.1 (C), Q128.3 (D), Q129.2 (G), R111.2
unnamed: Q112.2 (B), R127.1
unnamed: Q113.1 (C), Q128.2 (G), Q129.3 (D), R112.2
unnamed: Q113.2 (B), R128.1
unnamed: Q114.1 (C), Q130.3 (D), Q131.2 (G), R113.2
unnamed: Q114.2 (B), R129.1
unnamed: Q115.1 (C), Q130.2 (G), Q131.3 (D), R114.2
unnamed: Q115.2 (B), R130.1
unnamed: Q116.1 (C), Q132.3 (D), Q133.2 (G), R115.2
unnamed: Q116.2 (B), R131.1
unnamed: Q117.1 (C), Q132.2 (G), Q133.3 (D), R116.2
unnamed: Q117.2 (B), R132.1
unnamed: Q118.1 (C), Q134.3 (D), Q135.2 (G), R117.2
unnamed: Q118.2 (B), R133.1
unnamed: Q119.1 (C), Q134.2 (G), Q135.3 (D), R118.2
unnamed: Q119.2 (B), R134.1
unnamed: Q136.2 (G), Q137.3 (D), R136.2
unnamed: Q136.3 (D), R119.2, R120.2, R121.2, R122.2, R123.2, R124.2, R125.2, R126.2, R127.2, R128.2, R129.2, R130.2, R131.2, R132.2, R133.2, R134.2, R135.2
unnamed: Q138.1 (C), Q154.3 (D), Q155.2 (G), R137.2
unnamed: Q138.2 (B), R153.1
unnamed: Q139.1 (C), Q154.2 (G), Q155.3 (D), R138.2
unnamed: Q139.2 (B), R154.1
unnamed: Q140.1 (C), Q156.3 (D), Q157.2 (G), R139.2
unnamed: Q140.2 (B), R155.1
unnamed: Q141.1 (C), Q156.2 (G), Q157.3 (D), R140.2
unnamed: Q141.2 (B), R156.1
unnamed: Q142.1 (C), Q158.3 (D), Q159.2 (G), R141.2
unnamed: Q142.2 (B), R157.1
unnamed: Q143.1 (C), Q158.2 (G), Q159.3 (D), R142.2
unnamed: Q143.2 (B), R158.1
unnamed: Q144.1 (C), Q160.3 (D), Q161.2 (G), R143.2
unnamed: Q144.2 (B), R159.1
unnamed: Q145.1 (C), Q160.2 (G), Q161.3 (D), R144.2
unnamed: Q145.2 (B), R160.1
unnamed: Q146.1 (C), Q162.3 (D), Q163.2 (G), R145.2
unnamed: Q146.2 (B), R161.1
unnamed: Q147.1 (C), Q162.2 (G), Q163.3 (D), R146.2
unnamed: Q147.2 (B), R162.1
unnamed: Q148.1 (C), Q164.3 (D), Q165.2 (G), R147.2
unnamed: Q148.2 (B), R163.1
unnamed: Q149.1 (C), Q164.2 (G), Q165.3 (D), R148.2
unnamed: Q149.2 (B), R164.1
unnamed: Q150.1 (C), Q166.3 (D), Q167.2 (G), R149.2
unnamed: Q150.2 (B), R165.1
unnamed: Q151.1 (C), Q166.2 (G), Q167.3 (D), R150.2
unnamed: Q151.2 (B), R166.1
unnamed: Q152.1 (C), Q168.3 (D), Q169.2 (G), R151.2
unnamed: Q152.2 (B), R167.1
unnamed: Q153.1 (C), Q168.2 (G), Q169.3 (D), R152.2
unnamed: Q153.2 (B), R168.1
unnamed: Q171.1 (S), Q278.1 (S), Q279.3 (D)
unnamed: Q171.2 (G), Q282.3 (D), R275.2
unnamed: Q172.2 (G), Q173.3 (D), R170.2
unnamed: Q172.3 (D), R153.2, R154.2, R155.2, R156.2, R157.2, R158.2, R159.2, R160.2, R161.2, R162.2, R163.2, R164.2, R165.2, R166.2, R167.2, R168.2, R169.2
unnamed: Q173.1 (S), Q207.1 (S), Q240.3 (D)
unnamed: Q174.1 (C), Q190.3 (D), Q191.2 (G), R171.2
unnamed: Q174.2 (B), R187.1
unnamed: Q175.1 (C), Q190.2 (G), Q191.3 (D), R172.2
unnamed: Q175.2 (B), R188.1
unnamed: Q176.1 (C), Q192.3 (D), Q193.2 (G), R173.2
unnamed: Q176.2 (B), R189.1
unnamed: Q177.1 (C), Q192.2 (G), Q193.3 (D), R174.2
unnamed: Q177.2 (B), R190.1
unnamed: Q178.1 (C), Q194.3 (D), Q195.2 (G), R175.2
unnamed: Q178.2 (B), R191.1
unnamed: Q179.1 (C), Q194.2 (G), Q195.3 (D), R176.2
unnamed: Q179.2 (B), R192.1
unnamed: Q180.1 (C), Q196.3 (D), Q197.2 (G), R177.2
unnamed: Q180.2 (B), R193.1
unnamed: Q181.1 (C), Q196.2 (G), Q197.3 (D), R178.2
unnamed: Q181.2 (B), R194.1
unnamed: Q182.1 (C), Q198.3 (D), Q199.2 (G), R179.2
unnamed: Q182.2 (B), R195.1
unnamed: Q183.1 (C), Q198.2 (G), Q199.3 (D), R180.2
unnamed: Q183.2 (B), R196.1
unnamed: Q184.1 (C), Q200.3 (D), Q201.2 (G), R181.2
unnamed: Q184.2 (B), R197.1
unnamed: Q185.1 (C), Q200.2 (G), Q201.3 (D), R182.2
unnamed: Q185.2 (B), R198.1
unnamed: Q186.1 (C), Q202.3 (D), Q203.2 (G), R183.2
unnamed: Q186.2 (B), R199.1
unnamed: Q187.1 (C), Q202.2 (G), Q203.3 (D), R184.2
unnamed: Q187.2 (B), R200.1
unnamed: Q188.1 (C), Q204.3 (D), Q205.2 (G), R185.2
unnamed: Q188.2 (B), R201.1
unnamed: Q189.1 (C), Q204.2 (G), Q205.3 (D), R186.2
unnamed: Q189.2 (B), R202.1
unnamed: Q206.2 (G), Q207.3 (D), R204.2
unnamed: Q206.3 (D), R187.2, R188.2, R189.2, R190.2, R191.2, R192.2, R193.2, R194.2, R195.2, R196.2, R197.2, R198.2, R199.2, R200.2, R201.2, R202.2, R203.2
unnamed: Q208.1 (C), Q224.3 (D), Q225.2 (G), R205.2
unnamed: Q208.2 (B), R221.1
unnamed: Q209.1 (C), Q224.2 (G), Q225.3 (D), R206.2
unnamed: Q209.2 (B), R222.1
unnamed: Q210.1 (C), Q226.3 (D), Q227.2 (G), R207.2
unnamed: Q210.2 (B), R223.1
unnamed: Q211.1 (C), Q226.2 (G), Q227.3 (D), R208.2
unnamed: Q211.2 (B), R224.1
unnamed: Q212.1 (C), Q228.3 (D), Q229.2 (G), R209.2
unnamed: Q212.2 (B), R225.1
unnamed: Q213.1 (C), Q228.2 (G), Q229.3 (D), R210.2
unnamed: Q213.2 (B), R226.1
unnamed: Q214.1 (C), Q230.3 (D), Q231.2 (G), R211.2
unnamed: Q214.2 (B), R227.1
unnamed: Q215.1 (C), Q230.2 (G), Q231.3 (D), R212.2
unnamed: Q215.2 (B), R228.1
unnamed: Q216.1 (C), Q232.3 (D), Q233.2 (G), R213.2
unnamed: Q216.2 (B), R229.1
unnamed: Q217.1 (C), Q232.2 (G), Q233.3 (D), R214.2
unnamed: Q217.2 (B), R230.1
unnamed: Q218.1 (C), Q234.3 (D), Q235.2 (G), R215.2
unnamed: Q218.2 (B), R231.1
unnamed: Q219.1 (C), Q234.2 (G), Q235.3 (D), R216.2
unnamed: Q219.2 (B), R232.1
unnamed: Q220.1 (C), Q236.3 (D), Q237.2 (G), R217.2
unnamed: Q220.2 (B), R233.1
unnamed: Q221.1 (C), Q236.2 (G), Q237.3 (D), R218.2
unnamed: Q221.2 (B), R234.1
unnamed: Q222.1 (C), Q238.3 (D), Q239.2 (G), R219.2
unnamed: Q222.2 (B), R235.1
unnamed: Q223.1 (C), Q238.2 (G), Q239.3 (D), R220.2
unnamed: Q223.2 (B), R236.1
unnamed: Q240.1 (S), Q277.1 (S), Q278.3 (D)
unnamed: Q241.2 (G), Q242.3 (D), R238.2
unnamed: Q241.3 (D), R221.2, R222.2, R223.2, R224.2, R225.2, R226.2, R227.2, R228.2, R229.2, R230.2, R231.2, R232.2, R233.2, R234.2, R235.2, R236.2, R237.2
unnamed: Q242.1 (S), Q276.1 (S), Q277.3 (D)
unnamed: Q243.1 (C), Q259.3 (D), Q260.2 (G), R239.2
unnamed: Q243.2 (B), R255.1
unnamed: Q244.1 (C), Q259.2 (G), Q260.3 (D), R240.2
unnamed: Q244.2 (B), R256.1
unnamed: Q245.1 (C), Q261.3 (D), Q262.2 (G), R241.2
unnamed: Q245.2 (B), R257.1
unnamed: Q246.1 (C), Q261.2 (G), Q262.3 (D), R242.2
unnamed: Q246.2 (B), R258.1
unnamed: Q247.1 (C), Q263.3 (D), Q264.2 (G), R243.2
unnamed: Q247.2 (B), R259.1
unnamed: Q248.1 (C), Q263.2 (G), Q264.3 (D), R244.2
unnamed: Q248.2 (B), R260.1
unnamed: Q249.1 (C), Q265.3 (D), Q266.2 (G), R245.2
unnamed: Q249.2 (B), R261.1
unnamed: Q250.1 (C), Q265.2 (G), Q266.3 (D), R246.2
unnamed: Q250.2 (B), R262.1
unnamed: Q251.1 (C), Q267.3 (D), Q268.2 (G), R247.2
unnamed: Q251.2 (B), R263.1
unnamed: Q252.1 (C), Q267.2 (G), Q268.3 (D), R248.2
unnamed: Q252.2 (B), R264.1
unnamed: Q253.1 (C), Q269.3 (D), Q270.2 (G), R249.2
unnamed: Q253.2 (B), R265.1
unnamed: Q254.1 (C), Q269.2 (G), Q270.3 (D), R250.2
unnamed: Q254.2 (B), R266.1
unnamed: Q255.1 (C), Q271.3 (D), Q272.2 (G), R251.2
unnamed: Q255.2 (B), R267.1
unnamed: Q256.1 (C), Q271.2 (G), Q272.3 (D), R252.2
unnamed: Q256.2 (B), R268.1
unnamed: Q257.1 (C), Q273.3 (D), Q274.2 (G), R253.2
unnamed: Q257.2 (B), R269.1
unnamed: Q258.1 (C), Q273.2 (G), Q274.3 (D), R254.2
unnamed: Q258.2 (B), R270.1
unnamed: Q275.2 (G), Q276.3 (D), R272.2
unnamed: Q275.3 (D), R255.2, R256.2, R257.2, R258.2, R259.2, R260.2, R261.2, R262.2, R263.2, R264.2, R265.2, R266.2, R267.2, R268.2, R269.2, R270.2, R271.2
VCC: J1.1, J1.2, R1.1, R2.1, R3.1, R4.1, R5.1, R6.1, R7.1, R8.1, R9.1, R10.1, R11.1, R12.1, R13.1, R14.1, R15.1, R16.1, R33.1, R34.1, R35.1, R36.1, R37.1, R38.1, R39.1, R40.1, R41.1, R42.1, R43.1, R44.1, R45.1, R46.1, R47.1, R48.1, R49.1, R50.1, R67.1, R68.1, R69.1, R70.1, R71.1, R72.1, R73.1, R74.1, R75.1, R76.1, R77.1, R78.1, R79.1, R80.1, R81.1, R82.1, R83.1, R84.1, R101.1, R102.1, R103.1, R104.1, R105.1, R106.1, R107.1, R108.1, R109.1, R110.1, R111.1, R112.1, R113.1, R114.1, R115.1, R116.1, R117.1, R118.1, R135.1, R136.1, R137.1, R138.1, R139.1, R140.1, R141.1, R142.1, R143.1, R144.1, R145.1, R146.1, R147.1, R148.1, R149.1, R150.1, R151.1, R152.1, R169.1, R170.1, R171.1, R172.1, R173.1, R174.1, R175.1, R176.1, R177.1, R178.1, R179.1, R180.1, R181.1, R182.1, R183.1, R184.1, R185.1, R186.1, R203.1, R204.1, R205.1, R206.1, R207.1, R208.1, R209.1, R210.1, R211.1, R212.1, R213.1, R214.1, R215.1, R216.1, R217.1, R218.1, R219.1, R220.1, R237.1, R238.1, R239.1, R240.1, R241.1, R242.1, R243.1, R244.1, R245.1, R246.1, R247.1, R248.1, R249.1, R250.1, R251.1, R252.1, R253.1, R254.1, R271.1, R272.1, R273.1, R274.1, R275.1

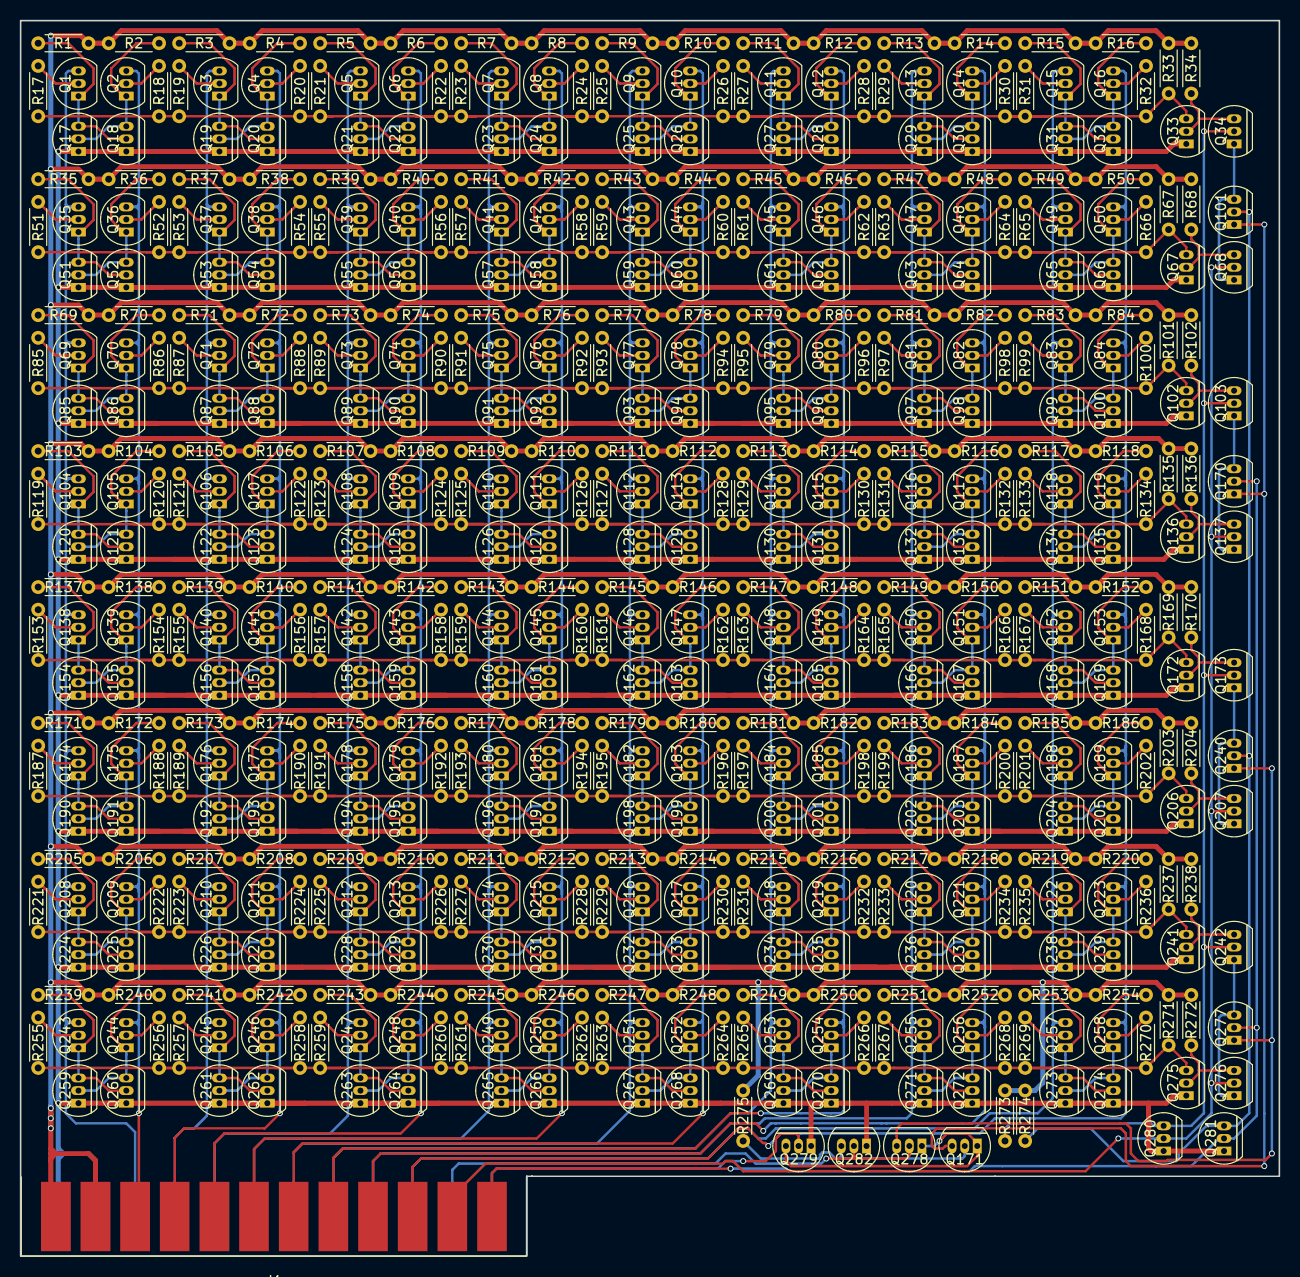
[picture p35: board ram.kicad_pcb from above]

Board: 2 copper layers, 127.0 x 124.6 mm, 558 parts (0 on the bottom side), 304 nets.
