davidv1992/Trans1/designs/memory/eprom/eprom.kicad_pcb

## KiCad design designs/memory/eprom/eprom.kicad_pcb (2025-08-03)

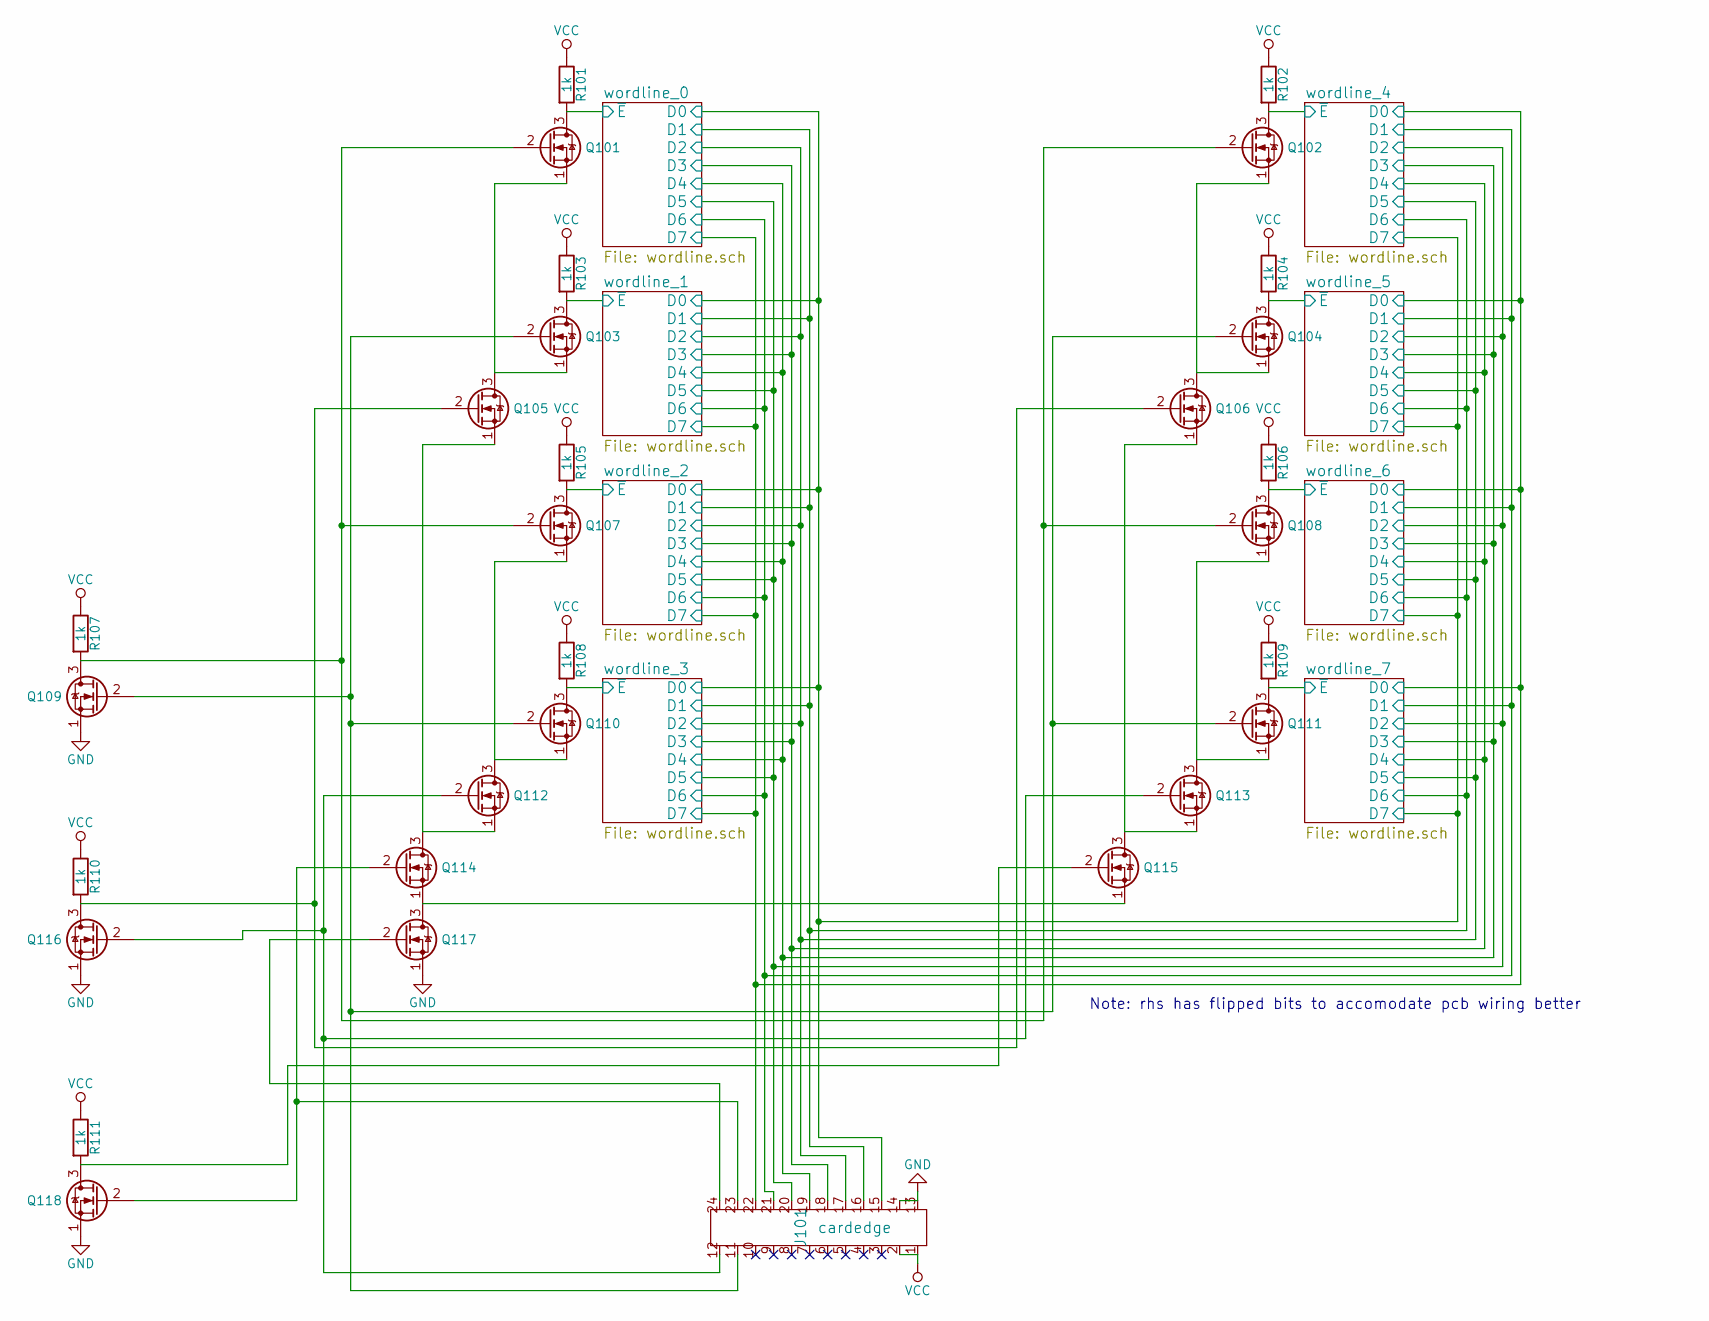
[picture p36: schematic eprom.sch]

Parts:
J101: cardedge; cardedge_12p
Q101, Q102, Q103, Q104, Q105, Q106, Q107, Q108, Q109, Q110, Q111, Q112, Q113, Q114, Q115, Q116, Q117, Q118: 2N7000; TO-92-FET
R101, R102, R103, R104, R105, R106, R107, R108, R109, R110, R111: 1k; R_small

Connections:
/wordline_0/D0: J101.15; also elsewhere on the board
/wordline_0/D1: J101.16; also elsewhere on the board
/wordline_0/D2: J101.17; also elsewhere on the board
/wordline_0/D3: J101.18; also elsewhere on the board
/wordline_0/~E: Q101.3 (D), R101.2; also elsewhere on the board
/wordline_1/~E: Q103.3 (D), R103.2; also elsewhere on the board
/wordline_2/~E: Q107.3 (D), R105.2; also elsewhere on the board
/wordline_3/~E: Q110.3 (D), R108.2; also elsewhere on the board
/wordline_4/D0: J101.22; also elsewhere on the board
/wordline_4/D1: J101.21; also elsewhere on the board
/wordline_4/D2: J101.20; also elsewhere on the board
/wordline_4/D3: J101.19; also elsewhere on the board
/wordline_4/~E: Q102.3 (D), R102.2; also elsewhere on the board
/wordline_5/~E: Q104.3 (D), R104.2; also elsewhere on the board
/wordline_6/~E: Q108.3 (D), R106.2; also elsewhere on the board
/wordline_7/~E: Q111.3 (D), R109.2; also elsewhere on the board
GND: J101.13, J101.14, Q109.1 (S), Q116.1 (S), Q117.1 (S), Q118.1 (S); also elsewhere on the board
unnamed: J101.11, Q103.2 (G), Q104.2 (G), Q109.2 (G), Q110.2 (G), Q111.2 (G)
unnamed: J101.12, Q112.2 (G), Q113.2 (G), Q116.2 (G)
unnamed: J101.23, Q114.2 (G), Q118.2 (G)
unnamed: J101.24, Q117.2 (G)
unnamed: Q101.1 (S), Q103.1 (S), Q105.3 (D)
unnamed: Q101.2 (G), Q102.2 (G), Q107.2 (G), Q108.2 (G), Q109.3 (D), R107.2
unnamed: Q102.1 (S), Q104.1 (S), Q106.3 (D)
unnamed: Q105.1 (S), Q112.1 (S), Q114.3 (D)
unnamed: Q105.2 (G), Q106.2 (G), Q116.3 (D), R110.2
unnamed: Q106.1 (S), Q113.1 (S), Q115.3 (D)
unnamed: Q107.1 (S), Q110.1 (S), Q112.3 (D)
unnamed: Q108.1 (S), Q111.1 (S), Q113.3 (D)
unnamed: Q114.1 (S), Q115.1 (S), Q117.3 (D)
unnamed: Q115.2 (G), Q118.3 (D), R111.2
VCC: J101.1, J101.2, R101.1, R102.1, R103.1, R104.1, R105.1, R106.1, R107.1, R108.1, R109.1, R110.1, R111.1; also elsewhere on the board

Notes on the sheet:
Note: rhs has flipped bits to accomodate pcb wiring better
