davidv1992/Trans1/designs/memory/eprom/eprom.kicad_pcb

## KiCad design designs/memory/eprom/eprom.kicad_pcb (continued)

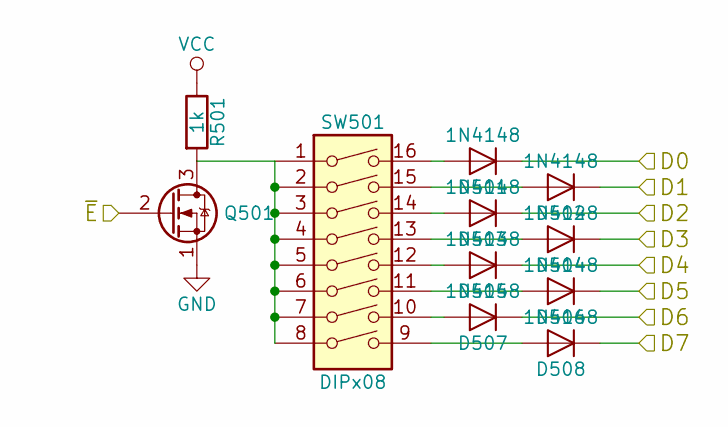
[picture p37: schematic wordline.sch]

Parts:
D201, D202, D203, D204, D205, D206, D207, D208: 1N4148; D_default
Q201: 2N7000; TO-92-FET
R201: 1k; R_small
SW201: DIPx08; DIPx8

Connections:
/wordline_0/D0: D201.1 (K); also elsewhere on the board
/wordline_0/D1: D202.1 (K); also elsewhere on the board
/wordline_0/D2: D203.1 (K); also elsewhere on the board
/wordline_0/D3: D204.1 (K); also elsewhere on the board
/wordline_0/~E: Q201.2 (G); also elsewhere on the board
/wordline_4/D0: D208.1 (K); also elsewhere on the board
/wordline_4/D1: D207.1 (K); also elsewhere on the board
/wordline_4/D2: D206.1 (K); also elsewhere on the board
/wordline_4/D3: D205.1 (K); also elsewhere on the board
GND: Q201.1 (S); also elsewhere on the board
unnamed: D201.2 (A), SW201.16
unnamed: D202.2 (A), SW201.15
unnamed: D203.2 (A), SW201.14
unnamed: D204.2 (A), SW201.13
unnamed: D205.2 (A), SW201.12
unnamed: D206.2 (A), SW201.11
unnamed: D207.2 (A), SW201.10
unnamed: D208.2 (A), SW201.9
unnamed: Q201.3 (D), R201.2, SW201.1, SW201.2, SW201.3, SW201.4, SW201.5, SW201.6, SW201.7, SW201.8
VCC: R201.1; also elsewhere on the board

Parts of its further copies:
D301, D302, D303, D304, D305, D306, D307, D308, D401, D402, D403, D404, D405, D406, D407, D408, D501, D502, D503, D504, D505, D506, D507, D508, D601, D602, D603, D604, D605, D606, D607, D608, D701, D702, D703, D704, D705, D706, D707, D708, D801, D802, D803, D804, D805, D806, D807, D808, D901, D902, D903, D904, D905, D906, D907, D908: 1N4148; D_default
Q301, Q401, Q501, Q601, Q701, Q801, Q901: 2N7000; TO-92-FET
R301, R401, R501, R601, R701, R801, R901: 1k; R_small
SW301, SW401, SW501, SW601, SW701, SW801, SW901: DIPx08; DIPx8

Connections of its further copies:
/wordline_0/D0: D301.1 (K), D401.1 (K), D501.1 (K), D608.1 (K), D708.1 (K), D808.1 (K), D908.1 (K); also elsewhere on the board
/wordline_0/D1: D302.1 (K), D402.1 (K), D502.1 (K), D607.1 (K), D707.1 (K), D807.1 (K), D907.1 (K); also elsewhere on the board
/wordline_0/D2: D303.1 (K), D403.1 (K), D503.1 (K), D606.1 (K), D706.1 (K), D806.1 (K), D906.1 (K); also elsewhere on the board
/wordline_0/D3: D304.1 (K), D404.1 (K), D504.1 (K), D605.1 (K), D705.1 (K), D805.1 (K), D905.1 (K); also elsewhere on the board
/wordline_1/~E: Q301.2 (G); also elsewhere on the board
/wordline_2/~E: Q401.2 (G); also elsewhere on the board
/wordline_3/~E: Q501.2 (G); also elsewhere on the board
/wordline_4/D0: D308.1 (K), D408.1 (K), D508.1 (K), D601.1 (K), D701.1 (K), D801.1 (K), D901.1 (K); also elsewhere on the board
/wordline_4/D1: D307.1 (K), D407.1 (K), D507.1 (K), D602.1 (K), D702.1 (K), D802.1 (K), D902.1 (K); also elsewhere on the board
/wordline_4/D2: D306.1 (K), D406.1 (K), D506.1 (K), D603.1 (K), D703.1 (K), D803.1 (K), D903.1 (K); also elsewhere on the board
/wordline_4/D3: D305.1 (K), D405.1 (K), D505.1 (K), D604.1 (K), D704.1 (K), D804.1 (K), D904.1 (K); also elsewhere on the board
/wordline_4/~E: Q601.2 (G); also elsewhere on the board
/wordline_5/~E: Q701.2 (G); also elsewhere on the board
/wordline_6/~E: Q801.2 (G); also elsewhere on the board
/wordline_7/~E: Q901.2 (G); also elsewhere on the board
GND: Q301.1 (S), Q401.1 (S), Q501.1 (S), Q601.1 (S), Q701.1 (S), Q801.1 (S), Q901.1 (S); also elsewhere on the board
unnamed: D301.2 (A), SW301.16
unnamed: D302.2 (A), SW301.15
unnamed: D303.2 (A), SW301.14
unnamed: D304.2 (A), SW301.13
unnamed: D305.2 (A), SW301.12
unnamed: D306.2 (A), SW301.11
unnamed: D307.2 (A), SW301.10
unnamed: D308.2 (A), SW301.9
unnamed: D401.2 (A), SW401.16
unnamed: D402.2 (A), SW401.15
unnamed: D403.2 (A), SW401.14
unnamed: D404.2 (A), SW401.13
unnamed: D405.2 (A), SW401.12
unnamed: D406.2 (A), SW401.11
unnamed: D407.2 (A), SW401.10
unnamed: D408.2 (A), SW401.9
unnamed: D501.2 (A), SW501.16
unnamed: D502.2 (A), SW501.15
unnamed: D503.2 (A), SW501.14
unnamed: D504.2 (A), SW501.13
unnamed: D505.2 (A), SW501.12
unnamed: D506.2 (A), SW501.11
unnamed: D507.2 (A), SW501.10
unnamed: D508.2 (A), SW501.9
unnamed: D601.2 (A), SW601.16
unnamed: D602.2 (A), SW601.15
unnamed: D603.2 (A), SW601.14
unnamed: D604.2 (A), SW601.13
unnamed: D605.2 (A), SW601.12
unnamed: D606.2 (A), SW601.11
unnamed: D607.2 (A), SW601.10
unnamed: D608.2 (A), SW601.9
unnamed: D701.2 (A), SW701.16
unnamed: D702.2 (A), SW701.15
unnamed: D703.2 (A), SW701.14
unnamed: D704.2 (A), SW701.13
unnamed: D705.2 (A), SW701.12
unnamed: D706.2 (A), SW701.11
unnamed: D707.2 (A), SW701.10
unnamed: D708.2 (A), SW701.9
unnamed: D801.2 (A), SW801.16
unnamed: D802.2 (A), SW801.15
unnamed: D803.2 (A), SW801.14
unnamed: D804.2 (A), SW801.13
unnamed: D805.2 (A), SW801.12
unnamed: D806.2 (A), SW801.11
unnamed: D807.2 (A), SW801.10
unnamed: D808.2 (A), SW801.9
unnamed: D901.2 (A), SW901.16
unnamed: D902.2 (A), SW901.15
unnamed: D903.2 (A), SW901.14
unnamed: D904.2 (A), SW901.13
unnamed: D905.2 (A), SW901.12
unnamed: D906.2 (A), SW901.11
unnamed: D907.2 (A), SW901.10
unnamed: D908.2 (A), SW901.9
unnamed: Q301.3 (D), R301.2, SW301.1, SW301.2, SW301.3, SW301.4, SW301.5, SW301.6, SW301.7, SW301.8
unnamed: Q401.3 (D), R401.2, SW401.1, SW401.2, SW401.3, SW401.4, SW401.5, SW401.6, SW401.7, SW401.8
unnamed: Q501.3 (D), R501.2, SW501.1, SW501.2, SW501.3, SW501.4, SW501.5, SW501.6, SW501.7, SW501.8
unnamed: Q601.3 (D), R601.2, SW601.1, SW601.2, SW601.3, SW601.4, SW601.5, SW601.6, SW601.7, SW601.8
unnamed: Q701.3 (D), R701.2, SW701.1, SW701.2, SW701.3, SW701.4, SW701.5, SW701.6, SW701.7, SW701.8
unnamed: Q801.3 (D), R801.2, SW801.1, SW801.2, SW801.3, SW801.4, SW801.5, SW801.6, SW801.7, SW801.8
unnamed: Q901.3 (D), R901.2, SW901.1, SW901.2, SW901.3, SW901.4, SW901.5, SW901.6, SW901.7, SW901.8
VCC: R301.1, R401.1, R501.1, R601.1, R701.1, R801.1, R901.1; also elsewhere on the board

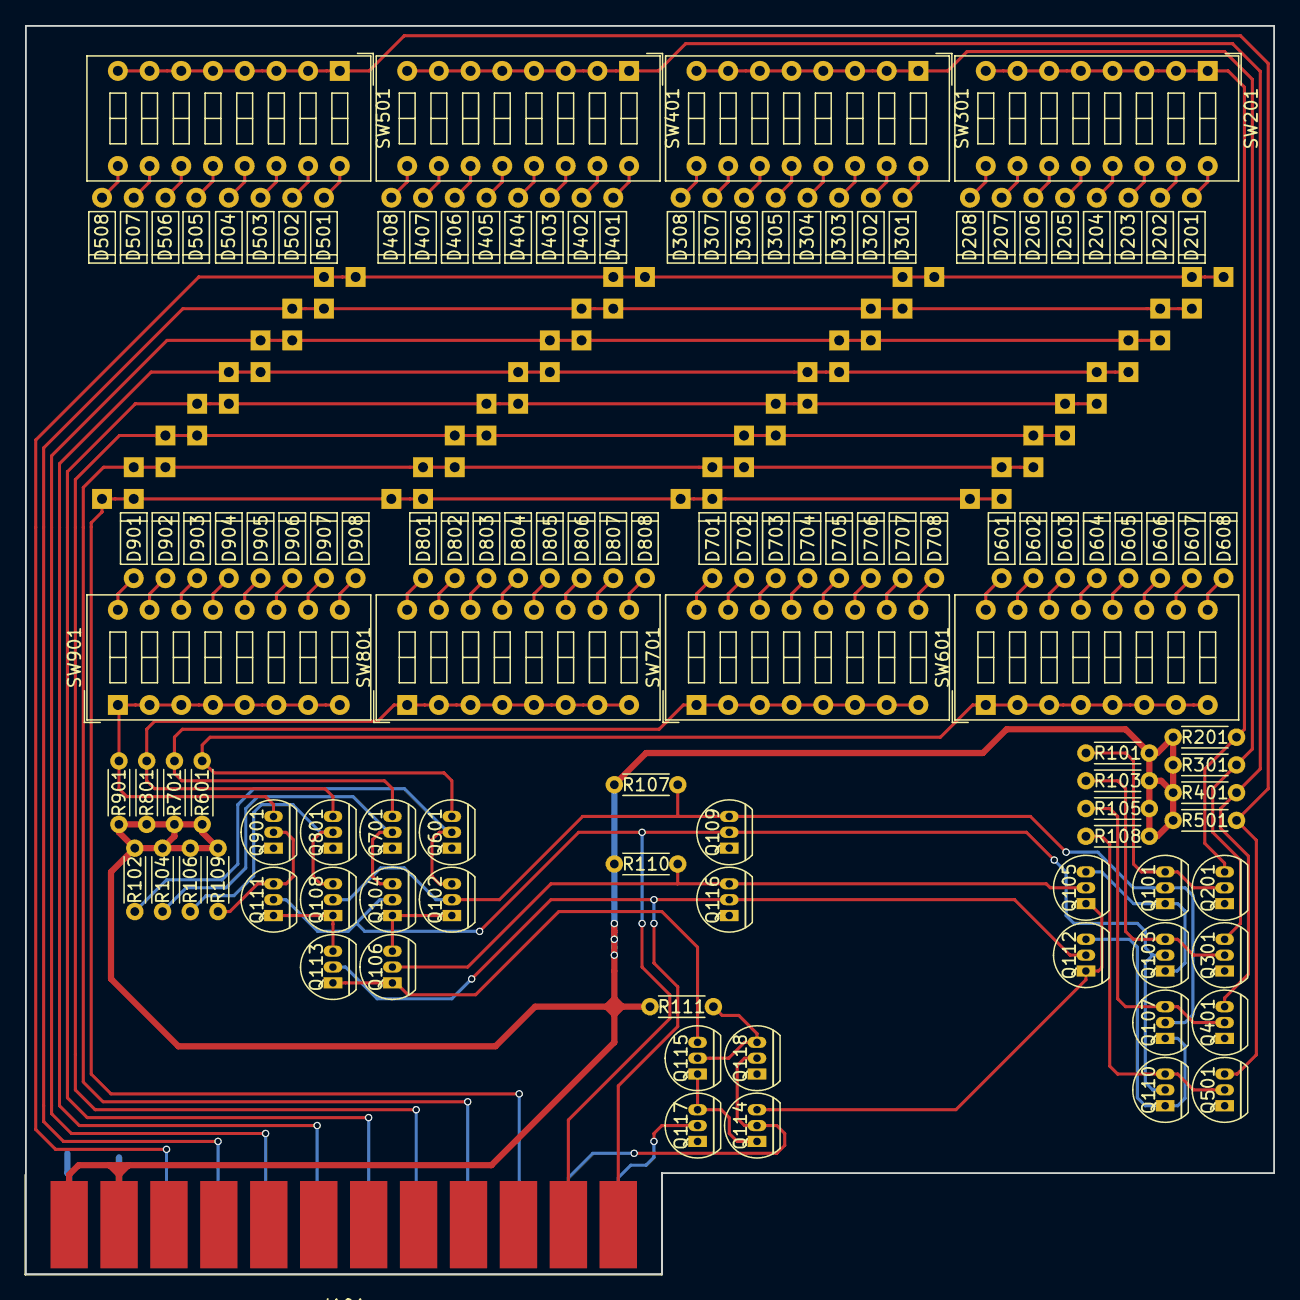
[picture p38: board eprom.kicad_pcb from above]

Board: 2 copper layers, 100.0 x 100.0 mm, 118 parts (0 on the bottom side), 104 nets.
