davidv1992/Trans1/designs/memory/controller/controller.kicad_pcb

## KiCad design designs/memory/controller/controller.kicad_pcb (2025-08-03)

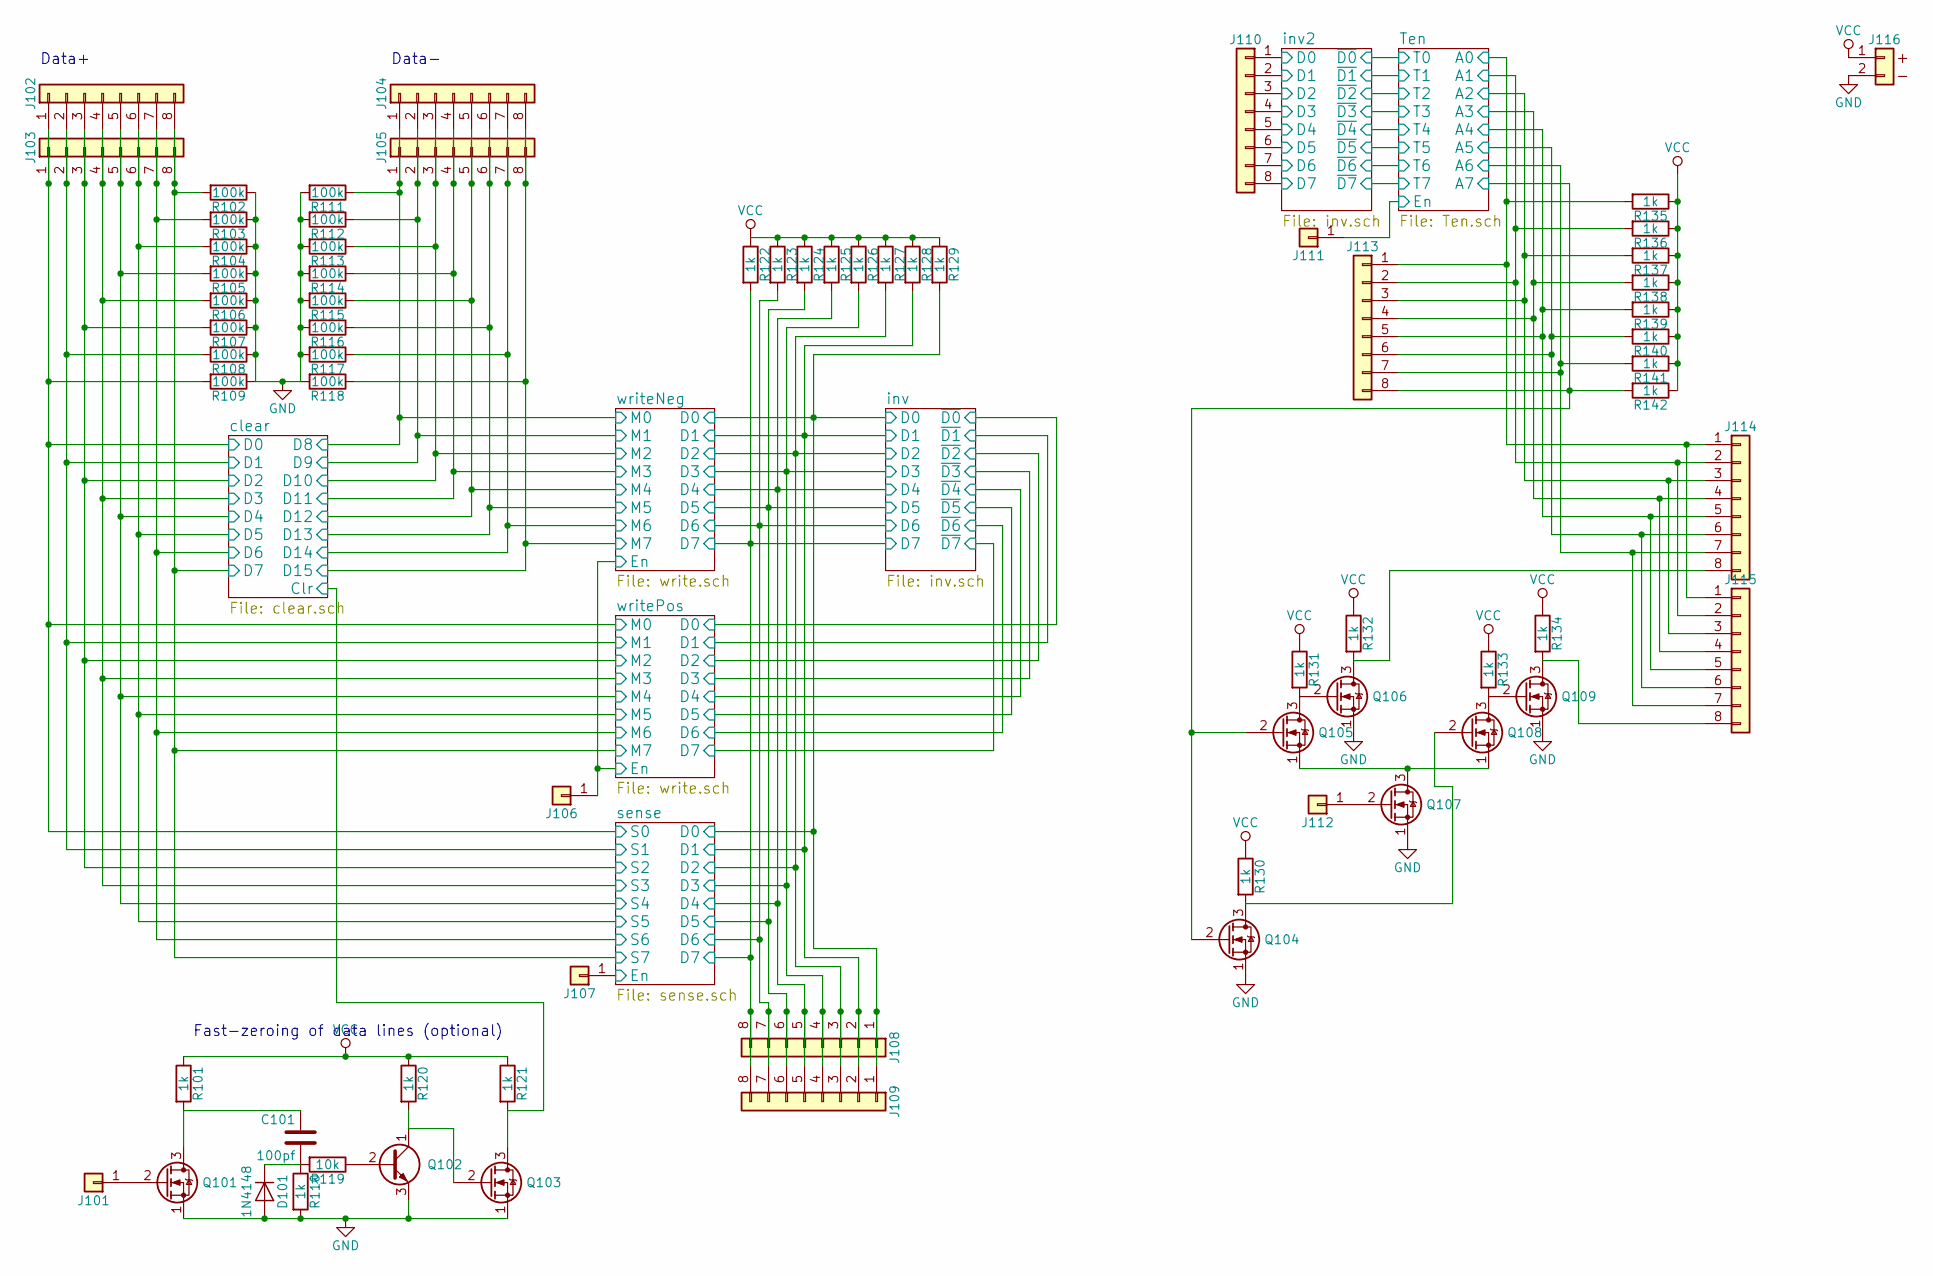
[picture p39: schematic controller.sch]

Parts:
C101: 100pf; C_default
D101: 1N4148; D_default
J101, J106, J107, J111, J112: Conn_01x01; PH_1x1
J102, J103, J104, J105, J108, J109, J110, J113, J114, J115: Conn_01x08; PH_1x8
J116: Conn_01x02_Power; PH_1x2
Q101, Q103, Q104, Q105, Q106, Q107, Q108, Q109: 2N7000; TO-92-FET
Q102: BC547; TO-92-BJT
R101, R110, R120, R121, R122, R123, R124, R125, R126, R127, R128, R129, R130, R131, R132, R133, R134, R135, R136, R137, R138, R139, R140, R141, R142: 1k; R_small
R102, R103, R104, R105, R106, R107, R108, R109, R111, R112, R113, R114, R115, R116, R117, R118: 100k; R_small
R119: 10k; R_small

Connections:
/Ten/A0: J113.1, J114.1, J115.1, R135.2; also elsewhere on the board
/Ten/A1: J113.2, J114.2, J115.2, R136.2; also elsewhere on the board
/Ten/A2: J113.3, J114.3, J115.3, R137.2; also elsewhere on the board
/Ten/A3: J113.4, J114.4, J115.4, R138.2; also elsewhere on the board
/Ten/A4: J113.5, J114.5, J115.5, R139.2; also elsewhere on the board
/Ten/A5: J113.6, J114.6, J115.6, R140.2; also elsewhere on the board
/Ten/A6: J113.7, J114.7, J115.7, R141.2; also elsewhere on the board
/Ten/A7: J113.8, Q104.2 (G), Q105.2 (G), R142.2; also elsewhere on the board
/Ten/En: J111.1; also elsewhere on the board
/clear/Clr: Q103.3 (D), R121.2; also elsewhere on the board
/clear/D0: J102.1, J103.1, R109.2; also elsewhere on the board
/clear/D1: J102.2, J103.2, R108.2; also elsewhere on the board
/clear/D2: J102.3, J103.3, R107.2; also elsewhere on the board
/clear/D3: J102.4, J103.4, R106.2; also elsewhere on the board
/clear/D4: J102.5, J103.5, R105.2; also elsewhere on the board
/clear/D5: J102.6, J103.6, R104.2; also elsewhere on the board
/clear/D6: J102.7, J103.7, R103.2; also elsewhere on the board
/clear/D7: J102.8, J103.8, R102.2; also elsewhere on the board
/clear/D8: J104.1, J105.1, R111.1; also elsewhere on the board
/clear/D9: J104.2, J105.2, R112.1; also elsewhere on the board
/clear/D10: J104.3, J105.3, R113.1; also elsewhere on the board
/clear/D11: J104.4, J105.4, R114.1; also elsewhere on the board
/clear/D12: J104.5, J105.5, R115.1; also elsewhere on the board
/clear/D13: J104.6, J105.6, R116.1; also elsewhere on the board
/clear/D14: J104.7, J105.7, R117.1; also elsewhere on the board
/clear/D15: J104.8, J105.8, R118.1; also elsewhere on the board
/inv2/D0: J110.1; also elsewhere on the board
/inv2/D1: J110.2; also elsewhere on the board
/inv2/D2: J110.3; also elsewhere on the board
/inv2/D3: J110.4; also elsewhere on the board
/inv2/D4: J110.5; also elsewhere on the board
/inv2/D5: J110.6; also elsewhere on the board
/inv2/D6: J110.7; also elsewhere on the board
/inv2/D7: J110.8; also elsewhere on the board
/inv/D0: J108.1, J109.1, R129.2; also elsewhere on the board
/inv/D1: J108.2, J109.2, R128.2; also elsewhere on the board
/inv/D2: J108.3, J109.3, R127.2; also elsewhere on the board
/inv/D3: J108.4, J109.4, R126.2; also elsewhere on the board
/inv/D4: J108.5, J109.5, R125.2; also elsewhere on the board
/inv/D5: J108.6, J109.6, R124.2; also elsewhere on the board
/inv/D6: J108.7, J109.7, R123.2; also elsewhere on the board
/inv/D7: J108.8, J109.8, R122.2; also elsewhere on the board
/sense/En: J107.1; also elsewhere on the board
/writeNeg/En: J106.1; also elsewhere on the board
GND: D101.2 (A), J116.2, Q101.1 (S), Q102.3 (E), Q103.1 (S), Q104.1 (S), Q106.1 (S), Q107.1 (S), Q109.1 (S), R102.1, R103.1, R104.1, R105.1, R106.1, R107.1, R108.1, R109.1, R110.2, R111.2, R112.2, R113.2, R114.2, R115.2, R116.2, R117.2, R118.2; also elsewhere on the board
unnamed: C101.1, Q101.3 (D), R101.2
unnamed: C101.2, D101.1 (K), R110.1, R119.2
unnamed: J101.1, Q101.2 (G)
unnamed: J112.1, Q107.2 (G)
unnamed: J114.8, Q106.3 (D), R132.2
unnamed: J115.8, Q109.3 (D), R134.2
unnamed: Q102.1 (C), Q103.2 (G), R120.2
unnamed: Q102.2 (B), R119.1
unnamed: Q104.3 (D), Q108.2 (G), R130.2
unnamed: Q105.1 (S), Q107.3 (D), Q108.1 (S)
unnamed: Q105.3 (D), Q106.2 (G), R131.2
unnamed: Q108.3 (D), Q109.2 (G), R133.2
VCC: J116.1, R101.1, R120.1, R121.1, R122.1, R123.1, R124.1, R125.1, R126.1, R127.1, R128.1, R129.1, R130.1, R131.1, R132.1, R133.1, R134.1, R135.1, R136.1, R137.1, R138.1, R139.1, R140.1, R141.1, R142.1; also elsewhere on the board

Notes on the sheet:
Data+
Data-
Fast-zeroing of data lines (optional)

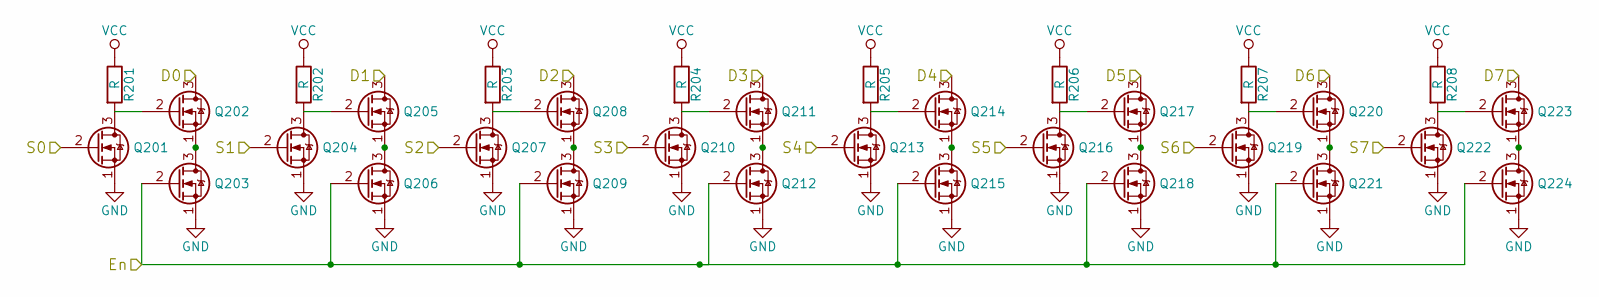
[picture p40: schematic sense.sch]

Parts:
Q201, Q202, Q203, Q204, Q205, Q206, Q207, Q208, Q209, Q210, Q211, Q212, Q213, Q214, Q215, Q216, Q217, Q218, Q219, Q220, Q221, Q222, Q223, Q224: 2N7000; TO-92-FET
R201, R202, R203, R204, R205, R206, R207, R208: R; R_small

Connections:
/clear/D0: Q201.2 (G); also elsewhere on the board
/clear/D1: Q204.2 (G); also elsewhere on the board
/clear/D2: Q207.2 (G); also elsewhere on the board
/clear/D3: Q210.2 (G); also elsewhere on the board
/clear/D4: Q213.2 (G); also elsewhere on the board
/clear/D5: Q216.2 (G); also elsewhere on the board
/clear/D6: Q219.2 (G); also elsewhere on the board
/clear/D7: Q222.2 (G); also elsewhere on the board
/inv/D0: Q202.3 (D); also elsewhere on the board
/inv/D1: Q205.3 (D); also elsewhere on the board
/inv/D2: Q208.3 (D); also elsewhere on the board
/inv/D3: Q211.3 (D); also elsewhere on the board
/inv/D4: Q214.3 (D); also elsewhere on the board
/inv/D5: Q217.3 (D); also elsewhere on the board
/inv/D6: Q220.3 (D); also elsewhere on the board
/inv/D7: Q223.3 (D); also elsewhere on the board
/sense/En: Q203.2 (G), Q206.2 (G), Q209.2 (G), Q212.2 (G), Q215.2 (G), Q218.2 (G), Q221.2 (G), Q224.2 (G); also elsewhere on the board
GND: Q201.1 (S), Q203.1 (S), Q204.1 (S), Q206.1 (S), Q207.1 (S), Q209.1 (S), Q210.1 (S), Q212.1 (S), Q213.1 (S), Q215.1 (S), Q216.1 (S), Q218.1 (S), Q219.1 (S), Q221.1 (S), Q222.1 (S), Q224.1 (S); also elsewhere on the board
unnamed: Q201.3 (D), Q202.2 (G), R201.2
unnamed: Q202.1 (S), Q203.3 (D)
unnamed: Q204.3 (D), Q205.2 (G), R202.2
unnamed: Q205.1 (S), Q206.3 (D)
unnamed: Q207.3 (D), Q208.2 (G), R203.2
unnamed: Q208.1 (S), Q209.3 (D)
unnamed: Q210.3 (D), Q211.2 (G), R204.2
unnamed: Q211.1 (S), Q212.3 (D)
unnamed: Q213.3 (D), Q214.2 (G), R205.2
unnamed: Q214.1 (S), Q215.3 (D)
unnamed: Q216.3 (D), Q217.2 (G), R206.2
unnamed: Q217.1 (S), Q218.3 (D)
unnamed: Q219.3 (D), Q220.2 (G), R207.2
unnamed: Q220.1 (S), Q221.3 (D)
unnamed: Q222.3 (D), Q223.2 (G), R208.2
unnamed: Q223.1 (S), Q224.3 (D)
VCC: R201.1, R202.1, R203.1, R204.1, R205.1, R206.1, R207.1, R208.1; also elsewhere on the board

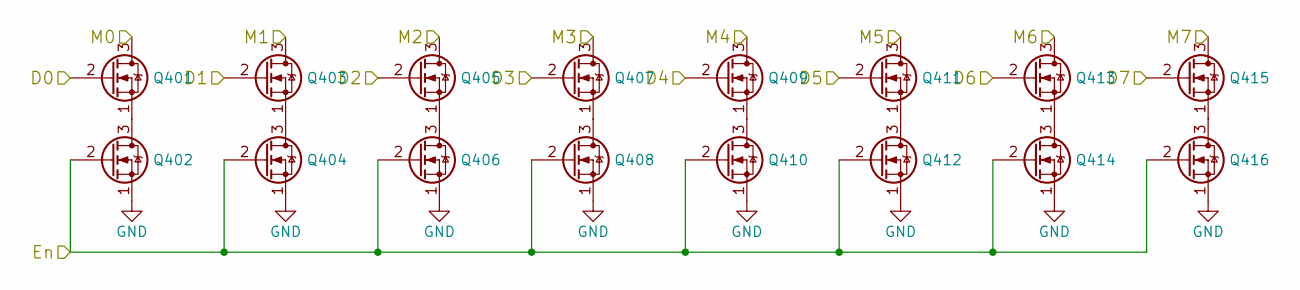
[picture p41: schematic write.sch]

Parts:
Q301, Q302, Q303, Q304, Q305, Q306, Q307, Q308, Q309, Q310, Q311, Q312, Q313, Q314, Q315, Q316: 2N7000; TO-92-FET

Connections:
/clear/D8: Q301.3 (D); also elsewhere on the board
/clear/D9: Q303.3 (D); also elsewhere on the board
/clear/D10: Q305.3 (D); also elsewhere on the board
/clear/D11: Q307.3 (D); also elsewhere on the board
/clear/D12: Q309.3 (D); also elsewhere on the board
/clear/D13: Q311.3 (D); also elsewhere on the board
/clear/D14: Q313.3 (D); also elsewhere on the board
/clear/D15: Q315.3 (D); also elsewhere on the board
/inv/D0: Q301.2 (G); also elsewhere on the board
/inv/D1: Q303.2 (G); also elsewhere on the board
/inv/D2: Q305.2 (G); also elsewhere on the board
/inv/D3: Q307.2 (G); also elsewhere on the board
/inv/D4: Q309.2 (G); also elsewhere on the board
/inv/D5: Q311.2 (G); also elsewhere on the board
/inv/D6: Q313.2 (G); also elsewhere on the board
/inv/D7: Q315.2 (G); also elsewhere on the board
/writeNeg/En: Q302.2 (G), Q304.2 (G), Q306.2 (G), Q308.2 (G), Q310.2 (G), Q312.2 (G), Q314.2 (G), Q316.2 (G); also elsewhere on the board
GND: Q302.1 (S), Q304.1 (S), Q306.1 (S), Q308.1 (S), Q310.1 (S), Q312.1 (S), Q314.1 (S), Q316.1 (S); also elsewhere on the board
unnamed: Q301.1 (S), Q302.3 (D)
unnamed: Q303.1 (S), Q304.3 (D)
unnamed: Q305.1 (S), Q306.3 (D)
unnamed: Q307.1 (S), Q308.3 (D)
unnamed: Q309.1 (S), Q310.3 (D)
unnamed: Q311.1 (S), Q312.3 (D)
unnamed: Q313.1 (S), Q314.3 (D)
unnamed: Q315.1 (S), Q316.3 (D)

Parts of its further copies:
Q401, Q402, Q403, Q404, Q405, Q406, Q407, Q408, Q409, Q410, Q411, Q412, Q413, Q414, Q415, Q416: 2N7000; TO-92-FET

Connections of its further copies:
/clear/D0: Q401.3 (D); also elsewhere on the board
/clear/D1: Q403.3 (D); also elsewhere on the board
/clear/D2: Q405.3 (D); also elsewhere on the board
/clear/D3: Q407.3 (D); also elsewhere on the board
/clear/D4: Q409.3 (D); also elsewhere on the board
/clear/D5: Q411.3 (D); also elsewhere on the board
/clear/D6: Q413.3 (D); also elsewhere on the board
/clear/D7: Q415.3 (D); also elsewhere on the board
/writeNeg/En: Q402.2 (G), Q404.2 (G), Q406.2 (G), Q408.2 (G), Q410.2 (G), Q412.2 (G), Q414.2 (G), Q416.2 (G); also elsewhere on the board
/writePos/D0: Q401.2 (G); also elsewhere on the board
/writePos/D1: Q403.2 (G); also elsewhere on the board
/writePos/D2: Q405.2 (G); also elsewhere on the board
/writePos/D3: Q407.2 (G); also elsewhere on the board
/writePos/D4: Q409.2 (G); also elsewhere on the board
/writePos/D5: Q411.2 (G); also elsewhere on the board
/writePos/D6: Q413.2 (G); also elsewhere on the board
/writePos/D7: Q415.2 (G); also elsewhere on the board
GND: Q402.1 (S), Q404.1 (S), Q406.1 (S), Q408.1 (S), Q410.1 (S), Q412.1 (S), Q414.1 (S), Q416.1 (S); also elsewhere on the board
unnamed: Q401.1 (S), Q402.3 (D)
unnamed: Q403.1 (S), Q404.3 (D)
unnamed: Q405.1 (S), Q406.3 (D)
unnamed: Q407.1 (S), Q408.3 (D)
unnamed: Q409.1 (S), Q410.3 (D)
unnamed: Q411.1 (S), Q412.3 (D)
unnamed: Q413.1 (S), Q414.3 (D)
unnamed: Q415.1 (S), Q416.3 (D)

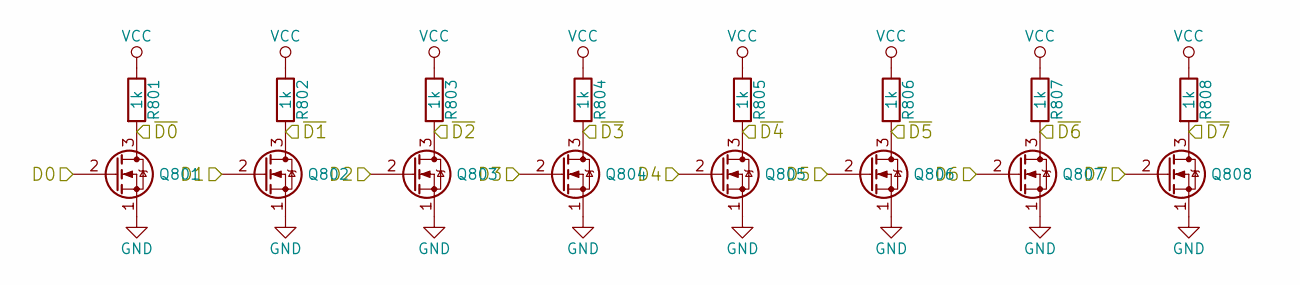
[picture p42: schematic inv.sch]

Parts:
Q501, Q502, Q503, Q504, Q505, Q506, Q507, Q508: 2N7000; TO-92-FET
R501, R502, R503, R504, R505, R506, R507, R508: 1k; R_small

Connections:
/inv/D0: Q501.2 (G); also elsewhere on the board
/inv/D1: Q502.2 (G); also elsewhere on the board
/inv/D2: Q503.2 (G); also elsewhere on the board
/inv/D3: Q504.2 (G); also elsewhere on the board
/inv/D4: Q505.2 (G); also elsewhere on the board
/inv/D5: Q506.2 (G); also elsewhere on the board
/inv/D6: Q507.2 (G); also elsewhere on the board
/inv/D7: Q508.2 (G); also elsewhere on the board
/writePos/D0: Q501.3 (D), R501.2; also elsewhere on the board
/writePos/D1: Q502.3 (D), R502.2; also elsewhere on the board
/writePos/D2: Q503.3 (D), R503.2; also elsewhere on the board
/writePos/D3: Q504.3 (D), R504.2; also elsewhere on the board
/writePos/D4: Q505.3 (D), R505.2; also elsewhere on the board
/writePos/D5: Q506.3 (D), R506.2; also elsewhere on the board
/writePos/D6: Q507.3 (D), R507.2; also elsewhere on the board
/writePos/D7: Q508.3 (D), R508.2; also elsewhere on the board
GND: Q501.1 (S), Q502.1 (S), Q503.1 (S), Q504.1 (S), Q505.1 (S), Q506.1 (S), Q507.1 (S), Q508.1 (S); also elsewhere on the board
VCC: R501.1, R502.1, R503.1, R504.1, R505.1, R506.1, R507.1, R508.1; also elsewhere on the board

Parts of its further copies:
Q801, Q802, Q803, Q804, Q805, Q806, Q807, Q808: 2N7000; TO-92-FET
R801, R802, R803, R804, R805, R806, R807, R808: 1k; R_small

Connections of its further copies:
/Ten/T0: Q801.3 (D), R801.2; also elsewhere on the board
/Ten/T1: Q802.3 (D), R802.2; also elsewhere on the board
/Ten/T2: Q803.3 (D), R803.2; also elsewhere on the board
/Ten/T3: Q804.3 (D), R804.2; also elsewhere on the board
/Ten/T4: Q805.3 (D), R805.2; also elsewhere on the board
/Ten/T5: Q806.3 (D), R806.2; also elsewhere on the board
/Ten/T6: Q807.3 (D), R807.2; also elsewhere on the board
/Ten/T7: Q808.3 (D), R808.2; also elsewhere on the board
/inv2/D0: Q801.2 (G); also elsewhere on the board
/inv2/D1: Q802.2 (G); also elsewhere on the board
/inv2/D2: Q803.2 (G); also elsewhere on the board
/inv2/D3: Q804.2 (G); also elsewhere on the board
/inv2/D4: Q805.2 (G); also elsewhere on the board
/inv2/D5: Q806.2 (G); also elsewhere on the board
/inv2/D6: Q807.2 (G); also elsewhere on the board
/inv2/D7: Q808.2 (G); also elsewhere on the board
GND: Q801.1 (S), Q802.1 (S), Q803.1 (S), Q804.1 (S), Q805.1 (S), Q806.1 (S), Q807.1 (S), Q808.1 (S); also elsewhere on the board
VCC: R801.1, R802.1, R803.1, R804.1, R805.1, R806.1, R807.1, R808.1; also elsewhere on the board

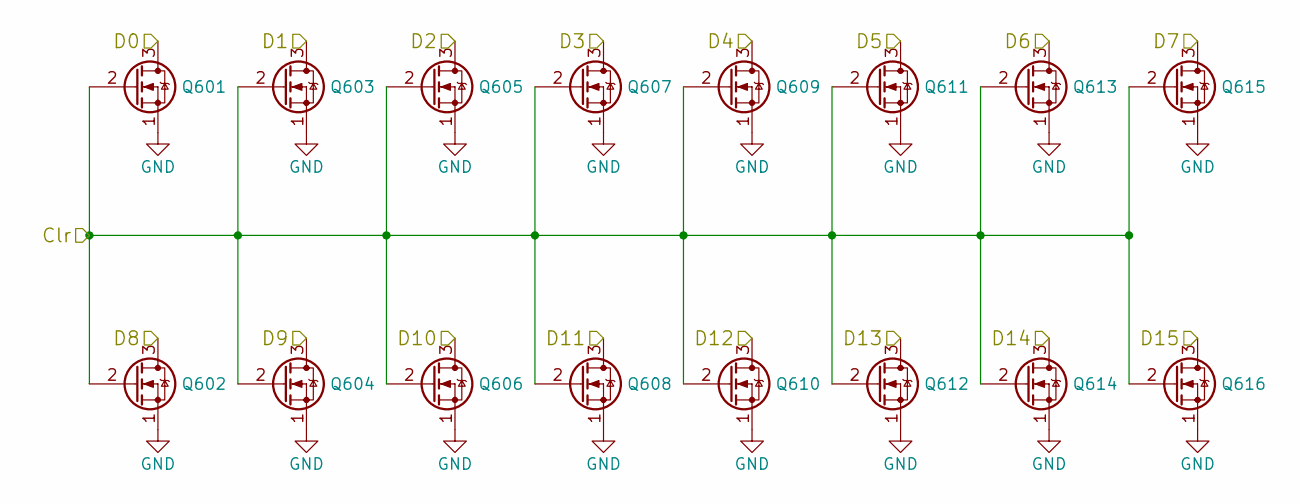
[picture p43: schematic clear.sch]

Parts:
Q601, Q602, Q603, Q604, Q605, Q606, Q607, Q608, Q609, Q610, Q611, Q612, Q613, Q614, Q615, Q616: 2N7000; TO-92-FET

Connections:
/clear/Clr: Q601.2 (G), Q602.2 (G), Q603.2 (G), Q604.2 (G), Q605.2 (G), Q606.2 (G), Q607.2 (G), Q608.2 (G), Q609.2 (G), Q610.2 (G), Q611.2 (G), Q612.2 (G), Q613.2 (G), Q614.2 (G), Q615.2 (G), Q616.2 (G); also elsewhere on the board
/clear/D0: Q601.3 (D); also elsewhere on the board
/clear/D1: Q603.3 (D); also elsewhere on the board
/clear/D2: Q605.3 (D); also elsewhere on the board
/clear/D3: Q607.3 (D); also elsewhere on the board
/clear/D4: Q609.3 (D); also elsewhere on the board
/clear/D5: Q611.3 (D); also elsewhere on the board
/clear/D6: Q613.3 (D); also elsewhere on the board
/clear/D7: Q615.3 (D); also elsewhere on the board
/clear/D8: Q602.3 (D); also elsewhere on the board
/clear/D9: Q604.3 (D); also elsewhere on the board
/clear/D10: Q606.3 (D); also elsewhere on the board
/clear/D11: Q608.3 (D); also elsewhere on the board
/clear/D12: Q610.3 (D); also elsewhere on the board
/clear/D13: Q612.3 (D); also elsewhere on the board
/clear/D14: Q614.3 (D); also elsewhere on the board
/clear/D15: Q616.3 (D); also elsewhere on the board
GND: Q601.1 (S), Q602.1 (S), Q603.1 (S), Q604.1 (S), Q605.1 (S), Q606.1 (S), Q607.1 (S), Q608.1 (S), Q609.1 (S), Q610.1 (S), Q611.1 (S), Q612.1 (S), Q613.1 (S), Q614.1 (S), Q615.1 (S), Q616.1 (S); also elsewhere on the board

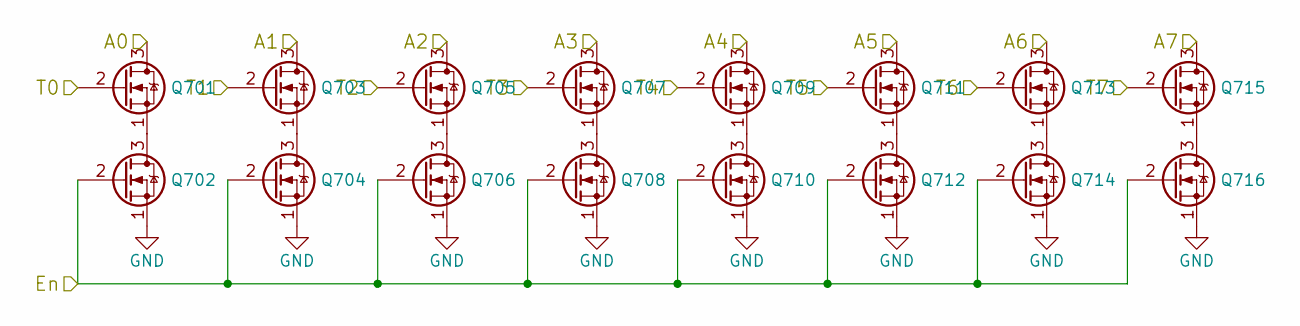
[picture p44: schematic Ten.sch]

Parts:
Q701, Q702, Q703, Q704, Q705, Q706, Q707, Q708, Q709, Q710, Q711, Q712, Q713, Q714, Q715, Q716: 2N7000; TO-92-FET

Connections:
/Ten/A0: Q701.3 (D); also elsewhere on the board
/Ten/A1: Q703.3 (D); also elsewhere on the board
/Ten/A2: Q705.3 (D); also elsewhere on the board
/Ten/A3: Q707.3 (D); also elsewhere on the board
/Ten/A4: Q709.3 (D); also elsewhere on the board
/Ten/A5: Q711.3 (D); also elsewhere on the board
/Ten/A6: Q713.3 (D); also elsewhere on the board
/Ten/A7: Q715.3 (D); also elsewhere on the board
/Ten/En: Q702.2 (G), Q704.2 (G), Q706.2 (G), Q708.2 (G), Q710.2 (G), Q712.2 (G), Q714.2 (G), Q716.2 (G); also elsewhere on the board
/Ten/T0: Q701.2 (G); also elsewhere on the board
/Ten/T1: Q703.2 (G); also elsewhere on the board
/Ten/T2: Q705.2 (G); also elsewhere on the board
/Ten/T3: Q707.2 (G); also elsewhere on the board
/Ten/T4: Q709.2 (G); also elsewhere on the board
/Ten/T5: Q711.2 (G); also elsewhere on the board
/Ten/T6: Q713.2 (G); also elsewhere on the board
/Ten/T7: Q715.2 (G); also elsewhere on the board
GND: Q702.1 (S), Q704.1 (S), Q706.1 (S), Q708.1 (S), Q710.1 (S), Q712.1 (S), Q714.1 (S), Q716.1 (S); also elsewhere on the board
unnamed: Q701.1 (S), Q702.3 (D)
unnamed: Q703.1 (S), Q704.3 (D)
unnamed: Q705.1 (S), Q706.3 (D)
unnamed: Q707.1 (S), Q708.3 (D)
unnamed: Q709.1 (S), Q710.3 (D)
unnamed: Q711.1 (S), Q712.3 (D)
unnamed: Q713.1 (S), Q714.3 (D)
unnamed: Q715.1 (S), Q716.3 (D)

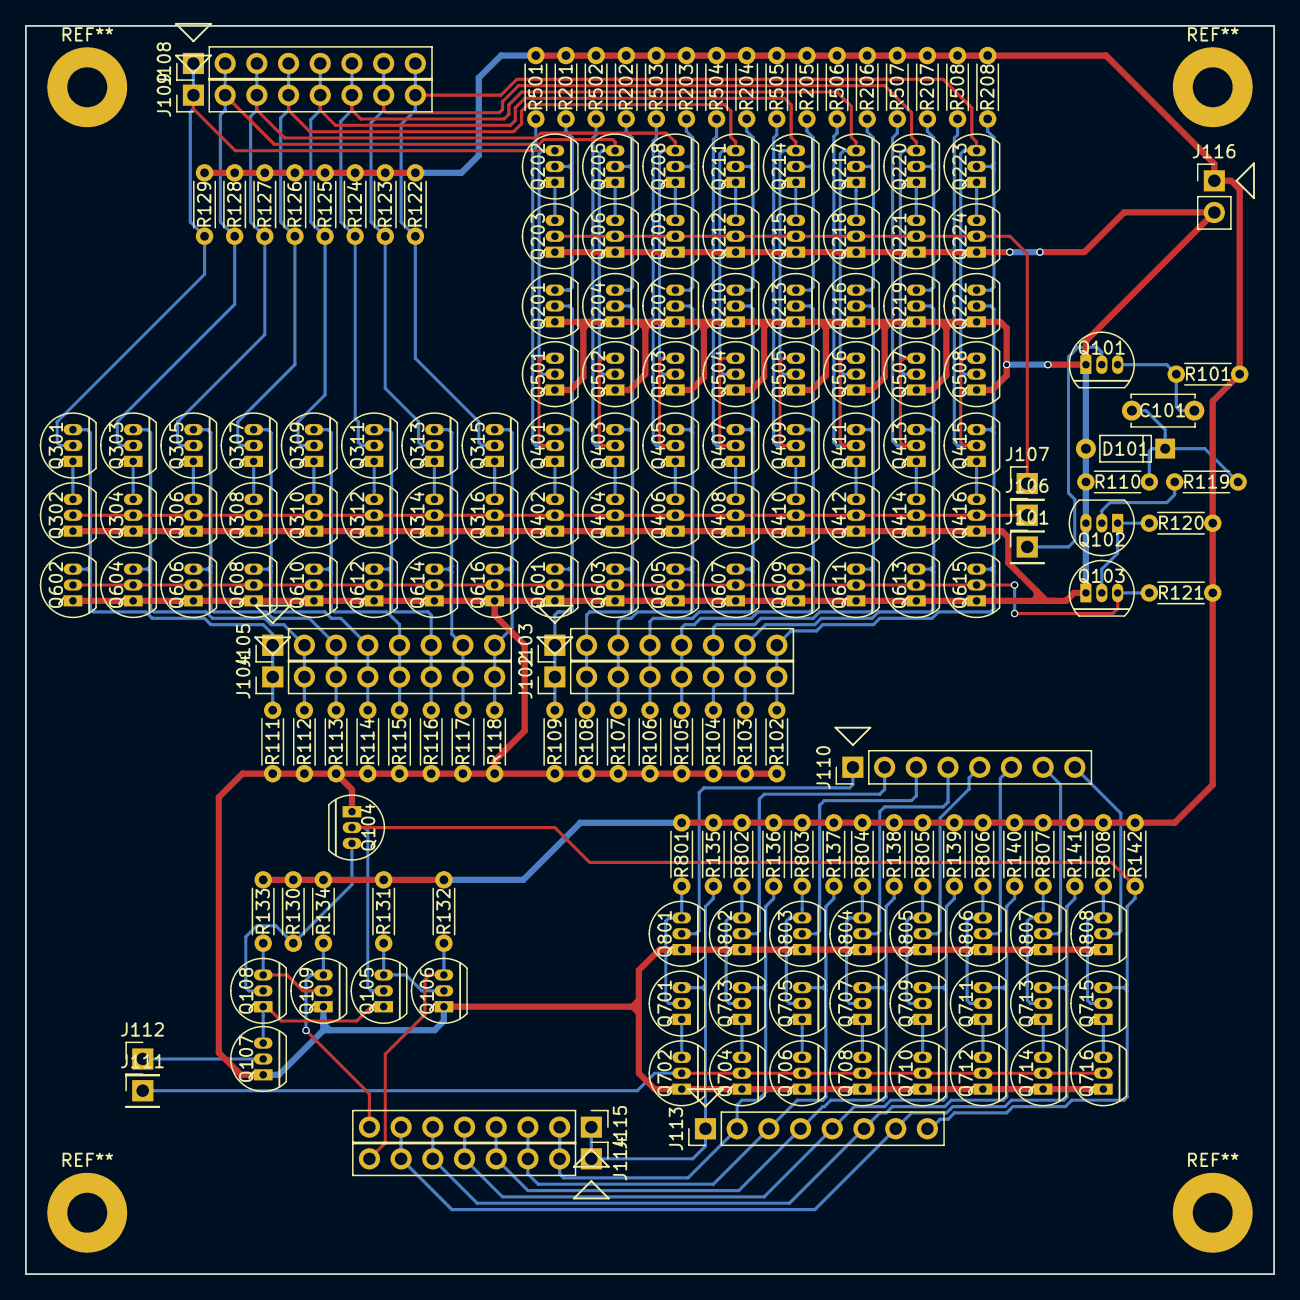
[picture p45: board controller.kicad_pcb from above]

Board: 2 copper layers, 100.0 x 100.0 mm, 197 parts (0 on the bottom side), 114 nets.
