davidv1992/Trans1/designs/utility/power/power.kicad_pcb

## KiCad design designs/utility/power/power.kicad_pcb (2025-08-03)

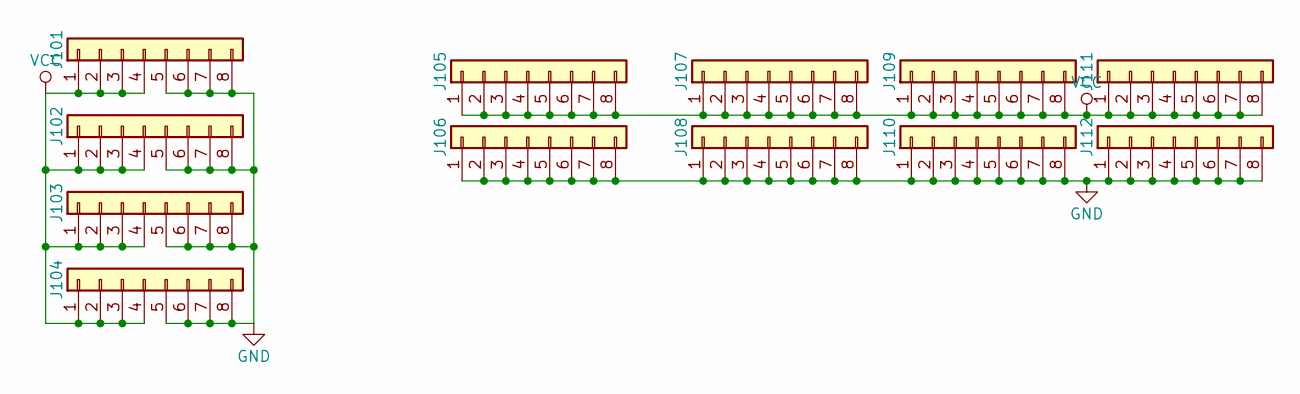
[picture p46: schematic power.sch]

Parts:
J101, J102, J103, J104, J105, J106, J107, J108, J109, J110, J111, J112: Conn_01x08; PH_1x8

Connections:
GND: J101.5, J101.6, J101.7, J101.8, J102.5, J102.6, J102.7, J102.8, J103.5, J103.6, J103.7, J103.8, J104.5, J104.6, J104.7, J104.8, J106.1, J106.2, J106.3, J106.4, J106.5, J106.6, J106.7, J106.8, J108.1, J108.2, J108.3, J108.4, J108.5, J108.6, J108.7, J108.8, J110.1, J110.2, J110.3, J110.4, J110.5, J110.6, J110.7, J110.8, J112.1, J112.2, J112.3, J112.4, J112.5, J112.6, J112.7, J112.8
VCC: J101.1, J101.2, J101.3, J101.4, J102.1, J102.2, J102.3, J102.4, J103.1, J103.2, J103.3, J103.4, J104.1, J104.2, J104.3, J104.4, J105.1, J105.2, J105.3, J105.4, J105.5, J105.6, J105.7, J105.8, J107.1, J107.2, J107.3, J107.4, J107.5, J107.6, J107.7, J107.8, J109.1, J109.2, J109.3, J109.4, J109.5, J109.6, J109.7, J109.8, J111.1, J111.2, J111.3, J111.4, J111.5, J111.6, J111.7, J111.8

Board: 2 copper layers, 12 parts (0 on the bottom side), 2 nets, no tracks yet.
