davidv1992/Trans1/designs/utility/testio/testio.kicad_pcb

## KiCad design designs/utility/testio/testio.kicad_pcb (2019-09-25)

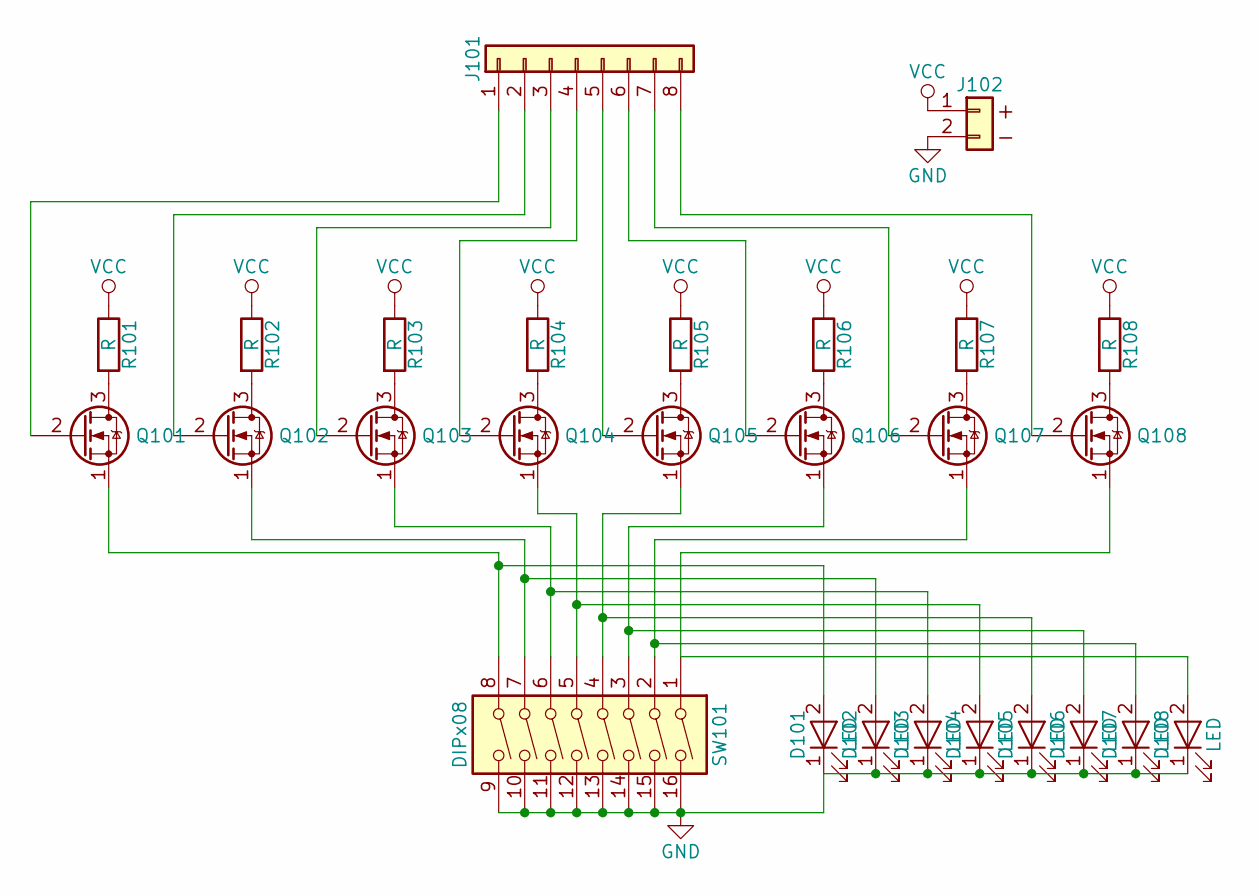
[picture p47: schematic testio.sch]

Parts:
D101, D102, D103, D104, D105, D106, D107, D108: LED; LED_D3.0mm
J101: Conn_01x08; PH_1x8
J102: Conn_01x02_Power; PH_1x2
Q101, Q102, Q103, Q104, Q105, Q106, Q107, Q108: 2N7000; TO-92-FET
R101, R102, R103, R104, R105, R106, R107, R108: R; R_small
SW101: DIPx08; DIPx8

Connections:
GND: D101.1 (K), D102.1 (K), D103.1 (K), D104.1 (K), D105.1 (K), D106.1 (K), D107.1 (K), D108.1 (K), J102.2, SW101.9, SW101.10, SW101.11, SW101.12, SW101.13, SW101.14, SW101.15, SW101.16
unnamed: D101.2 (A), Q101.1 (S), SW101.8
unnamed: D102.2 (A), Q102.1 (S), SW101.7
unnamed: D103.2 (A), Q103.1 (S), SW101.6
unnamed: D104.2 (A), Q104.1 (S), SW101.5
unnamed: D105.2 (A), Q105.1 (S), SW101.4
unnamed: D106.2 (A), Q106.1 (S), SW101.3
unnamed: D107.2 (A), Q107.1 (S), SW101.2
unnamed: D108.2 (A), Q108.1 (S), SW101.1
unnamed: J101.1, Q101.2 (G)
unnamed: J101.2, Q102.2 (G)
unnamed: J101.3, Q103.2 (G)
unnamed: J101.4, Q104.2 (G)
unnamed: J101.5, Q105.2 (G)
unnamed: J101.6, Q106.2 (G)
unnamed: J101.7, Q107.2 (G)
unnamed: J101.8, Q108.2 (G)
unnamed: Q101.3 (D), R101.2
unnamed: Q102.3 (D), R102.2
unnamed: Q103.3 (D), R103.2
unnamed: Q104.3 (D), R104.2
unnamed: Q105.3 (D), R105.2
unnamed: Q106.3 (D), R106.2
unnamed: Q107.3 (D), R107.2
unnamed: Q108.3 (D), R108.2
VCC: J102.1, R101.1, R102.1, R103.1, R104.1, R105.1, R106.1, R107.1, R108.1

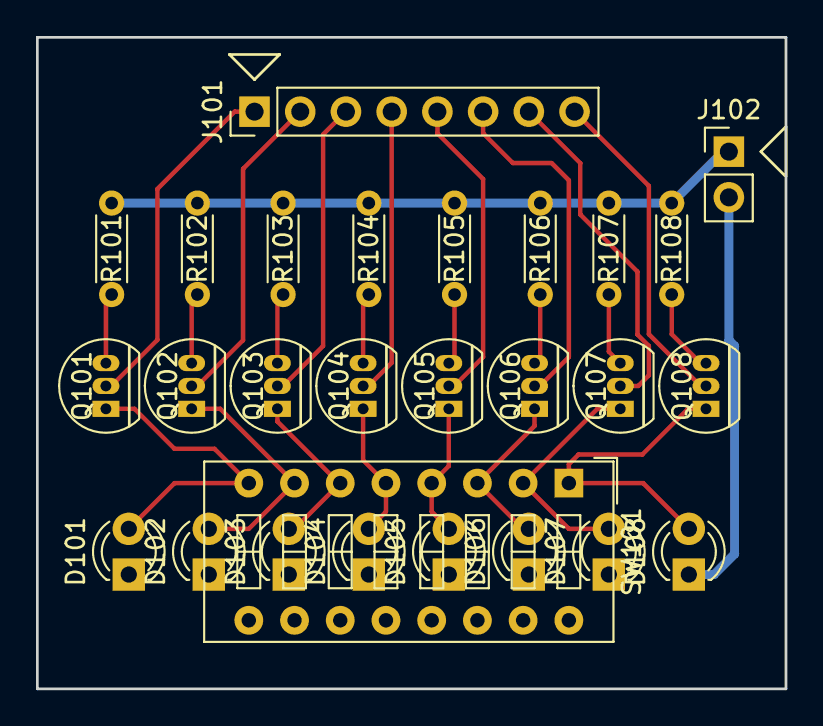
[picture p48: board testio.kicad_pcb from above]

Board: 2 copper layers, 41.6 x 36.2 mm, 27 parts (0 on the bottom side), 26 nets.
