davidv1992/Trans1/designs/pc/pc.kicad_pcb

## KiCad design designs/pc/pc.kicad_pcb (2019-08-27)

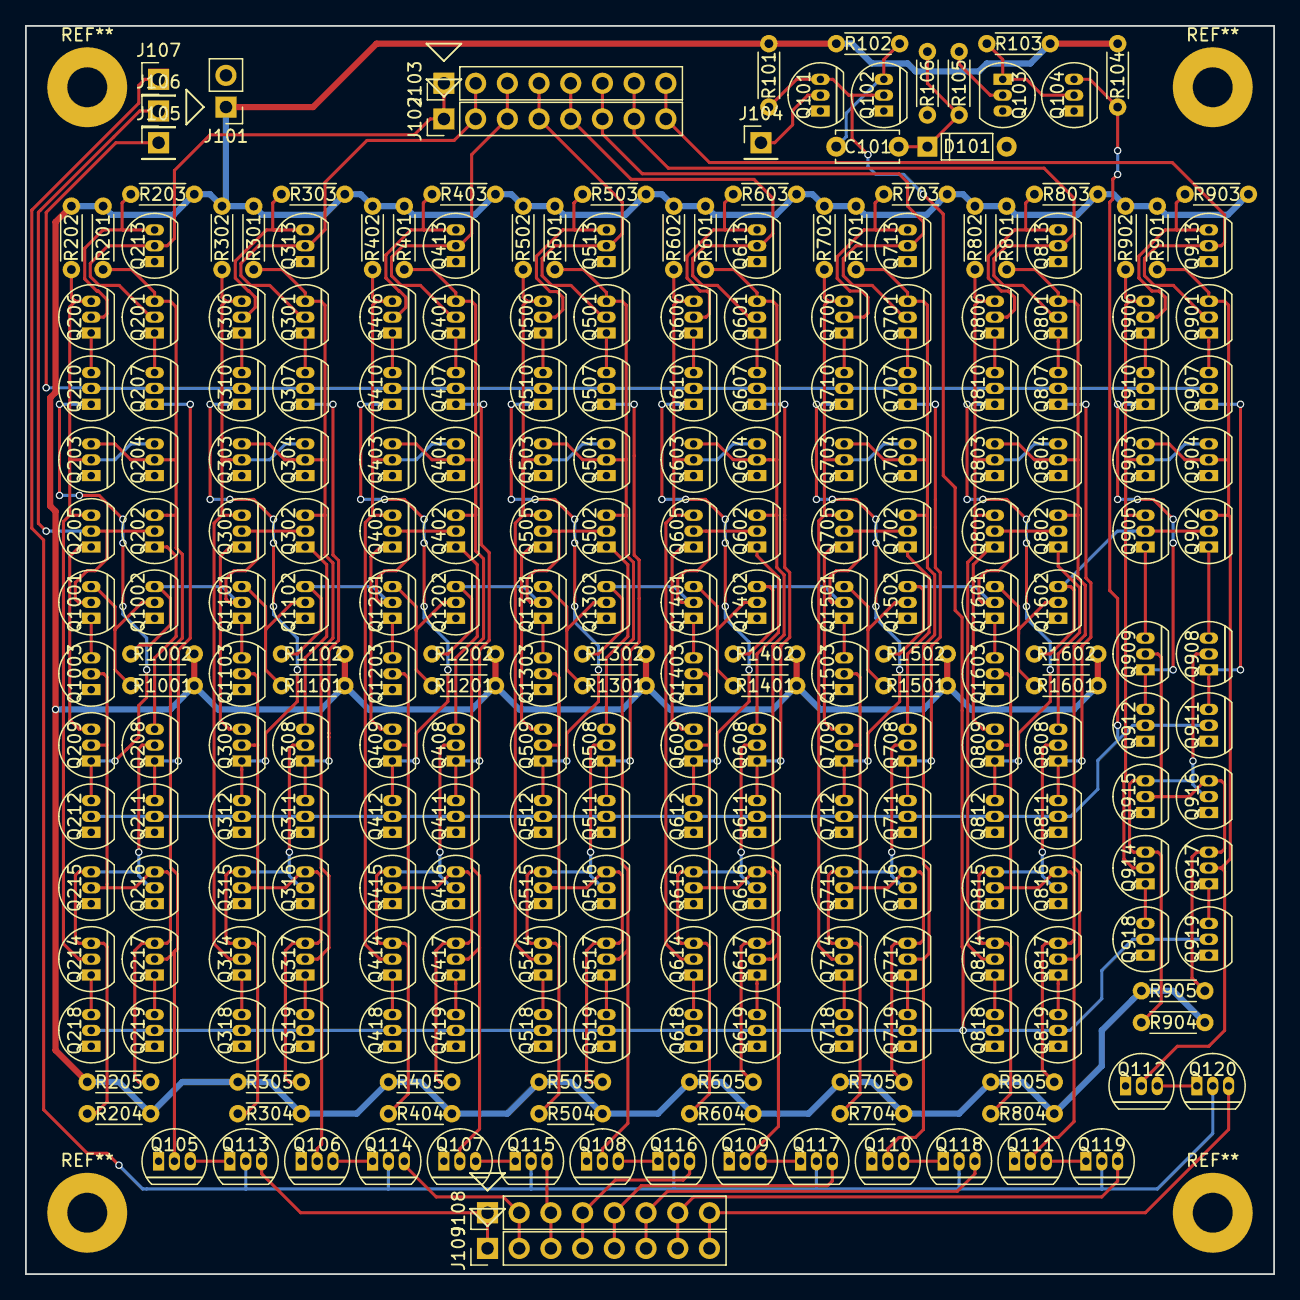
[picture p49: board pc.kicad_pcb from above]

Board: 2 copper layers, 100.0 x 100.0 mm, 264 parts (0 on the bottom side), 161 nets.

Parts:
C101: 100pF; C_default
D101: 1N4148; D_default
J101: Conn_01x02_Power; PH_1x2
J102, J103, J108, J109: Conn_01x08; PH_1x8
J104, J105, J106, J107: Conn_01x01; PH_1x1
Q101, Q102, Q104, Q105, Q106, Q107, Q108, Q109, Q110, Q111, Q112, Q113, Q114, Q115, Q116, Q117, Q118, Q119, Q120, Q201, Q202, Q203, Q204, Q205, Q206, Q207, Q208, Q209, Q210, Q211, Q212, Q213, Q214, Q215, Q216, Q217, Q218, Q219, Q301, Q302, Q303, Q304, Q305, Q306, Q307, Q308, Q309, Q310, Q311, Q312, Q313, Q314, Q315, Q316, Q317, Q318, Q319, Q401, Q402, Q403, Q404, Q405, Q406, Q407, Q408, Q409, Q410, Q411, Q412, Q413, Q414, Q415, Q416, Q417, Q418, Q419, Q501, Q502, Q503, Q504, Q505, Q506, Q507, Q508, Q509, Q510, Q511, Q512, Q513, Q514, Q515, Q516, Q517, Q518, Q519, Q601, Q602, Q603, Q604, Q605, Q606, Q607, Q608, Q609, Q610, Q611, Q612, Q613, Q614, Q615, Q616, Q617, Q618, Q619, Q701, Q702, Q703, Q704, Q705, Q706, Q707, Q708, Q709, Q710, Q711, Q712, Q713, Q714, Q715, Q716, Q717, Q718, Q719, Q801, Q802, Q803, Q804, Q805, Q806, Q807, Q808, Q809, Q810, Q811, Q812, Q813, Q814, Q815, Q816, Q817, Q818, Q819, Q901, Q902, Q903, Q904, Q905, Q906, Q907, Q908, Q909, Q910, Q911, Q912, Q913, Q914, Q915, Q916, Q917, Q918, Q919, Q1001, Q1002, Q1003, Q1101, Q1102, Q1103, Q1201, Q1202, Q1203, Q1301, Q1302, Q1303, Q1401, Q1402, Q1403, Q1501, Q1502, Q1503, Q1601, Q1602, Q1603: 2N7000; TO-92-FET
Q103: BC547; TO-92-BJT
R101, R102, R103, R104, R201, R202, R203, R204, R205, R301, R302, R303, R304, R305, R401, R402, R403, R404, R405, R501, R502, R503, R504, R505, R601, R602, R603, R604, R605, R701, R702, R703, R704, R705, R801, R802, R803, R804, R805, R901, R902, R903, R904, R905, R1001, R1002, R1101, R1102, R1201, R1202, R1301, R1302, R1401, R1402, R1501, R1502, R1601, R1602: 1k; R_small
R105, R106: 10k; R_small

Connections:
/pcbit0/C: Q104.3, Q211.2, Q212.2, Q311.2, Q312.2, Q411.2, Q412.2, Q511.2, Q512.2, Q611.2, Q612.2, Q711.2, Q712.2, Q811.2, Q812.2, Q911.2, Q912.2, R104.2
/pcbit0/Ca: Q209.2, Q215.2, Q216.3, Q217.3, Q1003.2, R205.2
/pcbit0/D: J102.1, J103.1, Q201.2, Q213.2
/pcbit0/DEn: J105.1, Q207.2, Q210.2, Q307.2, Q310.2, Q407.2, Q410.2, Q507.2, Q510.2, Q607.2, Q610.2, Q707.2, Q710.2, Q807.2, Q810.2, Q907.2, Q910.2
/pcbit0/Q: Q203.2, Q204.3, Q205.3, Q206.3, Q214.2, R202.2
/pcbit0/~C~: Q101.3, Q102.2, Q218.2, Q219.2, Q318.2, Q319.2, Q418.2, Q419.2, Q518.2, Q519.2, Q618.2, Q619.2, Q718.2, Q719.2, Q818.2, Q819.2, Q918.2, Q919.2, R101.2
/pcbit0/~Q~: Q105.2, Q201.3, Q202.3, Q203.3, Q204.2, Q217.2, R201.2
/pcbit1/Ca: Q309.2, Q315.2, Q316.3, Q317.3, Q1103.2, R305.2
/pcbit1/D: J102.2, J103.2, Q301.2, Q313.2
/pcbit1/Q: Q303.2, Q304.3, Q305.3, Q306.3, Q314.2, R302.2
/pcbit1/~Q~: Q106.2, Q301.3, Q302.3, Q303.3, Q304.2, Q317.2, R301.2
/pcbit2/Ca: Q409.2, Q415.2, Q416.3, Q417.3, Q1203.2, R405.2
/pcbit2/D: J102.3, J103.3, Q401.2, Q413.2
/pcbit2/Q: Q403.2, Q404.3, Q405.3, Q406.3, Q414.2, R402.2
/pcbit2/~Q~: Q107.2, Q401.3, Q402.3, Q403.3, Q404.2, Q417.2, R401.2
/pcbit3/Ca: Q509.2, Q515.2, Q516.3, Q517.3, Q1303.2, R505.2
/pcbit3/D: J102.4, J103.4, Q501.2, Q513.2
/pcbit3/Q: Q503.2, Q504.3, Q505.3, Q506.3, Q514.2, R502.2
/pcbit3/~Q~: Q108.2, Q501.3, Q502.3, Q503.3, Q504.2, Q517.2, R501.2
/pcbit4/Ca: Q609.2, Q615.2, Q616.3, Q617.3, Q1403.2, R605.2
/pcbit4/D: J102.5, J103.5, Q601.2, Q613.2
/pcbit4/Q: Q603.2, Q604.3, Q605.3, Q606.3, Q614.2, R602.2
/pcbit4/~Q~: Q109.2, Q601.3, Q602.3, Q603.3, Q604.2, Q617.2, R601.2
/pcbit5/Ca: Q709.2, Q715.2, Q716.3, Q717.3, Q1503.2, R705.2
/pcbit5/D: J102.6, J103.6, Q701.2, Q713.2
/pcbit5/Q: Q703.2, Q704.3, Q705.3, Q706.3, Q714.2, R702.2
/pcbit5/~Q~: Q110.2, Q701.3, Q702.3, Q703.3, Q704.2, Q717.2, R701.2
/pcbit6/Ca: Q809.2, Q815.2, Q816.3, Q817.3, Q1603.2, R805.2
/pcbit6/D: J102.7, J103.7, Q801.2, Q813.2
/pcbit6/Q: Q803.2, Q804.3, Q805.3, Q806.3, Q814.2, R802.2
/pcbit6/~Q~: Q111.2, Q801.3, Q802.3, Q803.3, Q804.2, Q817.2, R801.2
/pcbit7/Ca: Q909.2, Q915.2, Q916.3, Q917.3, R905.2
/pcbit7/D: J102.8, J103.8, Q901.2, Q913.2
/pcbit7/Q: Q903.2, Q904.3, Q905.3, Q906.3, Q914.2, R902.2
/pcbit7/~Q~: Q112.2, Q901.3, Q902.3, Q903.3, Q904.2, Q917.2, R901.2
/pcc1/NEn: Q302.2, Q305.2, Q1002.3, Q1101.2, R1002.2
/pcc1/PEn: J106.1, Q202.2, Q205.2, Q1001.2
/sheet5C453C86/NEn: Q702.2, Q705.2, Q1402.3, Q1501.2, R1402.2
/sheet5C453C87/NEn: Q802.2, Q805.2, Q1502.3, Q1601.2, R1502.2
/sheet5C4545D6/NEn: Q902.2, Q905.2, Q1602.3, R1602.2
/sheet5C45280B/NEn: Q402.2, Q405.2, Q1102.3, Q1201.2, R1102.2
/sheet5C453582/NEn: Q502.2, Q505.2, Q1202.3, Q1301.2, R1202.2
/sheet5C453583/NEn: Q602.2, Q605.2, Q1302.3, Q1401.2, R1302.2
GND: D101.2, J101.2, Q101.1, Q102.1, Q103.3, Q104.1, Q105.1, Q106.1, Q107.1, Q108.1, Q109.1, Q110.1, Q111.1, Q112.1, Q203.1, Q204.1, Q211.1, Q212.1, Q213.1, Q215.1, Q216.1, Q218.1, Q219.1, Q303.1, Q304.1, Q311.1, Q312.1, Q313.1, Q315.1, Q316.1, Q318.1, Q319.1, Q403.1, Q404.1, Q411.1, Q412.1, Q413.1, Q415.1, Q416.1, Q418.1, Q419.1, Q503.1, Q504.1, Q511.1, Q512.1, Q513.1, Q515.1, Q516.1, Q518.1, Q519.1, Q603.1, Q604.1, Q611.1, Q612.1, Q613.1, Q615.1, Q616.1, Q618.1, Q619.1, Q703.1, Q704.1, Q711.1, Q712.1, Q713.1, Q715.1, Q716.1, Q718.1, Q719.1, Q803.1, Q804.1, Q811.1, Q812.1, Q813.1, Q815.1, Q816.1, Q818.1, Q819.1, Q903.1, Q904.1, Q911.1, Q912.1, Q913.1, Q915.1, Q916.1, Q918.1, Q919.1, Q1002.1, Q1003.1, Q1102.1, Q1103.1, Q1202.1, Q1203.1, Q1302.1, Q1303.1, Q1402.1, Q1403.1, Q1502.1, Q1503.1, Q1602.1, Q1603.1, R106.2
unnamed: C101.1, Q102.3, R102.2
unnamed: C101.2, D101.1, R105.2, R106.1
unnamed: J104.1, Q101.2
unnamed: J107.1, Q113.2, Q114.2, Q115.2, Q116.2, Q117.2, Q118.2, Q119.2, Q120.2
unnamed: J108.1, J109.1, Q113.3
unnamed: J108.2, J109.2, Q114.3
unnamed: J108.3, J109.3, Q115.3
unnamed: J108.4, J109.4, Q116.3
unnamed: J108.5, J109.5, Q117.3
unnamed: J108.6, J109.6, Q118.3
unnamed: J108.7, J109.7, Q119.3
unnamed: J108.8, J109.8, Q120.3
unnamed: Q103.1, Q104.2, R103.2
unnamed: Q103.2, R105.1
unnamed: Q105.3, Q113.1
unnamed: Q106.3, Q114.1
unnamed: Q107.3, Q115.1
unnamed: Q108.3, Q116.1
unnamed: Q109.3, Q117.1
unnamed: Q110.3, Q118.1
unnamed: Q111.3, Q119.1
unnamed: Q112.3, Q120.1
unnamed: Q201.1, Q207.3
unnamed: Q202.1, Q208.3
unnamed: Q205.1, Q209.3
unnamed: Q206.1, Q210.3
unnamed: Q206.2, Q213.3, R203.2
unnamed: Q207.1, Q208.1, Q211.3
unnamed: Q208.2, Q214.3, Q215.3, Q216.2, R204.2
unnamed: Q209.1, Q210.1, Q212.3
unnamed: Q214.1, Q218.3
unnamed: Q217.1, Q219.3
unnamed: Q301.1, Q307.3
unnamed: Q302.1, Q308.3
unnamed: Q305.1, Q309.3
unnamed: Q306.1, Q310.3
unnamed: Q306.2, Q313.3, R303.2
unnamed: Q307.1, Q308.1, Q311.3
unnamed: Q308.2, Q314.3, Q315.3, Q316.2, R304.2
unnamed: Q309.1, Q310.1, Q312.3
unnamed: Q314.1, Q318.3
unnamed: Q317.1, Q319.3
unnamed: Q401.1, Q407.3
unnamed: Q402.1, Q408.3
unnamed: Q405.1, Q409.3
unnamed: Q406.1, Q410.3
unnamed: Q406.2, Q413.3, R403.2
unnamed: Q407.1, Q408.1, Q411.3
unnamed: Q408.2, Q414.3, Q415.3, Q416.2, R404.2
unnamed: Q409.1, Q410.1, Q412.3
unnamed: Q414.1, Q418.3
unnamed: Q417.1, Q419.3
unnamed: Q501.1, Q507.3
unnamed: Q502.1, Q508.3
unnamed: Q505.1, Q509.3
unnamed: Q506.1, Q510.3
unnamed: Q506.2, Q513.3, R503.2
unnamed: Q507.1, Q508.1, Q511.3
unnamed: Q508.2, Q514.3, Q515.3, Q516.2, R504.2
unnamed: Q509.1, Q510.1, Q512.3
unnamed: Q514.1, Q518.3
unnamed: Q517.1, Q519.3
unnamed: Q601.1, Q607.3
unnamed: Q602.1, Q608.3
unnamed: Q605.1, Q609.3
unnamed: Q606.1, Q610.3
unnamed: Q606.2, Q613.3, R603.2
unnamed: Q607.1, Q608.1, Q611.3
unnamed: Q608.2, Q614.3, Q615.3, Q616.2, R604.2
unnamed: Q609.1, Q610.1, Q612.3
unnamed: Q614.1, Q618.3
unnamed: Q617.1, Q619.3
unnamed: Q701.1, Q707.3
unnamed: Q702.1, Q708.3
unnamed: Q705.1, Q709.3
unnamed: Q706.1, Q710.3
unnamed: Q706.2, Q713.3, R703.2
unnamed: Q707.1, Q708.1, Q711.3
unnamed: Q708.2, Q714.3, Q715.3, Q716.2, R704.2
unnamed: Q709.1, Q710.1, Q712.3
unnamed: Q714.1, Q718.3
unnamed: Q717.1, Q719.3
unnamed: Q801.1, Q807.3
unnamed: Q802.1, Q808.3
unnamed: Q805.1, Q809.3
unnamed: Q806.1, Q810.3
unnamed: Q806.2, Q813.3, R803.2
unnamed: Q807.1, Q808.1, Q811.3
unnamed: Q808.2, Q814.3, Q815.3, Q816.2, R804.2
unnamed: Q809.1, Q810.1, Q812.3
unnamed: Q814.1, Q818.3
unnamed: Q817.1, Q819.3
unnamed: Q901.1, Q907.3
unnamed: Q902.1, Q908.3
unnamed: Q905.1, Q909.3
unnamed: Q906.1, Q910.3
unnamed: Q906.2, Q913.3, R903.2
unnamed: Q907.1, Q908.1, Q911.3
unnamed: Q908.2, Q914.3, Q915.3, Q916.2, R904.2
unnamed: Q909.1, Q910.1, Q912.3
unnamed: Q914.1, Q918.3
unnamed: Q917.1, Q919.3
unnamed: Q1001.1, Q1003.3
unnamed: Q1001.3, Q1002.2, R1001.2
unnamed: Q1101.1, Q1103.3
unnamed: Q1101.3, Q1102.2, R1101.2
unnamed: Q1201.1, Q1203.3
unnamed: Q1201.3, Q1202.2, R1201.2
unnamed: Q1301.1, Q1303.3
unnamed: Q1301.3, Q1302.2, R1301.2
unnamed: Q1401.1, Q1403.3
unnamed: Q1401.3, Q1402.2, R1401.2
unnamed: Q1501.1, Q1503.3
unnamed: Q1501.3, Q1502.2, R1501.2
unnamed: Q1601.1, Q1603.3
unnamed: Q1601.3, Q1602.2, R1601.2
VCC: J101.1, R101.1, R102.1, R103.1, R104.1, R201.1, R202.1, R203.1, R204.1, R205.1, R301.1, R302.1, R303.1, R304.1, R305.1, R401.1, R402.1, R403.1, R404.1, R405.1, R501.1, R502.1, R503.1, R504.1, R505.1, R601.1, R602.1, R603.1, R604.1, R605.1, R701.1, R702.1, R703.1, R704.1, R705.1, R801.1, R802.1, R803.1, R804.1, R805.1, R901.1, R902.1, R903.1, R904.1, R905.1, R1001.1, R1002.1, R1101.1, R1102.1, R1201.1, R1202.1, R1301.1, R1302.1, R1401.1, R1402.1, R1501.1, R1502.1, R1601.1, R1602.1
