davidv1992/Trans1/designs/adder/core (copy 1)/core.kicad_pcb

## KiCad design designs/adder/core (copy 1)/core.kicad_pcb (2019-08-27, an earlier design)

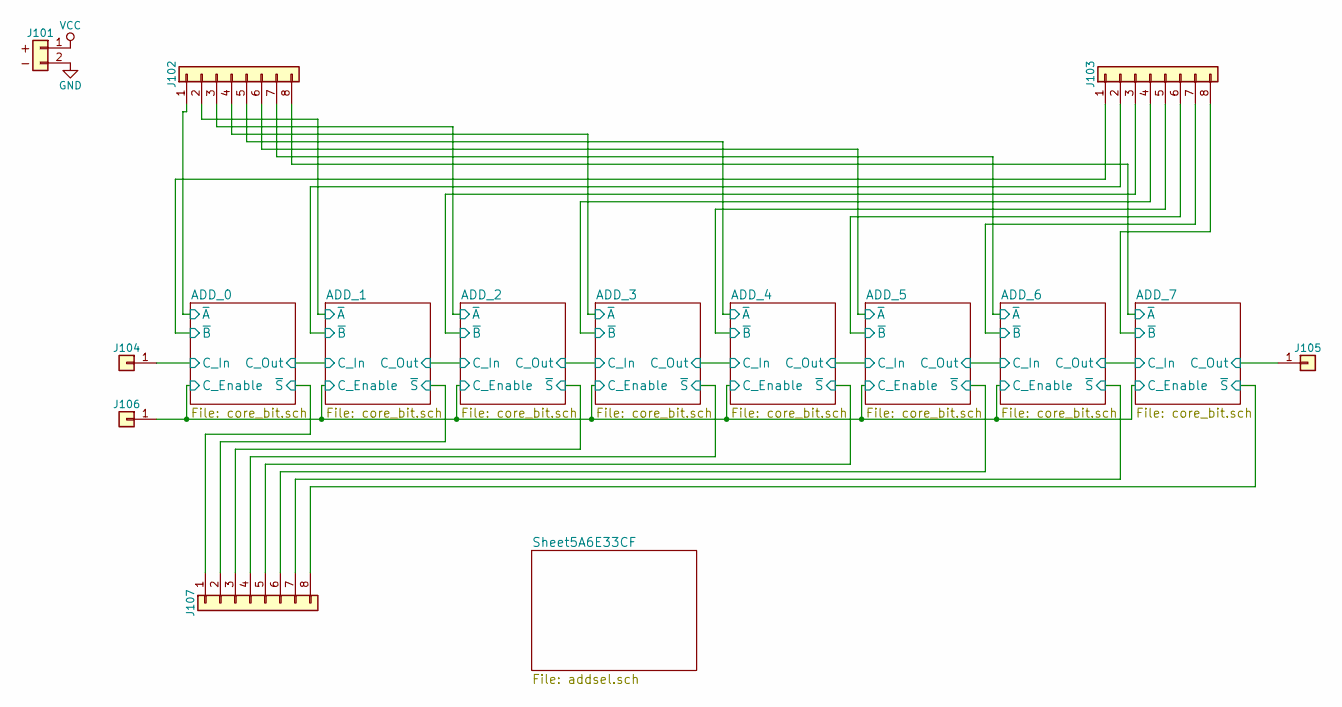
[picture p50: schematic core.sch]

Parts:
J101: Conn_01x02_Power; PH_1x2
J102, J103, J107: Conn_01x08; PH_1x8
J104, J105, J106: Conn_01x01; PH_1x1

Connections:
/ADD_0/C_Enable: J106.1; also elsewhere on the board
/ADD_0/C_In: J104.1; also elsewhere on the board
/ADD_0/~A~: J102.1; also elsewhere on the board
/ADD_0/~B~: J103.1; also elsewhere on the board
/ADD_0/~S~: J107.1; also elsewhere on the board
/ADD_1/~A~: J102.2; also elsewhere on the board
/ADD_1/~B~: J103.2; also elsewhere on the board
/ADD_1/~S~: J107.2; also elsewhere on the board
/ADD_2/~A~: J102.3; also elsewhere on the board
/ADD_2/~B~: J103.3; also elsewhere on the board
/ADD_2/~S~: J107.3; also elsewhere on the board
/ADD_3/~A~: J102.4; also elsewhere on the board
/ADD_3/~B~: J103.4; also elsewhere on the board
/ADD_3/~S~: J107.4; also elsewhere on the board
/ADD_4/~A~: J102.5; also elsewhere on the board
/ADD_4/~B~: J103.5; also elsewhere on the board
/ADD_4/~S~: J107.5; also elsewhere on the board
/ADD_5/~A~: J102.6; also elsewhere on the board
/ADD_5/~B~: J103.6; also elsewhere on the board
/ADD_5/~S~: J107.6; also elsewhere on the board
/ADD_6/~A~: J102.7; also elsewhere on the board
/ADD_6/~B~: J103.7; also elsewhere on the board
/ADD_6/~S~: J107.7; also elsewhere on the board
/ADD_7/C_Out: J105.1; also elsewhere on the board
/ADD_7/~A~: J102.8; also elsewhere on the board
/ADD_7/~B~: J103.8; also elsewhere on the board
/ADD_7/~S~: J107.8; also elsewhere on the board
GND: J101.2; also elsewhere on the board
VCC: J101.1; also elsewhere on the board

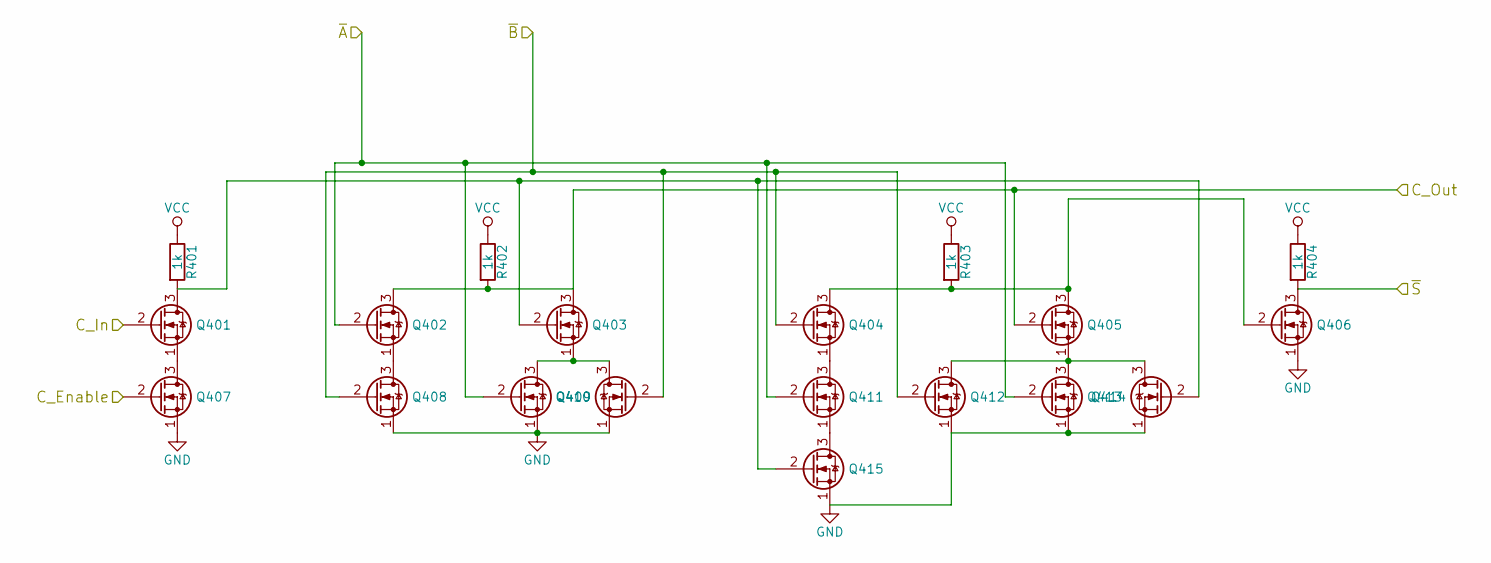
[picture p51: schematic core_bit.sch]

Parts:
Q201, Q202, Q203, Q204, Q205, Q206, Q207, Q208, Q209, Q210, Q211, Q212, Q213, Q214, Q215: 2N7000; TO-92-FET
R201, R202, R203, R204: 1k; R_small

Connections:
/ADD_0/C_Enable: Q207.2 (G); also elsewhere on the board
/ADD_0/C_In: Q201.2 (G); also elsewhere on the board
/ADD_0/~A~: Q202.2 (G), Q209.2 (G), Q211.2 (G), Q213.2 (G); also elsewhere on the board
/ADD_0/~B~: Q204.2 (G), Q208.2 (G), Q210.2 (G), Q212.2 (G); also elsewhere on the board
/ADD_0/~S~: Q206.3 (D), R204.2; also elsewhere on the board
/ADD_1/C_In: Q202.3 (D), Q203.3 (D), Q205.2 (G), R202.2; also elsewhere on the board
GND: Q206.1 (S), Q207.1 (S), Q208.1 (S), Q209.1 (S), Q210.1 (S), Q212.1 (S), Q213.1 (S), Q214.1 (S), Q215.1 (S); also elsewhere on the board
unnamed: Q201.1 (S), Q207.3 (D)
unnamed: Q201.3 (D), Q203.2 (G), Q214.2 (G), Q215.2 (G), R201.2
unnamed: Q202.1 (S), Q208.3 (D)
unnamed: Q203.1 (S), Q209.3 (D), Q210.3 (D)
unnamed: Q204.1 (S), Q211.3 (D)
unnamed: Q204.3 (D), Q205.3 (D), Q206.2 (G), R203.2
unnamed: Q205.1 (S), Q212.3 (D), Q213.3 (D), Q214.3 (D)
unnamed: Q211.1 (S), Q215.3 (D)
VCC: R201.1, R202.1, R203.1, R204.1; also elsewhere on the board

Parts of its further copies:
Q301, Q302, Q303, Q304, Q305, Q306, Q307, Q308, Q309, Q310, Q311, Q312, Q313, Q314, Q315, Q401, Q402, Q403, Q404, Q405, Q406, Q407, Q408, Q409, Q410, Q411, Q412, Q413, Q414, Q415, Q501, Q502, Q503, Q504, Q505, Q506, Q507, Q508, Q509, Q510, Q511, Q512, Q513, Q514, Q515, Q601, Q602, Q603, Q604, Q605, Q606, Q607, Q608, Q609, Q610, Q611, Q612, Q613, Q614, Q615, Q701, Q702, Q703, Q704, Q705, Q706, Q707, Q708, Q709, Q710, Q711, Q712, Q713, Q714, Q715, Q801, Q802, Q803, Q804, Q805, Q806, Q807, Q808, Q809, Q810, Q811, Q812, Q813, Q814, Q815, Q901, Q902, Q903, Q904, Q905, Q906, Q907, Q908, Q909, Q910, Q911, Q912, Q913, Q914, Q915: 2N7000; TO-92-FET
R301, R302, R303, R304, R401, R402, R403, R404, R501, R502, R503, R504, R601, R602, R603, R604, R701, R702, R703, R704, R801, R802, R803, R804, R901, R902, R903, R904: 1k; R_small

Connections of its further copies:
/ADD_0/C_Enable: Q307.2 (G), Q407.2 (G), Q507.2 (G), Q607.2 (G), Q707.2 (G), Q807.2 (G), Q907.2 (G); also elsewhere on the board
/ADD_1/C_In: Q301.2 (G); also elsewhere on the board
/ADD_1/~A~: Q302.2 (G), Q309.2 (G), Q311.2 (G), Q313.2 (G); also elsewhere on the board
/ADD_1/~B~: Q304.2 (G), Q308.2 (G), Q310.2 (G), Q312.2 (G); also elsewhere on the board
/ADD_1/~S~: Q306.3 (D), R304.2; also elsewhere on the board
/ADD_2/C_In: Q302.3 (D), Q303.3 (D), Q305.2 (G), Q401.2 (G), R302.2
/ADD_2/~A~: Q402.2 (G), Q409.2 (G), Q411.2 (G), Q413.2 (G); also elsewhere on the board
/ADD_2/~B~: Q404.2 (G), Q408.2 (G), Q410.2 (G), Q412.2 (G); also elsewhere on the board
/ADD_2/~S~: Q406.3 (D), R404.2; also elsewhere on the board
/ADD_3/C_In: Q402.3 (D), Q403.3 (D), Q405.2 (G), Q501.2 (G), R402.2
/ADD_3/~A~: Q502.2 (G), Q509.2 (G), Q511.2 (G), Q513.2 (G); also elsewhere on the board
/ADD_3/~B~: Q504.2 (G), Q508.2 (G), Q510.2 (G), Q512.2 (G); also elsewhere on the board
/ADD_3/~S~: Q506.3 (D), R504.2; also elsewhere on the board
/ADD_4/C_In: Q502.3 (D), Q503.3 (D), Q505.2 (G), Q601.2 (G), R502.2
/ADD_4/~A~: Q602.2 (G), Q609.2 (G), Q611.2 (G), Q613.2 (G); also elsewhere on the board
/ADD_4/~B~: Q604.2 (G), Q608.2 (G), Q610.2 (G), Q612.2 (G); also elsewhere on the board
/ADD_4/~S~: Q606.3 (D), R604.2; also elsewhere on the board
/ADD_5/C_In: Q602.3 (D), Q603.3 (D), Q605.2 (G), Q701.2 (G), R602.2
/ADD_5/~A~: Q702.2 (G), Q709.2 (G), Q711.2 (G), Q713.2 (G); also elsewhere on the board
/ADD_5/~B~: Q704.2 (G), Q708.2 (G), Q710.2 (G), Q712.2 (G); also elsewhere on the board
/ADD_5/~S~: Q706.3 (D), R704.2; also elsewhere on the board
/ADD_6/C_In: Q702.3 (D), Q703.3 (D), Q705.2 (G), Q801.2 (G), R702.2
/ADD_6/~A~: Q802.2 (G), Q809.2 (G), Q811.2 (G), Q813.2 (G); also elsewhere on the board
/ADD_6/~B~: Q804.2 (G), Q808.2 (G), Q810.2 (G), Q812.2 (G); also elsewhere on the board
/ADD_6/~S~: Q806.3 (D), R804.2; also elsewhere on the board
/ADD_7/C_In: Q802.3 (D), Q803.3 (D), Q805.2 (G), Q901.2 (G), R802.2
/ADD_7/C_Out: Q902.3 (D), Q903.3 (D), Q905.2 (G), R902.2; also elsewhere on the board
/ADD_7/~A~: Q902.2 (G), Q909.2 (G), Q911.2 (G), Q913.2 (G); also elsewhere on the board
/ADD_7/~B~: Q904.2 (G), Q908.2 (G), Q910.2 (G), Q912.2 (G); also elsewhere on the board
/ADD_7/~S~: Q906.3 (D), R904.2; also elsewhere on the board
GND: Q306.1 (S), Q307.1 (S), Q308.1 (S), Q309.1 (S), Q310.1 (S), Q312.1 (S), Q313.1 (S), Q314.1 (S), Q315.1 (S), Q406.1 (S), Q407.1 (S), Q408.1 (S), Q409.1 (S), Q410.1 (S), Q412.1 (S), Q413.1 (S), Q414.1 (S), Q415.1 (S), Q506.1 (S), Q507.1 (S), Q508.1 (S), Q509.1 (S), Q510.1 (S), Q512.1 (S), Q513.1 (S), Q514.1 (S), Q515.1 (S), Q606.1 (S), Q607.1 (S), Q608.1 (S), Q609.1 (S), Q610.1 (S), Q612.1 (S), Q613.1 (S), Q614.1 (S), Q615.1 (S), Q706.1 (S), Q707.1 (S), Q708.1 (S), Q709.1 (S), Q710.1 (S), Q712.1 (S), Q713.1 (S), Q714.1 (S), Q715.1 (S), Q806.1 (S), Q807.1 (S), Q808.1 (S), Q809.1 (S), Q810.1 (S), Q812.1 (S), Q813.1 (S), Q814.1 (S), Q815.1 (S), Q906.1 (S), Q907.1 (S), Q908.1 (S), Q909.1 (S), Q910.1 (S), Q912.1 (S), Q913.1 (S), Q914.1 (S), Q915.1 (S); also elsewhere on the board
unnamed: Q301.1 (S), Q307.3 (D)
unnamed: Q301.3 (D), Q303.2 (G), Q314.2 (G), Q315.2 (G), R301.2
unnamed: Q302.1 (S), Q308.3 (D)
unnamed: Q303.1 (S), Q309.3 (D), Q310.3 (D)
unnamed: Q304.1 (S), Q311.3 (D)
unnamed: Q304.3 (D), Q305.3 (D), Q306.2 (G), R303.2
unnamed: Q305.1 (S), Q312.3 (D), Q313.3 (D), Q314.3 (D)
unnamed: Q311.1 (S), Q315.3 (D)
unnamed: Q401.1 (S), Q407.3 (D)
unnamed: Q401.3 (D), Q403.2 (G), Q414.2 (G), Q415.2 (G), R401.2
unnamed: Q402.1 (S), Q408.3 (D)
unnamed: Q403.1 (S), Q409.3 (D), Q410.3 (D)
unnamed: Q404.1 (S), Q411.3 (D)
unnamed: Q404.3 (D), Q405.3 (D), Q406.2 (G), R403.2
unnamed: Q405.1 (S), Q412.3 (D), Q413.3 (D), Q414.3 (D)
unnamed: Q411.1 (S), Q415.3 (D)
unnamed: Q501.1 (S), Q507.3 (D)
unnamed: Q501.3 (D), Q503.2 (G), Q514.2 (G), Q515.2 (G), R501.2
unnamed: Q502.1 (S), Q508.3 (D)
unnamed: Q503.1 (S), Q509.3 (D), Q510.3 (D)
unnamed: Q504.1 (S), Q511.3 (D)
unnamed: Q504.3 (D), Q505.3 (D), Q506.2 (G), R503.2
unnamed: Q505.1 (S), Q512.3 (D), Q513.3 (D), Q514.3 (D)
unnamed: Q511.1 (S), Q515.3 (D)
unnamed: Q601.1 (S), Q607.3 (D)
unnamed: Q601.3 (D), Q603.2 (G), Q614.2 (G), Q615.2 (G), R601.2
unnamed: Q602.1 (S), Q608.3 (D)
unnamed: Q603.1 (S), Q609.3 (D), Q610.3 (D)
unnamed: Q604.1 (S), Q611.3 (D)
unnamed: Q604.3 (D), Q605.3 (D), Q606.2 (G), R603.2
unnamed: Q605.1 (S), Q612.3 (D), Q613.3 (D), Q614.3 (D)
unnamed: Q611.1 (S), Q615.3 (D)
unnamed: Q701.1 (S), Q707.3 (D)
unnamed: Q701.3 (D), Q703.2 (G), Q714.2 (G), Q715.2 (G), R701.2
unnamed: Q702.1 (S), Q708.3 (D)
unnamed: Q703.1 (S), Q709.3 (D), Q710.3 (D)
unnamed: Q704.1 (S), Q711.3 (D)
unnamed: Q704.3 (D), Q705.3 (D), Q706.2 (G), R703.2
unnamed: Q705.1 (S), Q712.3 (D), Q713.3 (D), Q714.3 (D)
unnamed: Q711.1 (S), Q715.3 (D)
unnamed: Q801.1 (S), Q807.3 (D)
unnamed: Q801.3 (D), Q803.2 (G), Q814.2 (G), Q815.2 (G), R801.2
unnamed: Q802.1 (S), Q808.3 (D)
unnamed: Q803.1 (S), Q809.3 (D), Q810.3 (D)
unnamed: Q804.1 (S), Q811.3 (D)
unnamed: Q804.3 (D), Q805.3 (D), Q806.2 (G), R803.2
unnamed: Q805.1 (S), Q812.3 (D), Q813.3 (D), Q814.3 (D)
unnamed: Q811.1 (S), Q815.3 (D)
unnamed: Q901.1 (S), Q907.3 (D)
unnamed: Q901.3 (D), Q903.2 (G), Q914.2 (G), Q915.2 (G), R901.2
unnamed: Q902.1 (S), Q908.3 (D)
unnamed: Q903.1 (S), Q909.3 (D), Q910.3 (D)
unnamed: Q904.1 (S), Q911.3 (D)
unnamed: Q904.3 (D), Q905.3 (D), Q906.2 (G), R903.2
unnamed: Q905.1 (S), Q912.3 (D), Q913.3 (D), Q914.3 (D)
unnamed: Q911.1 (S), Q915.3 (D)
VCC: R301.1, R302.1, R303.1, R304.1, R401.1, R402.1, R403.1, R404.1, R501.1, R502.1, R503.1, R504.1, R601.1, R602.1, R603.1, R604.1, R701.1, R702.1, R703.1, R704.1, R801.1, R802.1, R803.1, R804.1, R901.1, R902.1, R903.1, R904.1; also elsewhere on the board

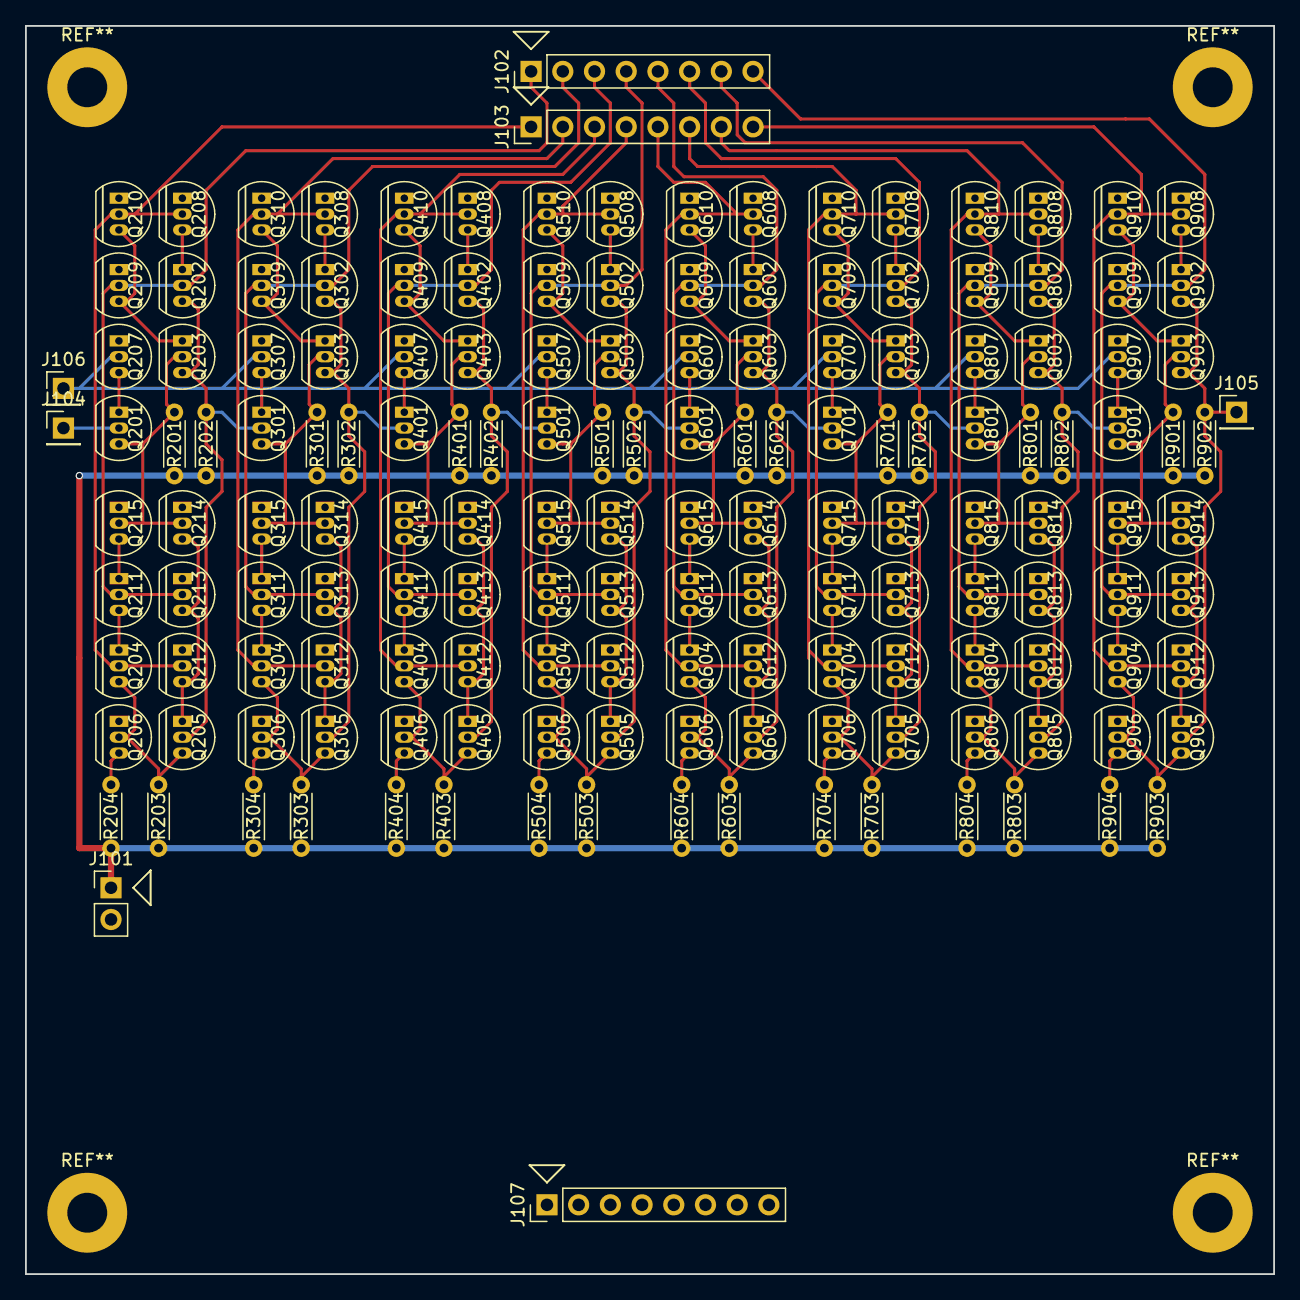
[picture p52: board designs/adder/core (copy 1)/core.kicad_pcb from above]

Board: 2 copper layers, 100.0 x 100.0 mm, 159 parts (0 on the bottom side), 100 nets.
