davidv1992/Trans1/designs/register/register.kicad_pcb

## KiCad design designs/register/register.kicad_pcb (2019-08-27)

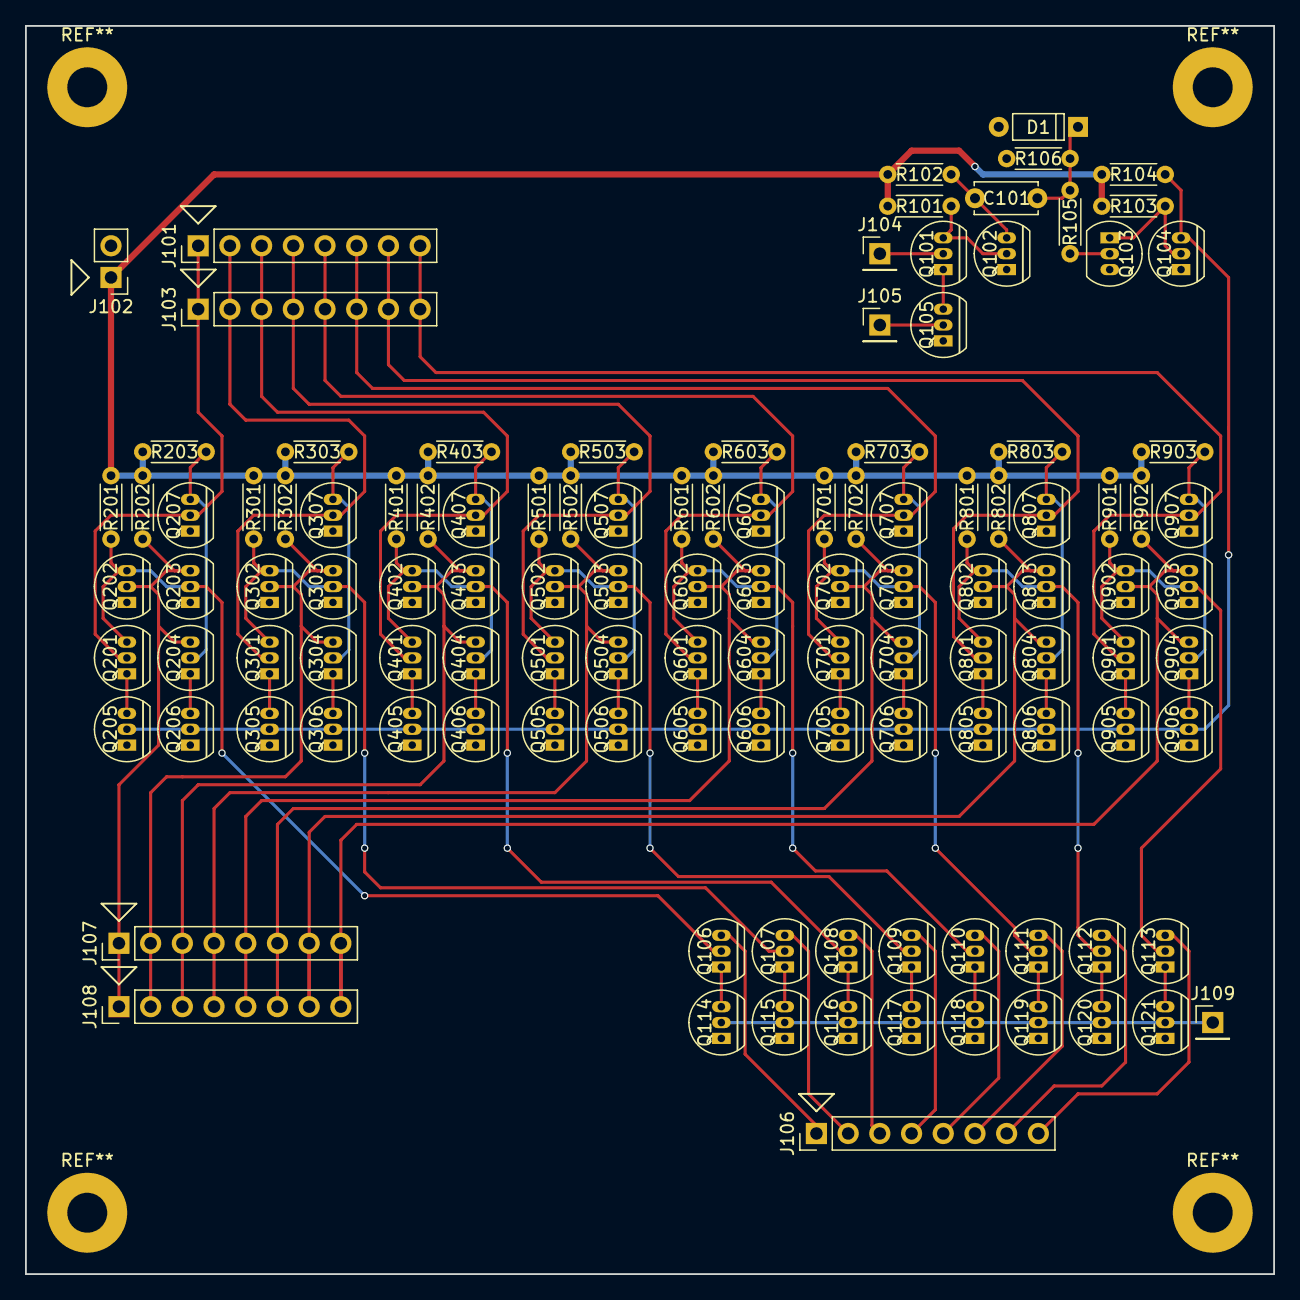
[picture p53: board register.kicad_pcb from above]

Board: 2 copper layers, 100.0 x 100.0 mm, 118 parts (0 on the bottom side), 76 nets.

Parts:
C101: 100pF; C_default
D1: 1N4148; D_default
J101, J103, J106, J107, J108: Conn_01x08; PH_1x8
J102: Conn_01x02_Power; PH_1x2
J104, J105, J109: Conn_01x01; PH_1x1
Q101, Q102, Q104, Q105, Q106, Q107, Q108, Q109, Q110, Q111, Q112, Q113, Q114, Q115, Q116, Q117, Q118, Q119, Q120, Q121, Q201, Q202, Q203, Q204, Q205, Q206, Q207, Q301, Q302, Q303, Q304, Q305, Q306, Q307, Q401, Q402, Q403, Q404, Q405, Q406, Q407, Q501, Q502, Q503, Q504, Q505, Q506, Q507, Q601, Q602, Q603, Q604, Q605, Q606, Q607, Q701, Q702, Q703, Q704, Q705, Q706, Q707, Q801, Q802, Q803, Q804, Q805, Q806, Q807, Q901, Q902, Q903, Q904, Q905, Q906, Q907: 2N7000; TO-92-FET
Q103: BC547; TO-92-BJT
R101, R102, R103, R104, R201, R202, R203, R301, R302, R303, R401, R402, R403, R501, R502, R503, R601, R602, R603, R701, R702, R703, R801, R802, R803, R901, R902, R903: 1k; R_small
R105, R106: 10k; R_small

Connections:
/df1/Clock: Q104.3, Q205.2, Q206.2, Q305.2, Q306.2, Q405.2, Q406.2, Q505.2, Q506.2, Q605.2, Q606.2, Q705.2, Q706.2, Q805.2, Q806.2, Q905.2, Q906.2, R104.2
/df1/Data: J101.1, J103.1, Q201.2, Q207.2
/df1/Q: J107.1, J108.1, Q202.2, Q203.3, Q204.3, R202.2
/df1/~Q~: Q106.2, Q201.3, Q202.3, Q203.2, R201.2
/df2/Data: J101.2, J103.2, Q301.2, Q307.2
/df2/Q: J107.2, J108.2, Q302.2, Q303.3, Q304.3, R302.2
/df2/~Q~: Q107.2, Q301.3, Q302.3, Q303.2, R301.2
/df3/Data: J101.3, J103.3, Q401.2, Q407.2
/df3/Q: J107.3, J108.3, Q402.2, Q403.3, Q404.3, R402.2
/df3/~Q~: Q108.2, Q401.3, Q402.3, Q403.2, R401.2
/df4/Data: J101.4, J103.4, Q501.2, Q507.2
/df4/Q: J107.4, J108.4, Q502.2, Q503.3, Q504.3, R502.2
/df4/~Q~: Q109.2, Q501.3, Q502.3, Q503.2, R501.2
/df5/Data: J101.5, J103.5, Q601.2, Q607.2
/df5/Q: J107.5, J108.5, Q602.2, Q603.3, Q604.3, R602.2
/df5/~Q~: Q110.2, Q601.3, Q602.3, Q603.2, R601.2
/df6/Data: J101.6, J103.6, Q701.2, Q707.2
/df6/Q: J107.6, J108.6, Q702.2, Q703.3, Q704.3, R702.2
/df6/~Q~: Q111.2, Q701.3, Q702.3, Q703.2, R701.2
/df7/Data: J101.7, J103.7, Q801.2, Q807.2
/df7/Q: J107.7, J108.7, Q802.2, Q803.3, Q804.3, R802.2
/df7/~Q~: Q112.2, Q801.3, Q802.3, Q803.2, R801.2
/df8/Data: J101.8, J103.8, Q901.2, Q907.2
/df8/Q: J107.8, J108.8, Q902.2, Q903.3, Q904.3, R902.2
/df8/~Q~: Q113.2, Q901.3, Q902.3, Q903.2, R901.2
GND: D1.2, J102.2, Q102.1, Q103.3, Q104.1, Q105.1, Q114.1, Q115.1, Q116.1, Q117.1, Q118.1, Q119.1, Q120.1, Q121.1, Q202.1, Q203.1, Q205.1, Q206.1, Q207.1, Q302.1, Q303.1, Q305.1, Q306.1, Q307.1, Q402.1, Q403.1, Q405.1, Q406.1, Q407.1, Q502.1, Q503.1, Q505.1, Q506.1, Q507.1, Q602.1, Q603.1, Q605.1, Q606.1, Q607.1, Q702.1, Q703.1, Q705.1, Q706.1, Q707.1, Q802.1, Q803.1, Q805.1, Q806.1, Q807.1, Q902.1, Q903.1, Q905.1, Q906.1, Q907.1, R106.2
unnamed: C101.1, Q102.3, R102.2
unnamed: C101.2, D1.1, R105.2, R106.1
unnamed: J104.1, Q101.2
unnamed: J105.1, Q105.2
unnamed: J106.1, Q106.3
unnamed: J106.2, Q107.3
unnamed: J106.3, Q108.3
unnamed: J106.4, Q109.3
unnamed: J106.5, Q110.3
unnamed: J106.6, Q111.3
unnamed: J106.7, Q112.3
unnamed: J106.8, Q113.3
unnamed: J109.1, Q114.2, Q115.2, Q116.2, Q117.2, Q118.2, Q119.2, Q120.2, Q121.2
unnamed: Q101.1, Q105.3
unnamed: Q101.3, Q102.2, R101.2
unnamed: Q103.1, Q104.2, R103.2
unnamed: Q103.2, R105.1
unnamed: Q106.1, Q114.3
unnamed: Q107.1, Q115.3
unnamed: Q108.1, Q116.3
unnamed: Q109.1, Q117.3
unnamed: Q110.1, Q118.3
unnamed: Q111.1, Q119.3
unnamed: Q112.1, Q120.3
unnamed: Q113.1, Q121.3
unnamed: Q201.1, Q205.3
unnamed: Q204.1, Q206.3
unnamed: Q204.2, Q207.3, R203.2
unnamed: Q301.1, Q305.3
unnamed: Q304.1, Q306.3
unnamed: Q304.2, Q307.3, R303.2
unnamed: Q401.1, Q405.3
unnamed: Q404.1, Q406.3
unnamed: Q404.2, Q407.3, R403.2
unnamed: Q501.1, Q505.3
unnamed: Q504.1, Q506.3
unnamed: Q504.2, Q507.3, R503.2
unnamed: Q601.1, Q605.3
unnamed: Q604.1, Q606.3
unnamed: Q604.2, Q607.3, R603.2
unnamed: Q701.1, Q705.3
unnamed: Q704.1, Q706.3
unnamed: Q704.2, Q707.3, R703.2
unnamed: Q801.1, Q805.3
unnamed: Q804.1, Q806.3
unnamed: Q804.2, Q807.3, R803.2
unnamed: Q901.1, Q905.3
unnamed: Q904.1, Q906.3
unnamed: Q904.2, Q907.3, R903.2
VCC: J102.1, R101.1, R102.1, R103.1, R104.1, R201.1, R202.1, R203.1, R301.1, R302.1, R303.1, R401.1, R402.1, R403.1, R501.1, R502.1, R503.1, R601.1, R602.1, R603.1, R701.1, R702.1, R703.1, R801.1, R802.1, R803.1, R901.1, R902.1, R903.1
