davidv1992/Trans1/(commit log)

2018-01-07 Added assembler.
2018-01-07 Added sample programs and sample roms.
2018-01-17 Added kicad component libraries.
2018-01-17 Added clock design.
    [clock.kicad_pcb, clock.sch]
2018-01-17 Added register board design.
    [dflipflop.sch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]
2019-08-27 Updated sample roms and asm samplies
2019-08-27 Updated register design to fix small flaw.
    [dflipflop.sch, register.kicad_pcb, register.sch]
2019-08-27 Updated clock design.
    [clock.sch]
2019-08-27 Updated component libraries to add components for memory and diode.
2019-08-27 Added adder design.
    [Asel.sch, BDEC.sch, Bsel.sch, Cstore.sch, OutDEC.sch, Zstore.sch, addsel.sch, control.kicad_pcb]
2019-08-27 Added design for program counter.
    [pc-B.Cu.gbr, pc-B.Mask.gbr, pc-B.SilkS.gbr, pc-Edge.Cuts.gbr, pc-F.Cu.gbr, pc-F.Mask.gbr, pc-F.SilkS.gbr, pc.drl]
2019-08-27 Added mechanical eprom board design.
    [eprom-B.Cu.gbr, eprom-B.Mask.gbr, eprom-B.SilkS.gbr, eprom-Edge.Cuts.gbr, eprom-F.Cu.gbr, eprom-F.Mask.gbr, eprom-F.SilkS.gbr, eprom.drl]
2019-08-27 Added logisim simulation of cpu.
    [processor.circ]
2019-09-25 Added led component and footprint.
2019-09-25 Added test IO module.
    [testio.kicad_pcb, testio.sch]
2025-08-03 Latest design work updates.
    [PC.sch, Tbus.sch, Ten.sch, bus.sch, clear.sch, connectors.sch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]
